JRDMcLAREN/proteus-V2.0/readme_pinout.md

# Proteus Pinout & Wiring

### [Please use the official rusEfi Proteus docs here.](https://github.com/rusefi/rusefi/wiki/Proteus-Manual)
