JRDMcLAREN/proteus-V2.0/proteus.csv

Id | Designator | Footprint | Quantity | Designation | Supplier and ref
1 | C1015,C1016,C1017,C1018,C1523,C1002,C1212 | C_0603_1608Metric | 7 | 1u
2 | R902,R903,R904,R901,R801,R704,R804,R803,R802,R703,R702,R701,R1903,R1904 | R_0603_1608Metric | 14 | 470k
3 | R1007,R1006,R1502,R1504,R1001,R1513,R5,R6,R7,R8,R13,R14,R15,R16,R21,R22,R23,R24,R29,R30,R32,R31,R905,R1105,R1107,R1109,R1111,R48 | R_0603_1608Metric | 28 | 10k
4 | U801,U901,U1101,U701,U5 | TSSOP-14_4.4x5mm_P0.65mm | 5 | MCP6004
5 | U1004,U1005 | Infineon_PG-DSO-8-43 | 2 | TLS115
6 | C701,C801,C901,C1503,C1505,C1501,C1101,C1516,C1508,C1509,C1510,C1511,C1513,C1504,C1604,C1607,C1701,C1704,C1801,C1804,C1211,C1409,C1517,C904,C1520,C20 | C_0603_1608Metric | 26 | 100n
7 | C1518,C1519 | C_0603_1608Metric | 2 | 2.2u
8 | C1521,C1522 | C_0603_1608Metric | 2 | 33p
9 | C1506,C1507,C1502,C1515,C1006,C1512,C903,C30 | C_0603_1608Metric | 8 | 4.7u
10 | FB1501 | L_0805_2012Metric | 1 | Ferrite_Bead
11 | R1101,R1102,R1103,R1104,R1203,R1204,R1401,R1402,R1407,R1408,R1201,R1202,R1403,R1404,R1405,R1406 | R_0603_1608Metric | 16 | 2.7k
12 | RN701,RN801,RN901,RN1101,RN1301 | R_Array_Convex_4x0603 | 5 | 10k
13 | C1201,C1004,C906,C18,C19,C27 | C_1206_3216Metric | 6 | 10u
14 | C1202,C1203,C1301,C1302,C1304,C1605,C1606,C1608,C1609,C1702,C1703,C1705,C1706,C1802,C1803,C1806,C1805,C902,C1303,C1903,C28,C29 | C_0603_1608Metric | 22 | 10n
15 | R1501,R44,R45,R1901,R1902 | R_0603_1608Metric | 5 | 100k
16 | U1501 | LQFP-144_20x20mm_P0.5mm | 1 | STM32F427ZGTx
17 | R1004,R1106,R1108,R1110,R1112,R33 | R_0603_1608Metric | 6 | 120
18 | U502,U501,U402,U401,U302,U301,U202,U201 | SOIC-8_3.9x4.9mm_P1.27mm | 8 | VNLD5160
19 | RN501,RN401,RN201,RN301,RN202,RN302,RN402,RN502,RN1601,RN1701,RN1801 | R_Array_Convex_4x0603 | 11 | 1k
20 | D903,D901,D101,D102,D103,D104 | D_SMA | 6 | D_Schottky
21 | R1601,R1602,R1603,R1604,R1701,R1702,R1703,R1704,R1801,R1802,R1803,R1804 | R_0805_2012Metric | 12 | 100
22 | U1602,U1603,U1701,U1702,U1801,U1802 | SOIC-8_3.9x4.9mm_P1.27mm | 6 | MIC4427
23 | D1502,D1506 | LED_0603_1608Metric_Castellated | 2 | GREEN
24 | R1508,R1509,R1510,R1511,R1512 | R_0603_1608Metric | 5 | 330
25 | R1215,R1216,R1205,R1206,R1208,R1209,R1211,R1213,R1214,R1210,R34,R35,R36,R37 | R_0805_2012Metric | 14 | 4.7k
26 | U1203,U1204 | MSOP-10_3x3mm_P0.5mm | 2 | MAX9924
27 | C1208,C1402,C1407,C1408,C1209,C1210,C1401,C1207,C1406,C1204,C1205,C1403,C1404,C1405 | C_0603_1608Metric | 14 | 1n
28 | R1212,R1207 | R_0805_2012Metric | 2 | DNP
29 | D1503,D3,D4 | D_SOD-123 | 3 | schottky
30 | F101,F102 | R_1206_3216Metric | 2 | Polyfuse
31 | D1504 | LED_0603_1608Metric_Castellated | 1 | RED
32 | D1505 | LED_0603_1608Metric_Castellated | 1 | BLUE
33 | D1507 | LED_0603_1608Metric_Castellated | 1 | ORANGE
34 | J105,J107,J108 | TestPoint_Pad_D3.0mm | 3 | Conn_01x01
35 | U1502 | SOT-23-6 | 1 | USBLC6-2SC6
36 | D1,D2 | SOT-323_SC-70 | 2 | PESD1CAN-UX
37 | J1504 | conn_5_2.5mm | 1 | USB_B
38 | D1001 | D_SMC | 1 | SM15T33CA
39 | R2,R3,R10,R11,R12,R17,R18,R19,R20,R25,R26,R27,R28,R4,R9,R1 | R_0603_1608Metric | 16 | 5.6k
40 | U1,U2,U3,U4,D1501,U1106,U1107 | SOT-23-6 | 7 | SRV05-4
41 | C23,C24,C905 | C_0603_1608Metric | 3 | 330p
42 | R46,R47,R38,R40 | R_0603_1608Metric | 4 | 33k
43 | ,,,,,,,,,,,,,,,,,,,,,,,,,,,,,,,,,,,,,,,,,,,,,,,,,,,,,,,,,,,,,,,,,,,,,,,,,,,,,,,,,,,,,,,,,,,,,,,,,,,,,,,,,,,,,,,,,,,,,,,,,,,,,,,,,,,,,,,,,,,,,,,,,,,,,,,,,,,,,,,,,,,,,,,,,,,,,,,,,,,,,,,,,,,,,,,,,,,,,,,,,,,,,,,,,,,,,,,,,,,,,,,,,,,,,,,,,,,,,,,,,,,,,,,,,,,,,,,,,,,,,,,,,,,,,,,,,,,,,,,,,,,,,,,,,,,,,,,,,,,,,,,,,,,,,,,,,,,,,,,,,,,,,,,,,,,,,,,,,,,,,,,,,, |  | 347
44 | R906 | R_0603_1608Metric | 1 | 1
45 | U902 | SOT-223-3_TabPin2 | 1 | AMS1117-3.3
46 | Y1501 | Crystal_SMD_5032-2Pin_5.0x3.2mm | 1 | 8MHz
47 | R908 | R_0603_1608Metric | 1 | 68k
48 | U903 | SOIC-8-1EP_3.9x4.9mm_P1.27mm_EP2.29x3mm | 1 | LMR14020
49 | U904,U6 | SOIC-8_3.9x4.9mm_P1.27mm | 2 | TJA1051T-3
50 | R907,R42,R43 | R_0603_1608Metric | 3 | 12k
51 | REF**,REF**,REF** | Fiducial_1.5mm_Mask3mm | 3 | Fiducial_1.5mm_Mask3mm
52 | R1217,R1218,R39,R41 | R_0603_1608Metric | 4 | 1k
53 | R1219,R1220 | R_0805_2012Metric_Pad1.15x1.40mm_HandSolder | 2 | DNP
54 | L1002 | L_1210_3225Metric | 1 | 2.2u
55 | U1103,U1104,U1105,U1102 | SOIC-8_3.9x4.9mm_P1.27mm | 4 | BTS4175SGA
56 | L1001 | MWSA0503 | 1 | 10u
57 | C1901,C1902 | C_0805_2012Metric | 2 | 3.3n
58 | C21,C22 | C_0603_1608Metric | 2 | 680p
59 | C25,C26 | C_0603_1608Metric | 2 | 47p
60 | U1207,U1202,U1208 | SOT-23-6 | 3 | SN74LVC2G17DB
61 | JP1,JP2 | SolderJumper-2_P1.3mm_Open_TrianglePad1.0x1.5mm | 2 | Jumper_NO_Small
62 | J1 | microSD_HC_Wuerth_693072010801 | 1 | Micro_SD_Card
63 | J3 | Jack_3.5mm_CUI_SJ1-3533NG_Horizontal | 1 | AudioJack3
64 | U7 | SOIC-8_3.9x4.9mm_P1.27mm | 1 | MCP6002-xSN
65 | U8 | SOT-23 | 1 | REF3333
66 | U9 | ST_HLGA-10_2.5x2.5mm_P0.6mm_LayoutBorder3x2y | 1 | LPS25HB
67 | SW1501,SW1502 | SW_SPST_EVQQ2 | 2 | SW_Push
68 | J4 | Tag-Connect_TC2030-IDC-NL_2x03_P1.27mm_Vertical | 1 | Conn_01x06
69 | U10,U11 | Infineon_PG-DSO-12-9 | 2 | TLE9201SG
70 | R1503 | R_0603_1608Metric | 1 | 82k
71 | J1505 | PinHeader_2x06_P2.54mm_Vertical | 1 | Conn_02x06_Top_Bottom
72 | C17x1,C1001x1 | CP_Elec_6.3x9.9 | 2 | 56u
73 | J5 | PinSocket_2x01_P2.54mm_Vertical | 1 | Conn_01x02
74 | CN1,CN3,CN2,CN4 | R_Array_Convex_4x0603 | 4 | 100n
75 | JP1201 | SolderJumper-3_P1.3mm_Bridged12_RoundedPad1.0x1.5mm | 1 | Jumper_3_Bridged12
76 | TP-OUT4 | TestPoint_Pad_D1.0mm | 1 | TestPoint-OUT4
77 | LOGO | mre_logo | 1 | LOGO
78 | TP-IN4 | TestPoint_Pad_D1.0mm | 1 | TestPoint-IN4
79 | C1001,C17 | CP_Radial_D8.0mm_P3.50mm | 2 | 56u
80 | J102 | ampseal-35 | 1 | Conn_01x35
81 | J103 | ampseal-35-2 | 1 | Conn_01x35
82 | J101 | ampseal-23 | 1 | Conn_01x23
83 | J1501 | USB_B_TE_5787834_Vertical | 1 | USB_B
84 | BT1 | BatteryHolder_Keystone_1060_1x2032 | 1 | Battery_Cell
85 | JP3,JP4 | SolderJumper-2_P1.3mm_Bridged_Pad1.0x1.5mm | 2 | SolderJumper_2_Bridged
86 | PB15 | TestPoint_Pad_D1.0mm | 1 | PB15
87 | J1506 | USB_Micro-B_Wuerth_614105150721_Vertical | 1 | USB_B_Micro
88 | PG15 | TestPoint_Pad_D1.0mm | 1 | PG15
89 | J1507 | PinSocket_2x05_P2.54mm_Vertical_SMD | 1 | Conn_02x05_Odd_Even
90 | PB14 | TestPoint_Pad_D1.0mm | 1 | PB14
