JRDMcLAREN/proteus-V2.0/export/proteus-case.step

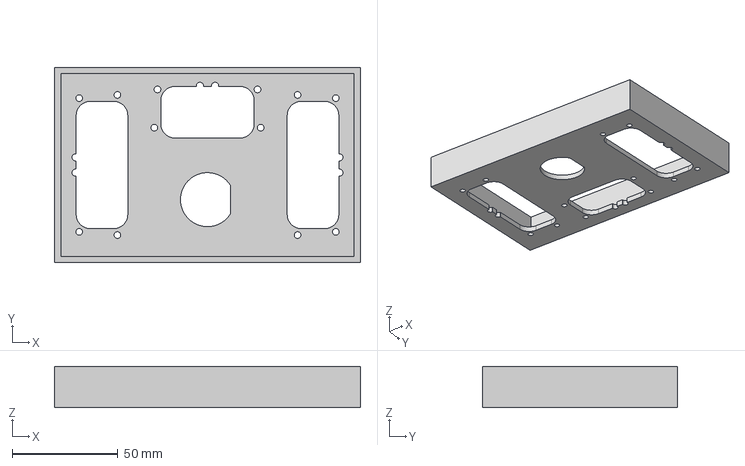
[picture p1: CAD file, 2026-11-01]
export/proteus-case.step
145.0 x 92.5 x 19.6 mm
