JRDMcLAREN/proteus-V2.0/changelog.md

# Changelog

## Proteus 2.0  - November 2026
 - 2-layer version
 - All passive components are size 0603 (uniform size)
 - MicroUSB socket added
 - Board completely redesigned; components, traces, etc.
 - 4x M3.5 mounting holes added
 - Alternative footprints added on the TOP side for electrolytic capacitors (C17, C1001)
 - AUX connectors for SPI and UART consolidated into a single 2x6-pin header (including power supply)
 - 2-pin connector added for an (external) RTC battery
 - Programming connector changed to a 2x5-pin header for the ST-Link programmer (matching the MRE)
 - Solder pads added for "RX/TX swapping" – for communication modules that require these signals to be swapped.
 
## Proteus 0.7
 - Reduce BOM lines somewhat, replacing similar components with identical components.
 - Add RTC/backup battery

## Proteus 0.6
 - Switch to TLE9202 ETB driver due to shortage of TLE9201
 - Switch to STM32F767ZG due to shortage of STM32F42x

## Proteus 0.4
 - knock sense with headset jack
 - SD card
 - USB removed from 23 pin connector

## Proteus 0.3
 - first large batch
 - incompatible pinout change mostly on the 23 pin plug

## Proteus 0.2
 - USB footprint fix

## Proteus 0.1
 - it's alive!!!
