JRDMcLAREN/proteus-V2.0/export/v2.0/proteus_schematic_v2.0.pdf

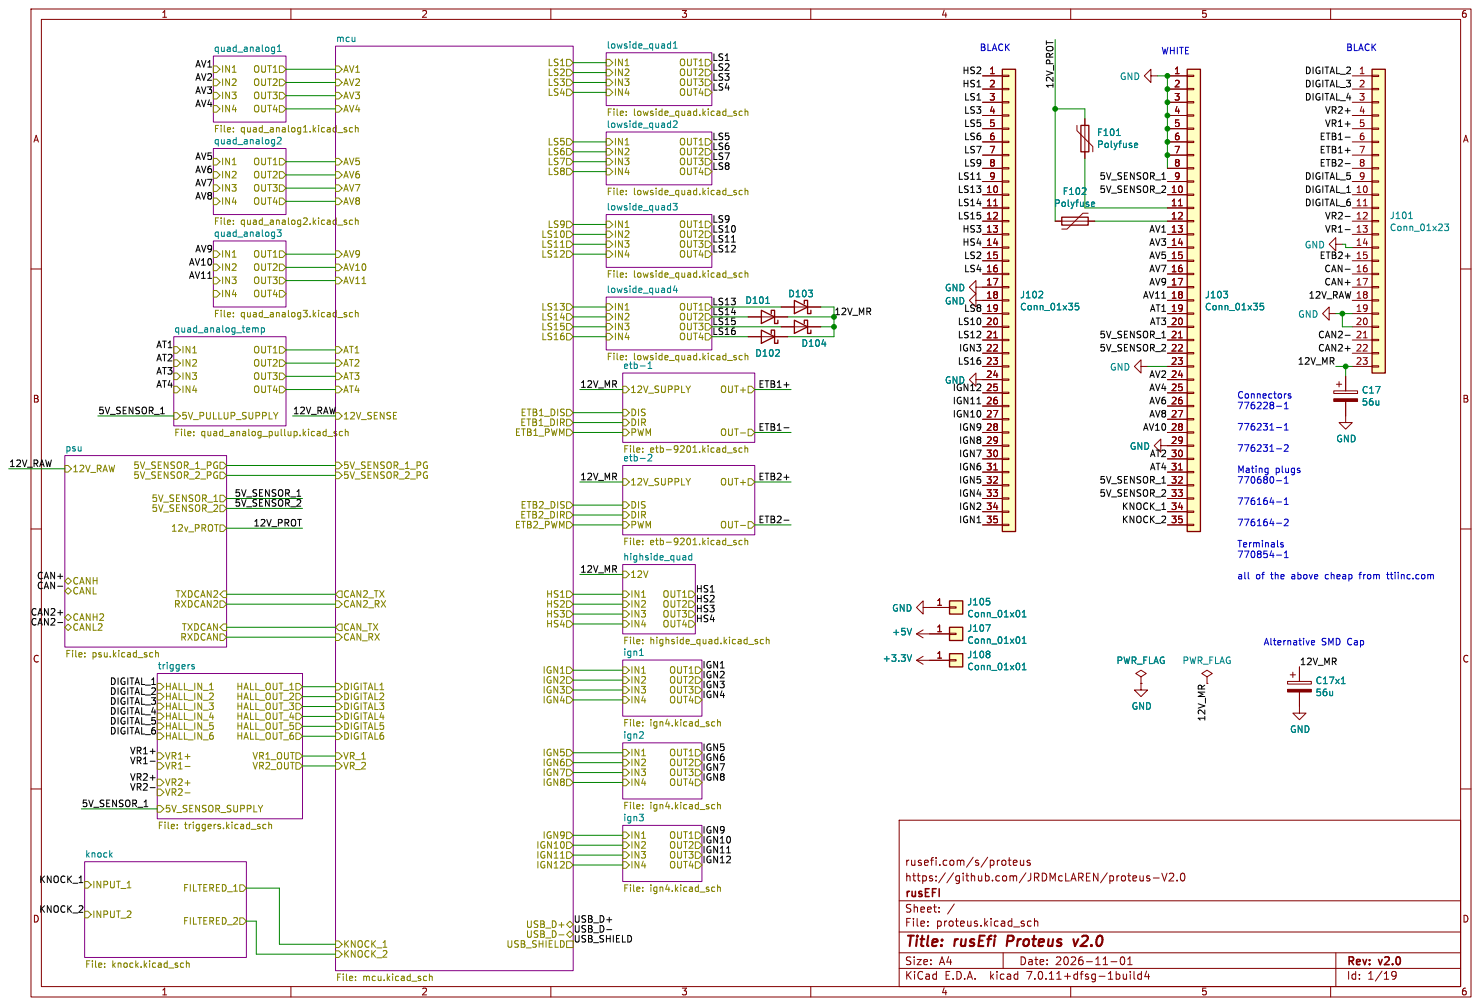
[picture p2: page 1]

all of the above cheap from ttiinc.com

rusefi.com/s/proteus
File: proteus.kicad_sch Sheet: / rusEFI https://github.com/JRDMcLAREN/proteus-V2.0

Id: 1/19 Title: rusEfi Proteus v2.0

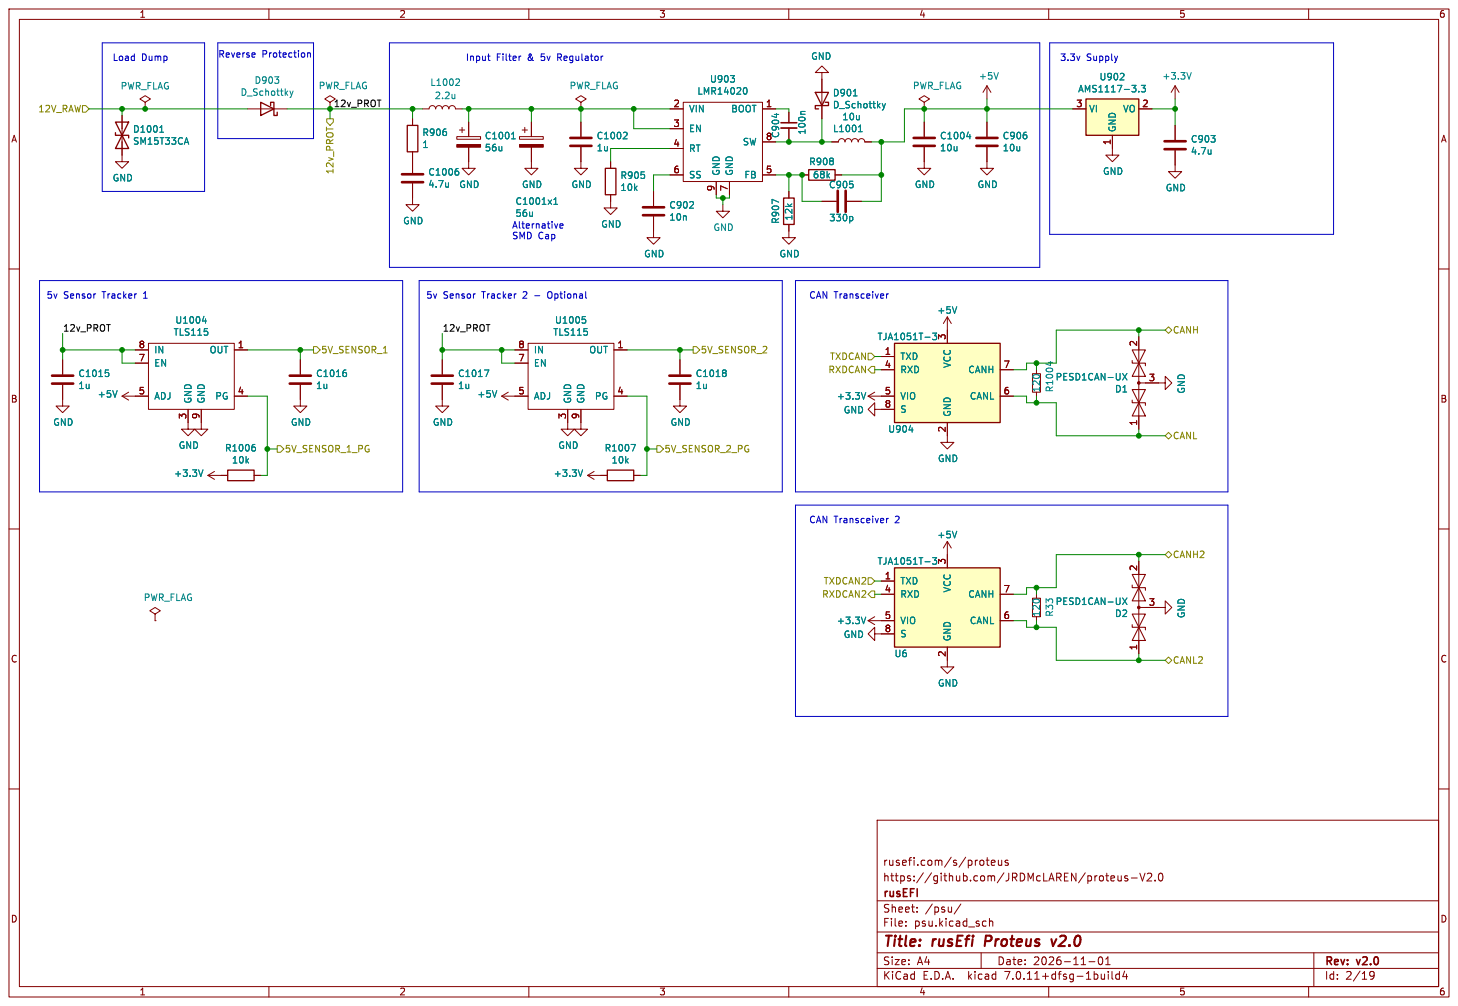
[picture p3: page 2]

3 RXD 4 VIO 5 CANL 6 CANH 7 S
8 U6 TJA1051T-3 GND

rusefi.com/s/proteus GND

File: psu.kicad_sch Sheet: /psu/ rusEFI https://github.com/JRDMcLAREN/proteus-V2.0

Id: 2/19 Title: rusEfi Proteus v2.0

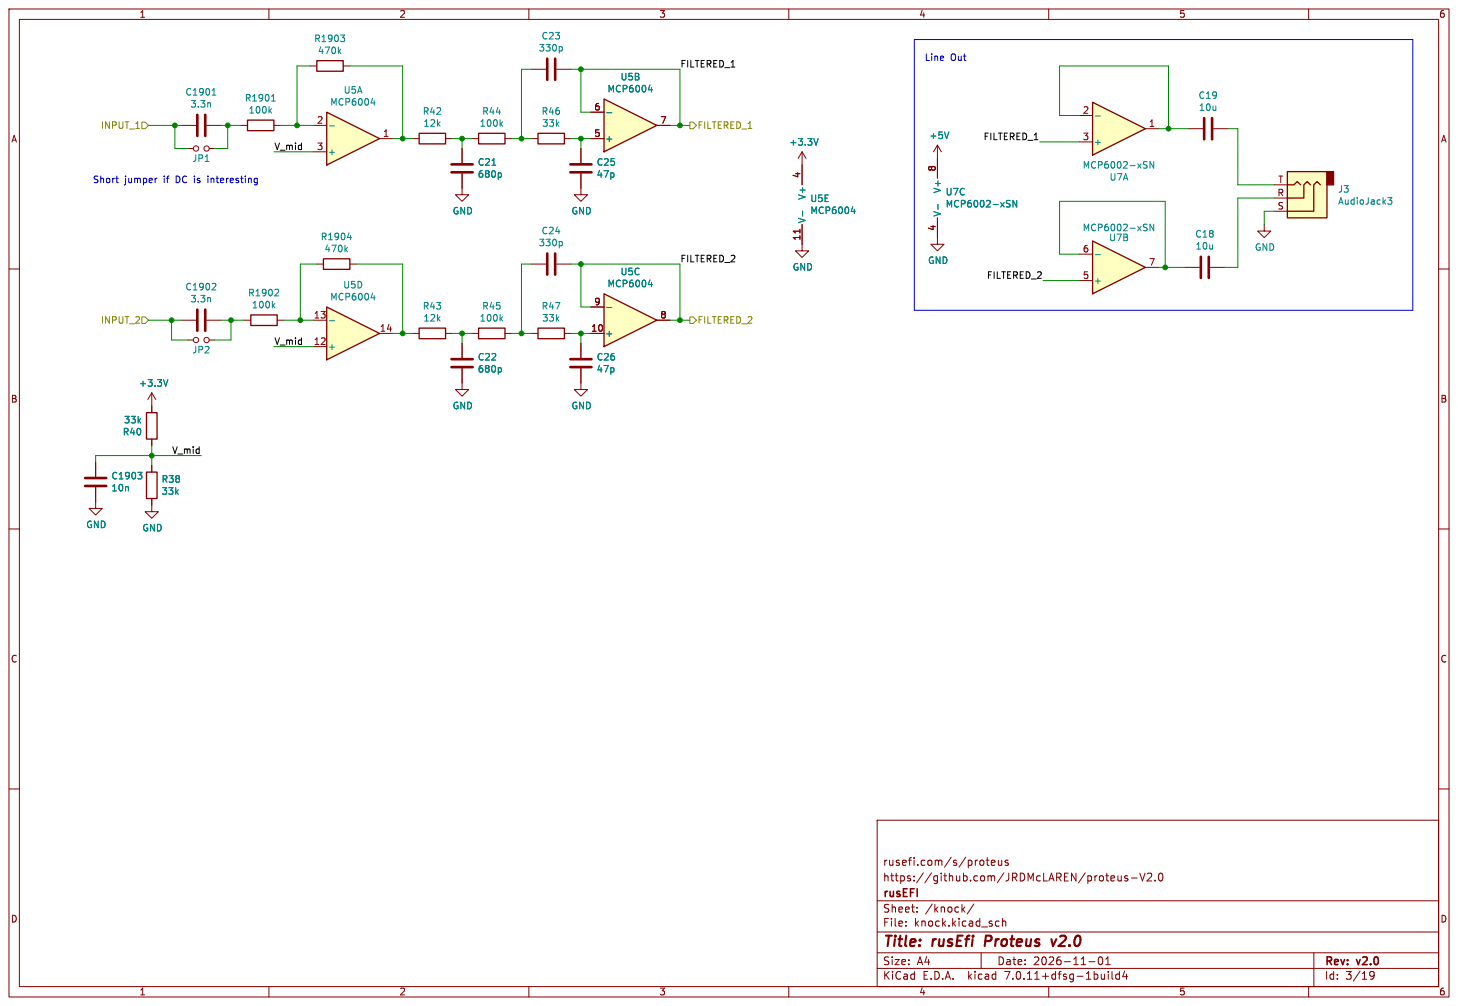
[picture p4: page 3]

rusefi.com/s/proteus
File: knock.kicad_sch Sheet: /knock/ rusEFI https://github.com/JRDMcLAREN/proteus-V2.0

Id: 3/19 Title: rusEfi Proteus v2.0

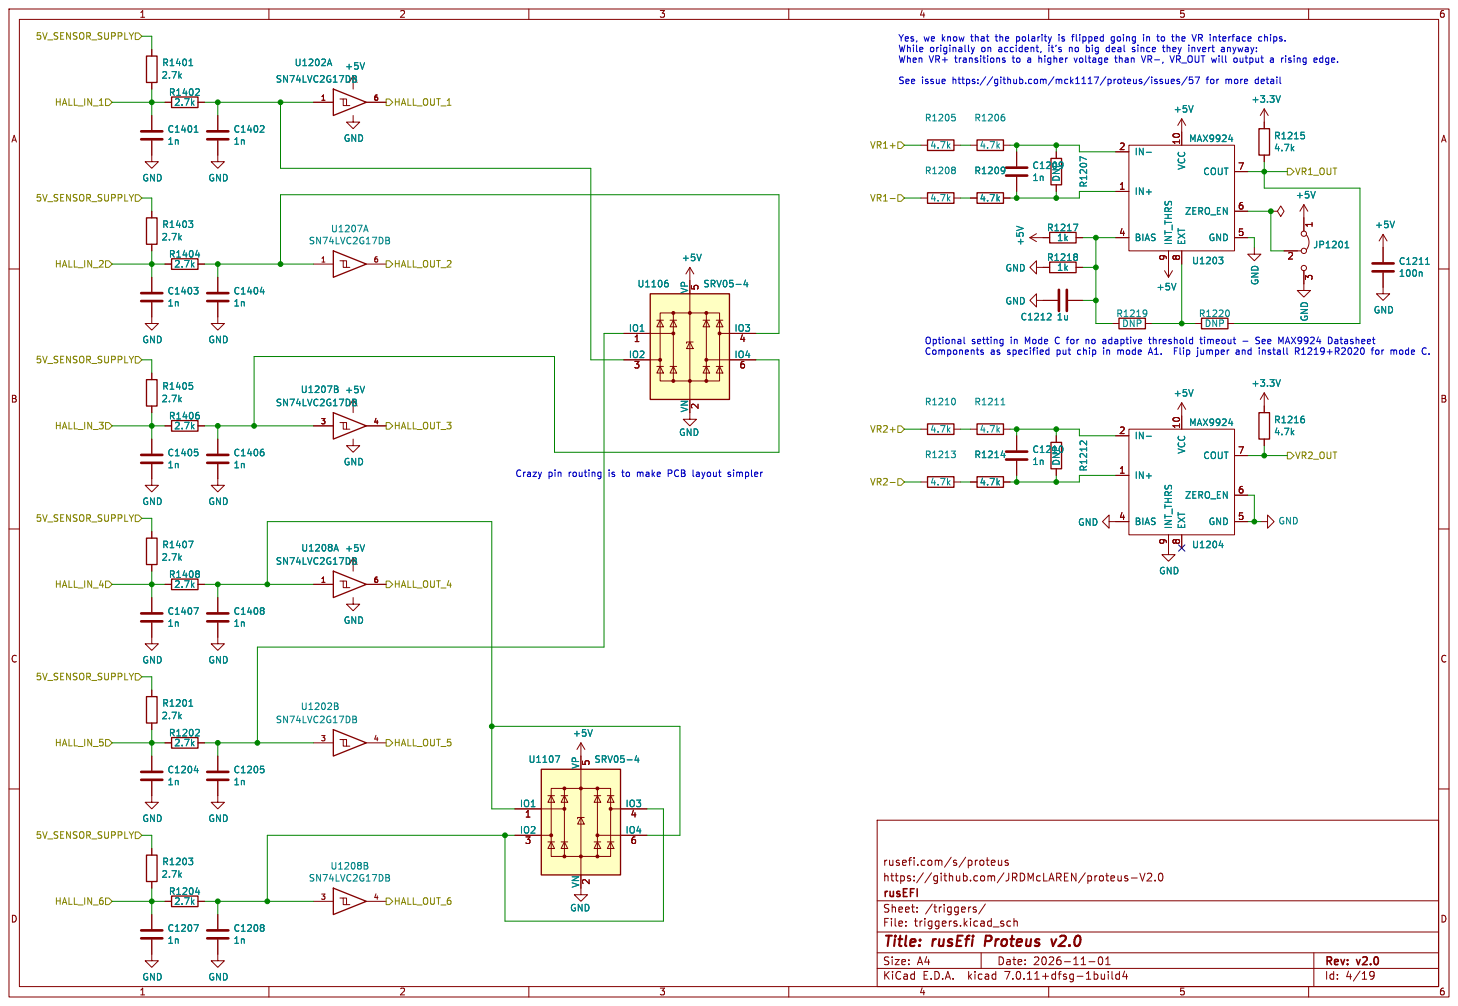
[picture p5: page 4]

9U1204 MAX9924 GND R1212 DNP GND GND

File: triggers.kicad_sch Sheet: /triggers/ rusEFI https://github.com/JRDMcLAREN/proteus-V2.0

Id: 4/19 Title: rusEfi Proteus v2.0

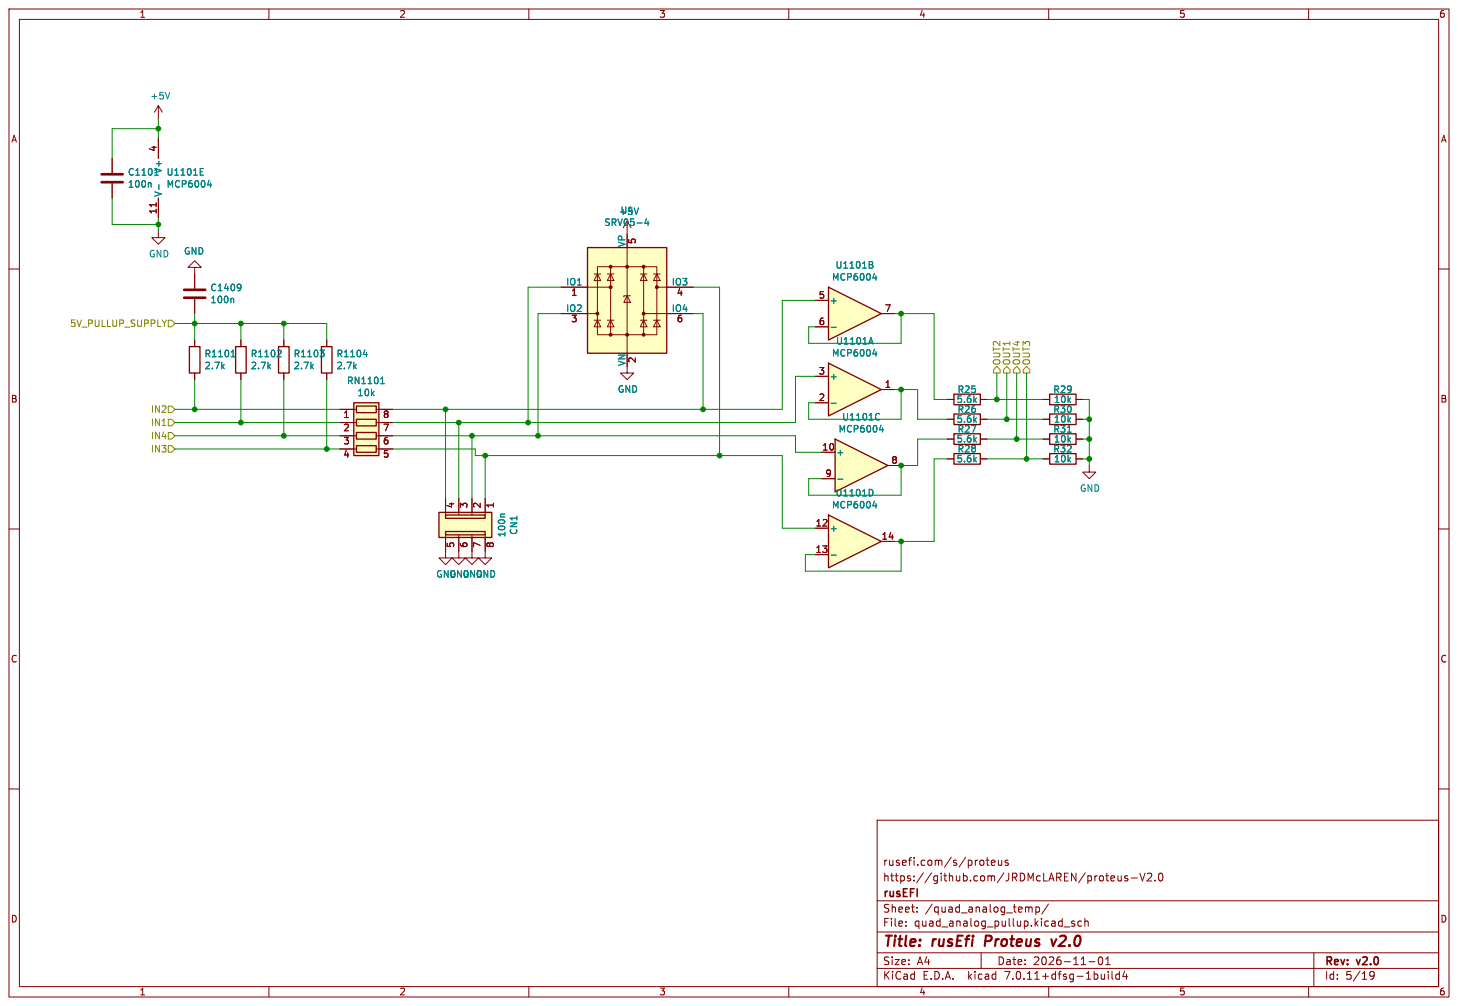
[picture p6: page 5]

7 7 | R27
6 6

rusefi.com/s/proteus GND

File: quad_analog_pullup.kicad_sch Sheet: /quad_analog_temp/ rusEFI https://github.com/JRDMcLAREN/proteus-V2.0

Id: 5/19 Title: rusEfi Proteus v2.0

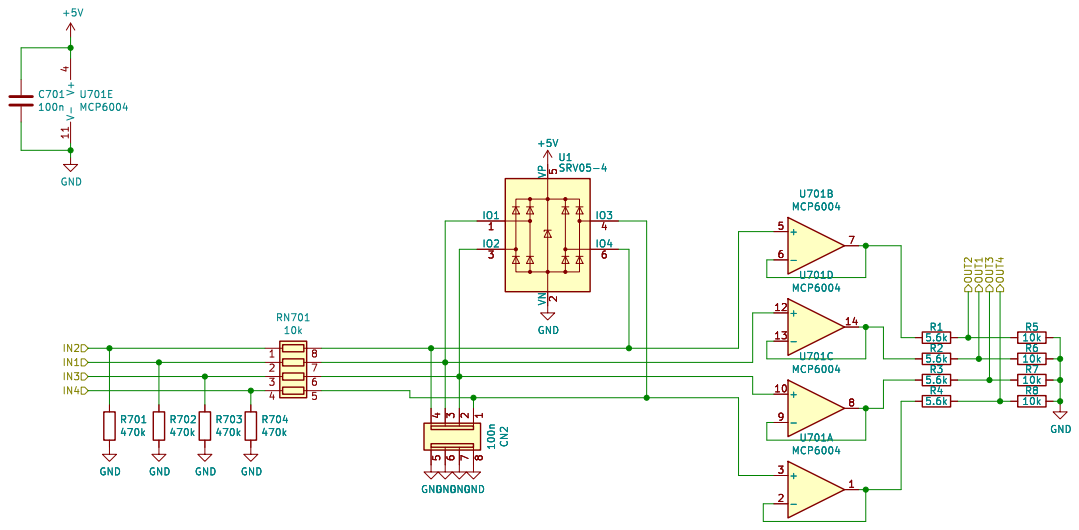
[picture p7: page 6]

File: quad_analog1.kicad_sch Sheet: /quad_analog1/ rusEFI https://github.com/JRDMcLAREN/proteus-V2.0

Id: 6/19 Title: rusEfi Proteus v2.0

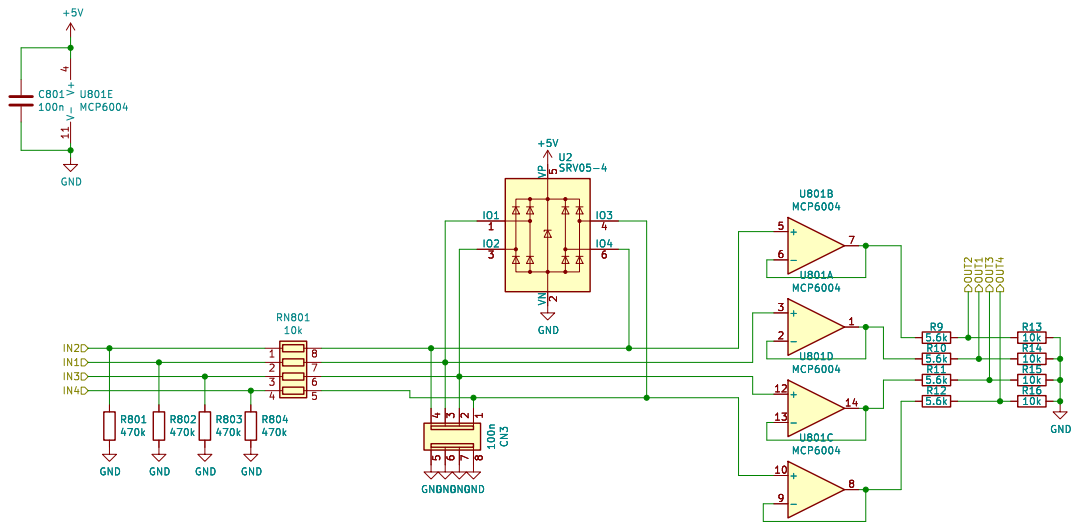
[picture p8: page 7]

rusefi.com/s/proteus GND

File: quad_analog2.kicad_sch Sheet: /quad_analog2/ rusEFI https://github.com/JRDMcLAREN/proteus-V2.0

Id: 7/19 Title: rusEfi Proteus v2.0

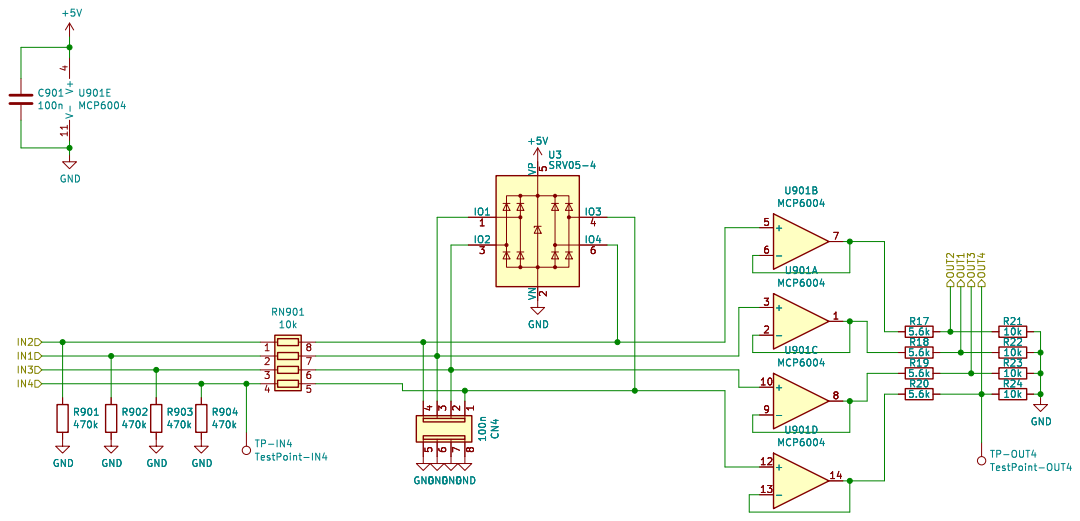
[picture p9: page 8]

rusefi.com/s/proteus
File: quad_analog3.kicad_sch Sheet: /quad_analog3/ rusEFI https://github.com/JRDMcLAREN/proteus-V2.0

Id: 8/19 Title: rusEfi Proteus v2.0

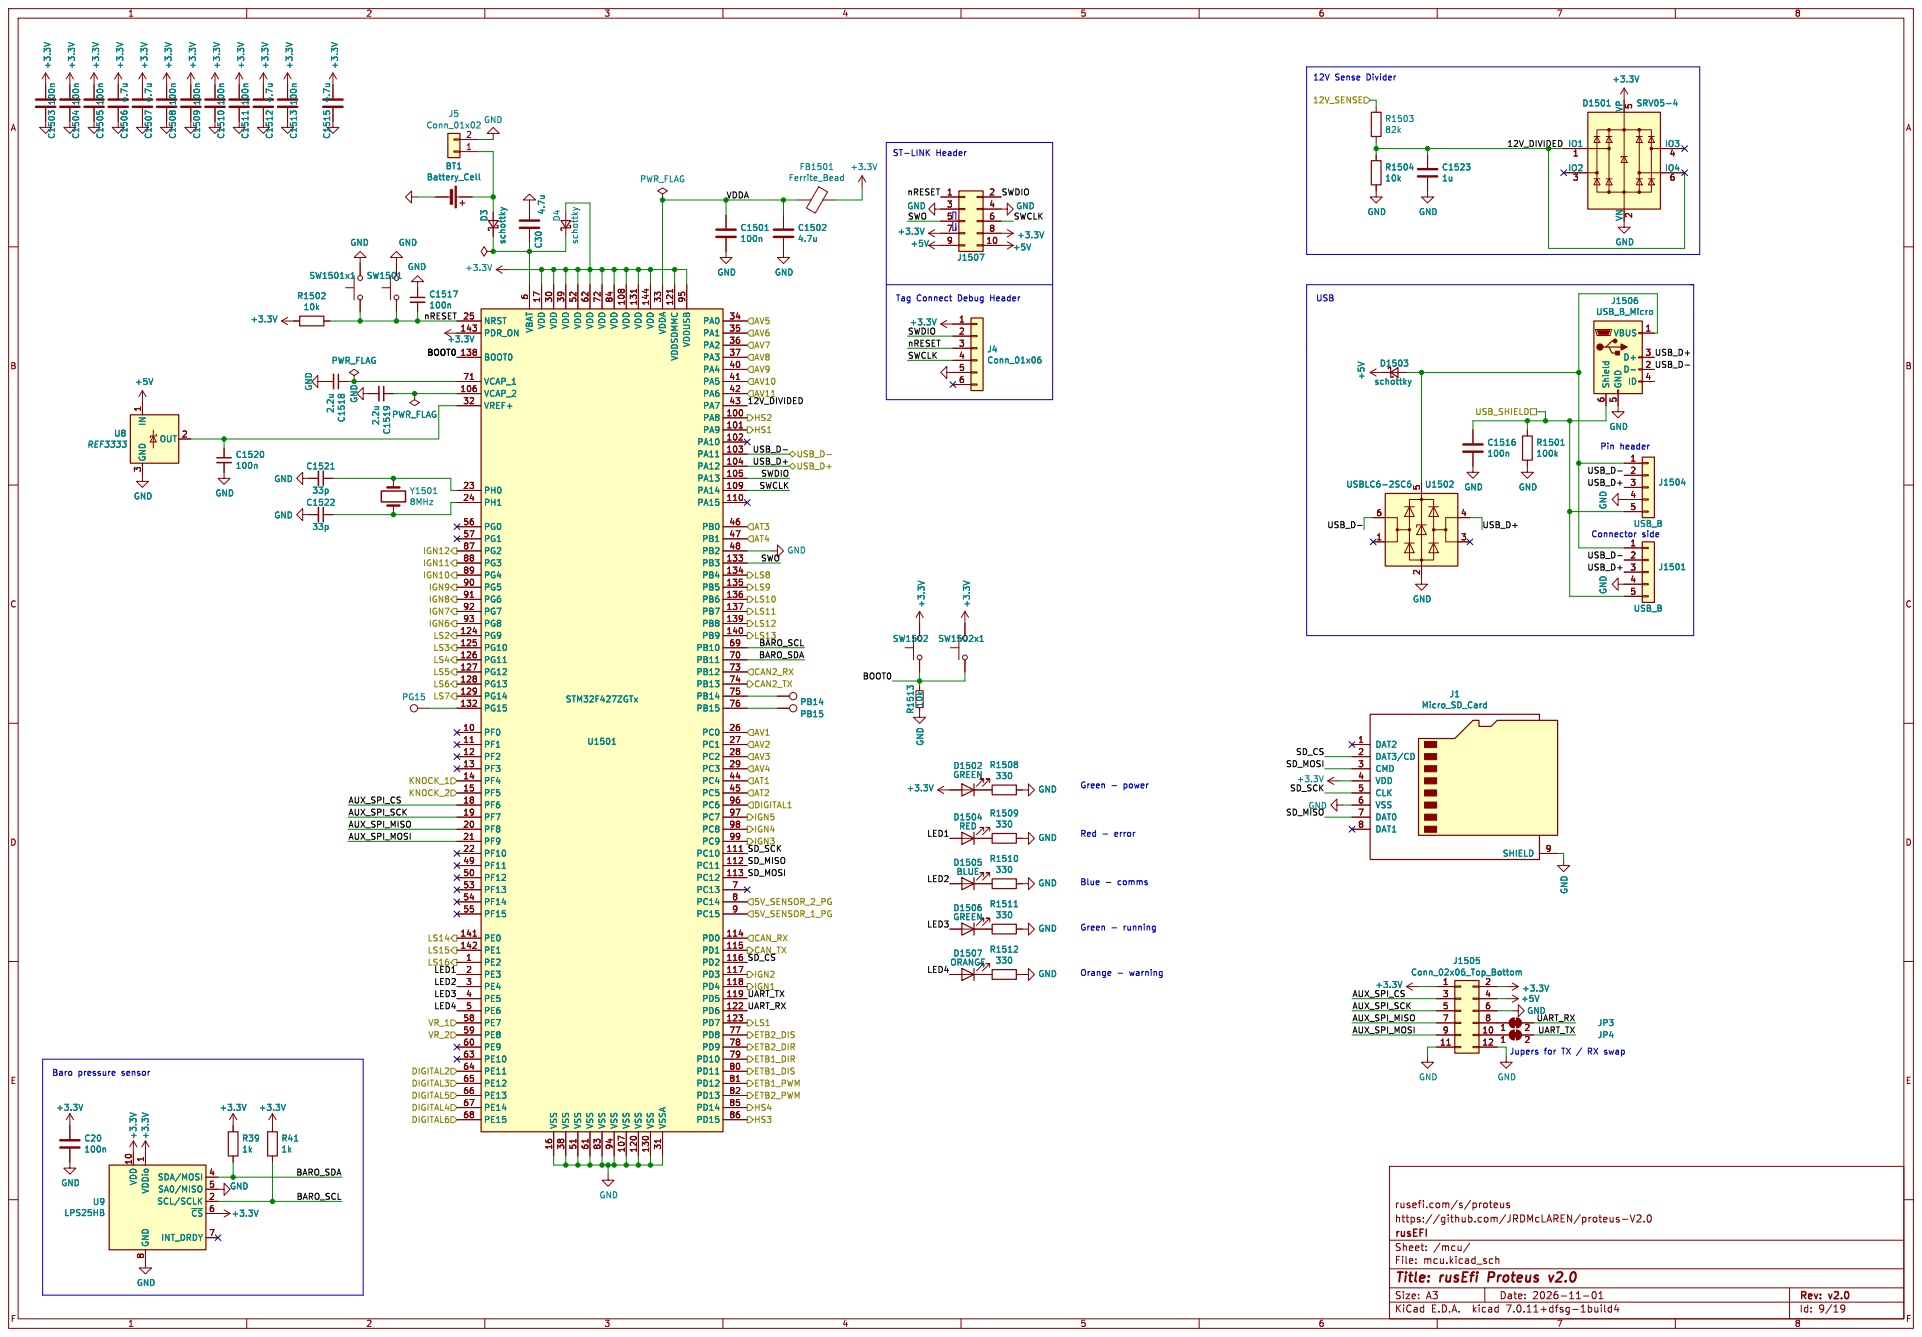
[picture p10: page 9]

Pin header Blue - comms

+3.3VGND R1513 10k
Green - power Orange - warning Green - running

1 VDD 10 SCL/SCLK 2 SDA/MOSI 4 SA0/MISO 5 ~{CS}6

rusefi.com/s/proteus
File: mcu.kicad_sch Sheet: /mcu/ rusEFI https://github.com/JRDMcLAREN/proteus-V2.0

Id: 9/19 Title: rusEfi Proteus v2.0

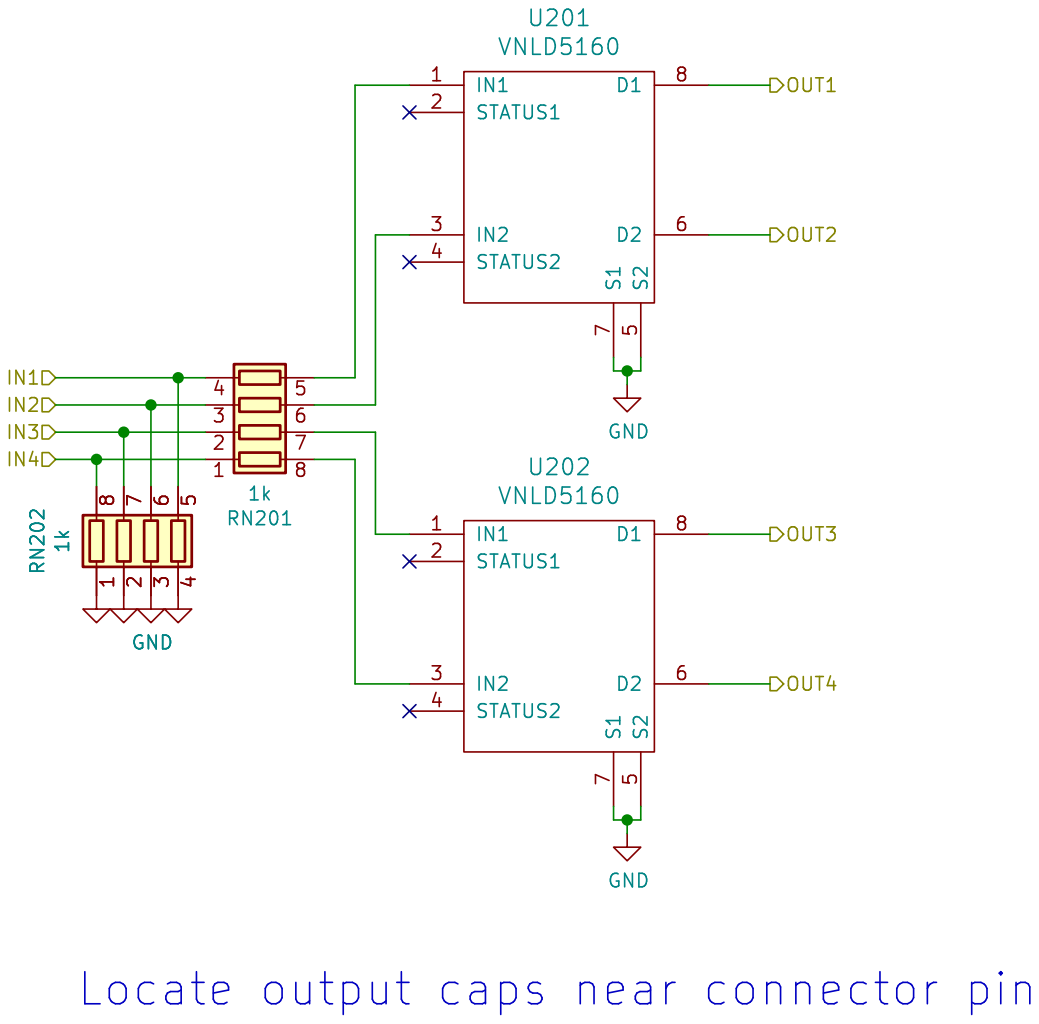
[picture p11: page 10]

rusefi.com/s/proteus
File: lowside_quad.kicad_sch Sheet: /lowside_quad1/ rusEFI https://github.com/JRDMcLAREN/proteus-V2.0

Id: 10/19 Title: rusEfi Proteus v2.0

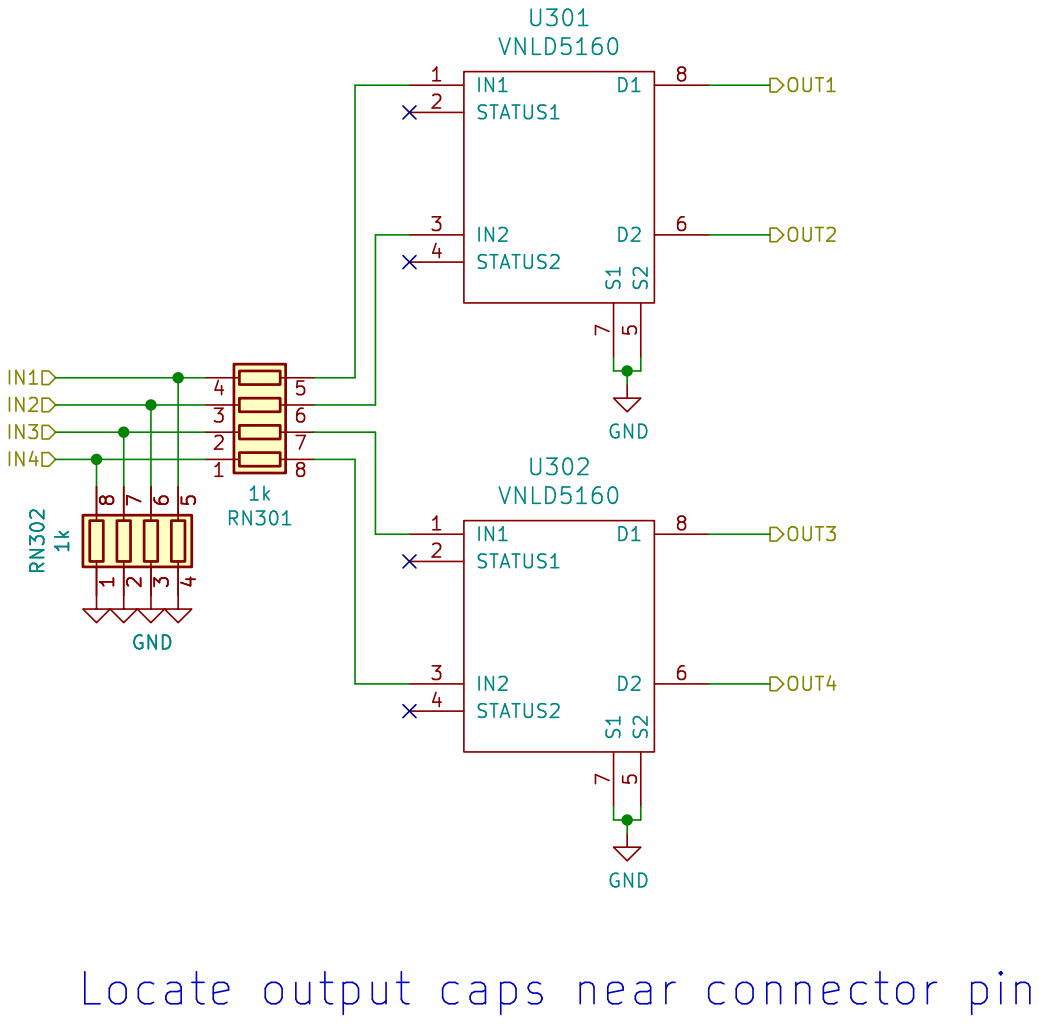
[picture p12: page 11]

rusefi.com/s/proteus
File: lowside_quad.kicad_sch Sheet: /lowside_quad2/ rusEFI https://github.com/JRDMcLAREN/proteus-V2.0

Id: 11/19 Title: rusEfi Proteus v2.0

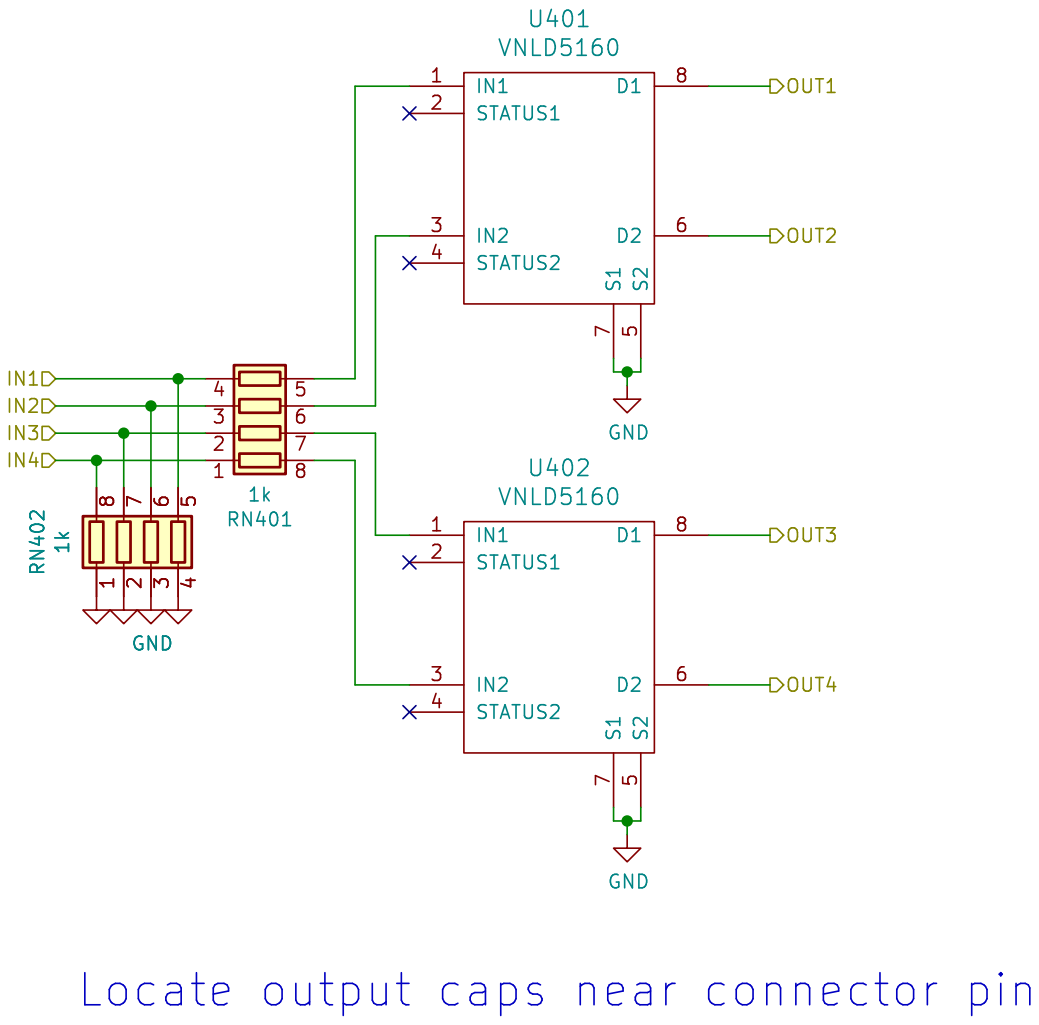
[picture p13: page 12]

rusefi.com/s/proteus
File: lowside_quad.kicad_sch Sheet: /lowside_quad3/ rusEFI https://github.com/JRDMcLAREN/proteus-V2.0

Id: 12/19 Title: rusEfi Proteus v2.0

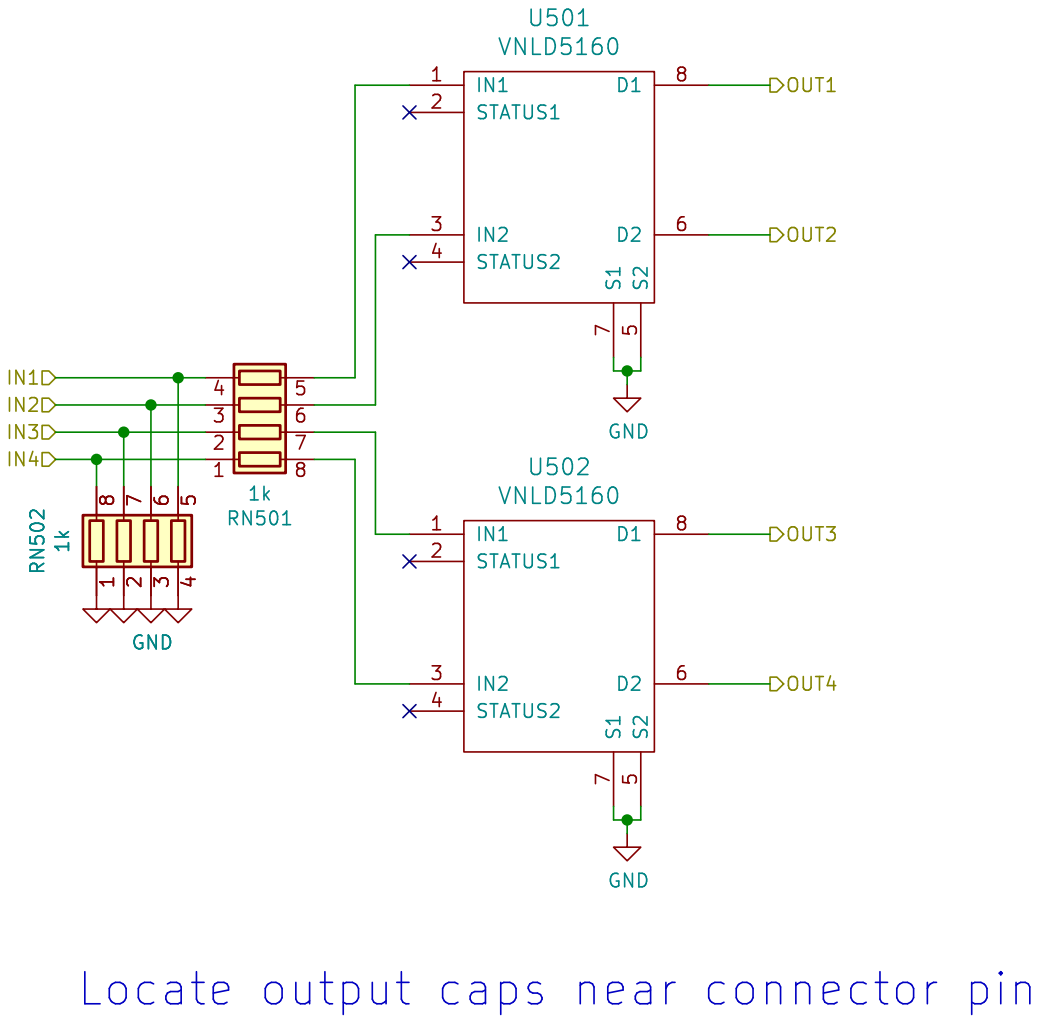
[picture p14: page 13]

rusefi.com/s/proteus
File: lowside_quad.kicad_sch Sheet: /lowside_quad4/ rusEFI https://github.com/JRDMcLAREN/proteus-V2.0

Id: 13/19 Title: rusEfi Proteus v2.0

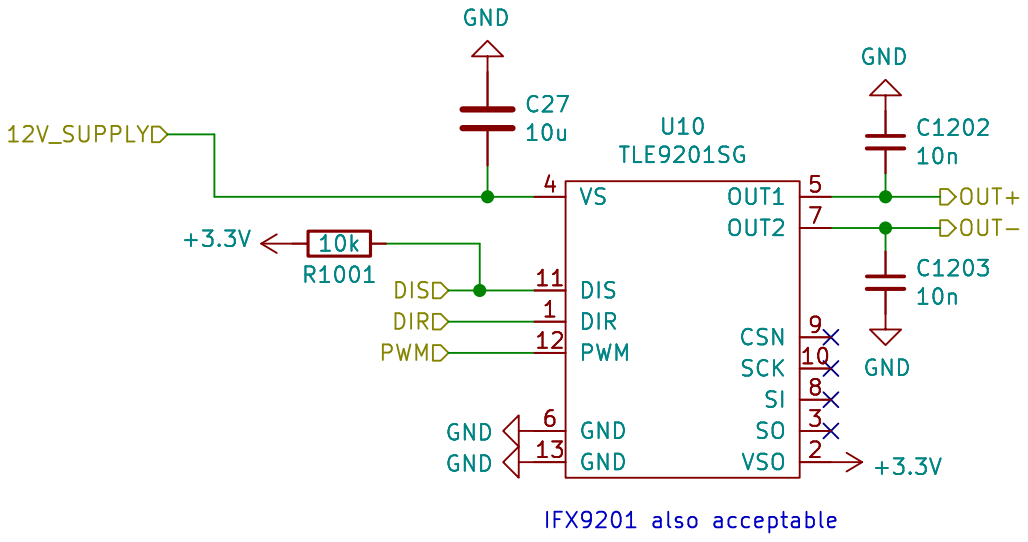
[picture p15: page 14]

rusefi.com/s/proteus
File: etb-9201.kicad_sch Sheet: /etb-1/ rusEFI https://github.com/JRDMcLAREN/proteus-V2.0

Id: 14/19 Title: rusEfi Proteus v2.0

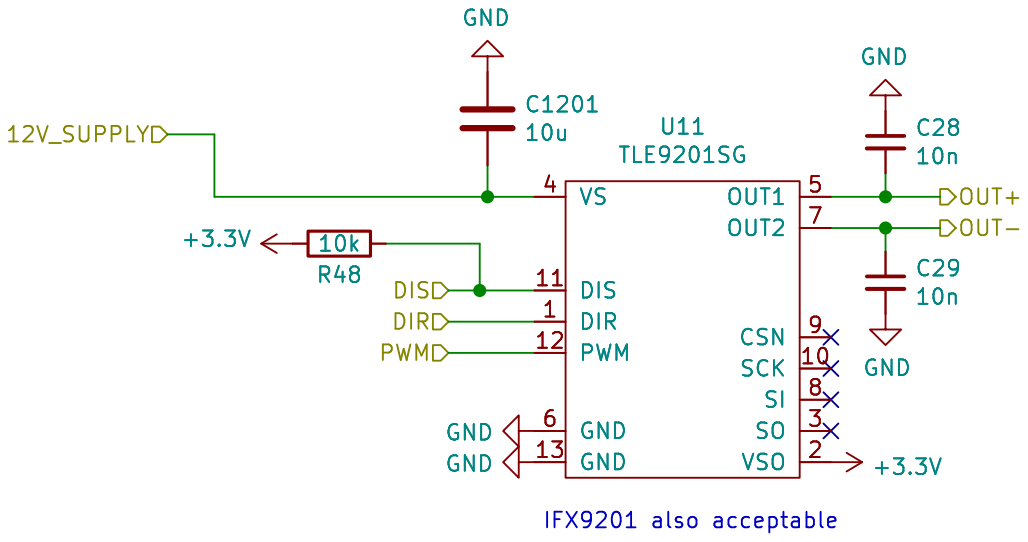
[picture p16: page 15]

rusefi.com/s/proteus
File: etb-9201.kicad_sch Sheet: /etb-2/ rusEFI https://github.com/JRDMcLAREN/proteus-V2.0

Id: 15/19 Title: rusEfi Proteus v2.0

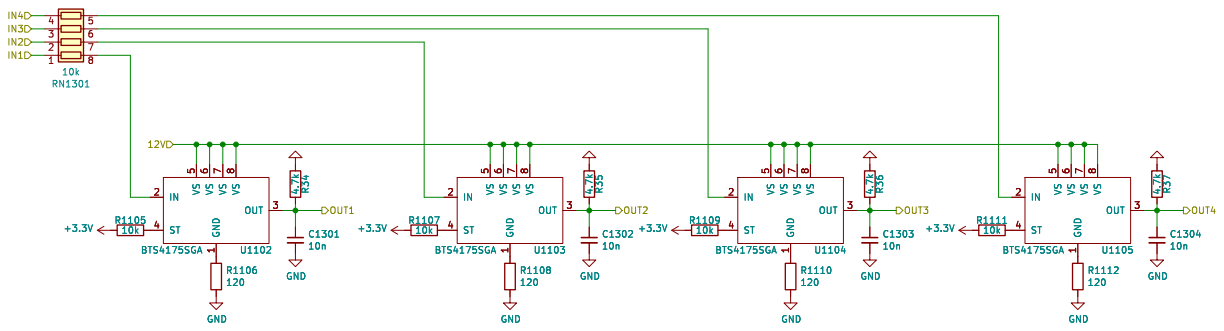
[picture p17: page 16]

File: highside_quad.kicad_sch Sheet: /highside_quad/ rusEFI https://github.com/JRDMcLAREN/proteus-V2.0

Id: 16/19 Title: rusEfi Proteus v2.0

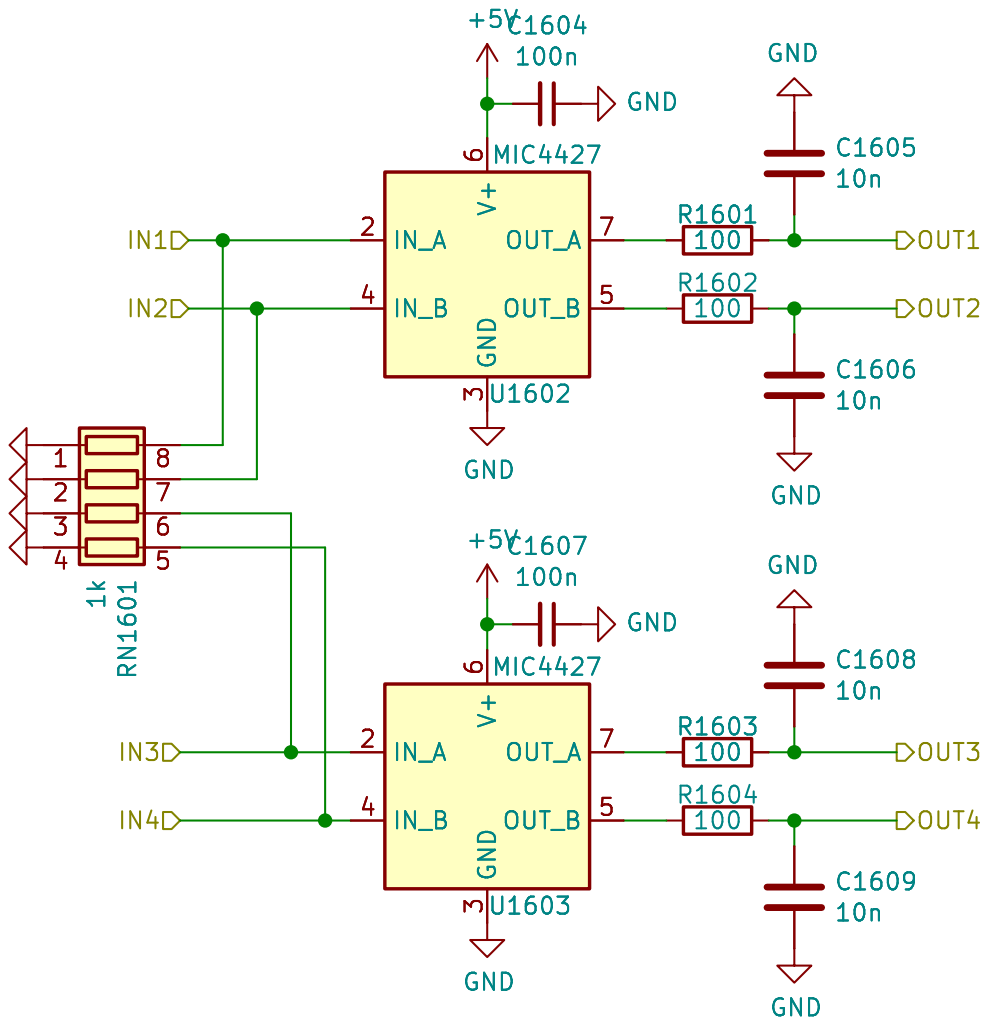
[picture p18: page 17]

rusefi.com/s/proteus
File: ign4.kicad_sch Sheet: /ign1/ rusEFI https://github.com/JRDMcLAREN/proteus-V2.0

Id: 17/19 Title: rusEfi Proteus v2.0

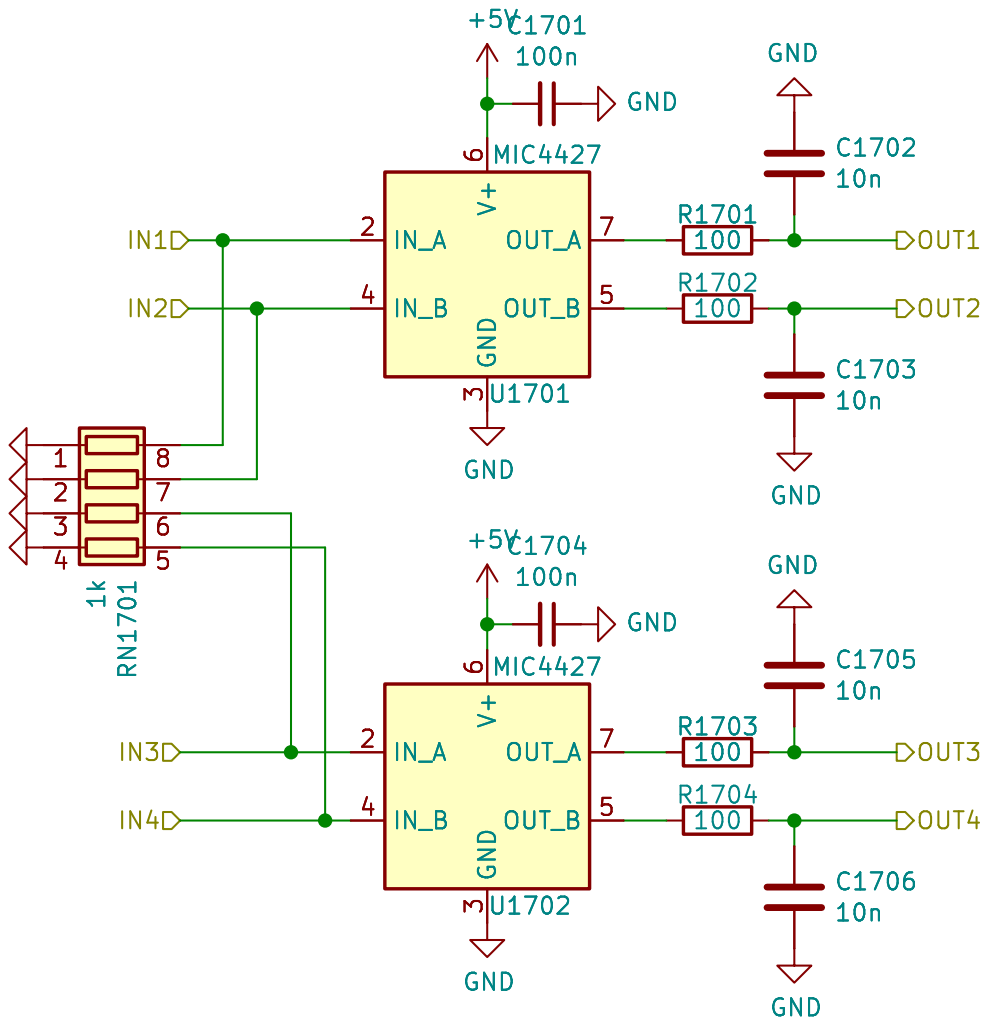
[picture p19: page 18]

rusefi.com/s/proteus
File: ign4.kicad_sch Sheet: /ign2/ rusEFI https://github.com/JRDMcLAREN/proteus-V2.0

Id: 18/19 Title: rusEfi Proteus v2.0

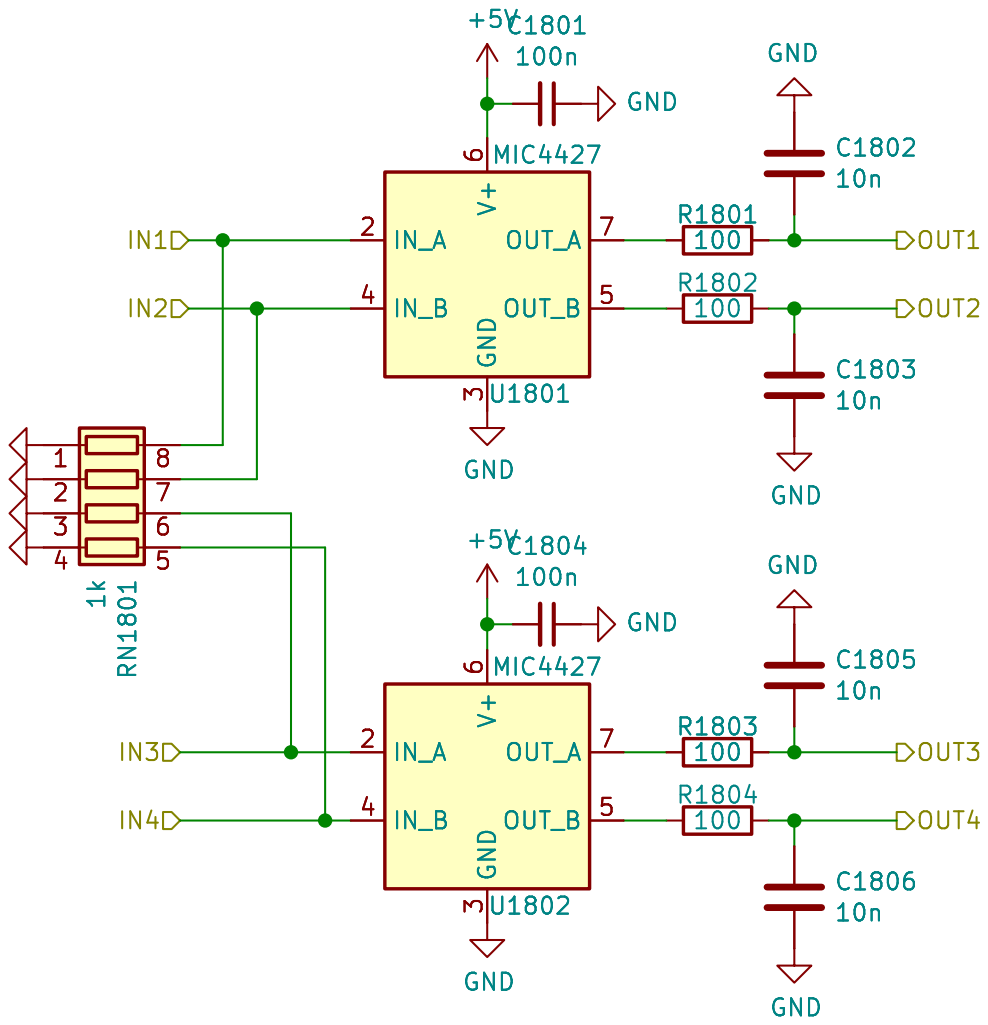
[picture p20: page 19]

rusefi.com/s/proteus
File: ign4.kicad_sch Sheet: /ign3/ rusEFI https://github.com/JRDMcLAREN/proteus-V2.0

Id: 19/19 Title: rusEfi Proteus v2.0
