JRDMcLAREN/proteus-V2.0/export/v0.7/proteus_0_7_schematic.pdf

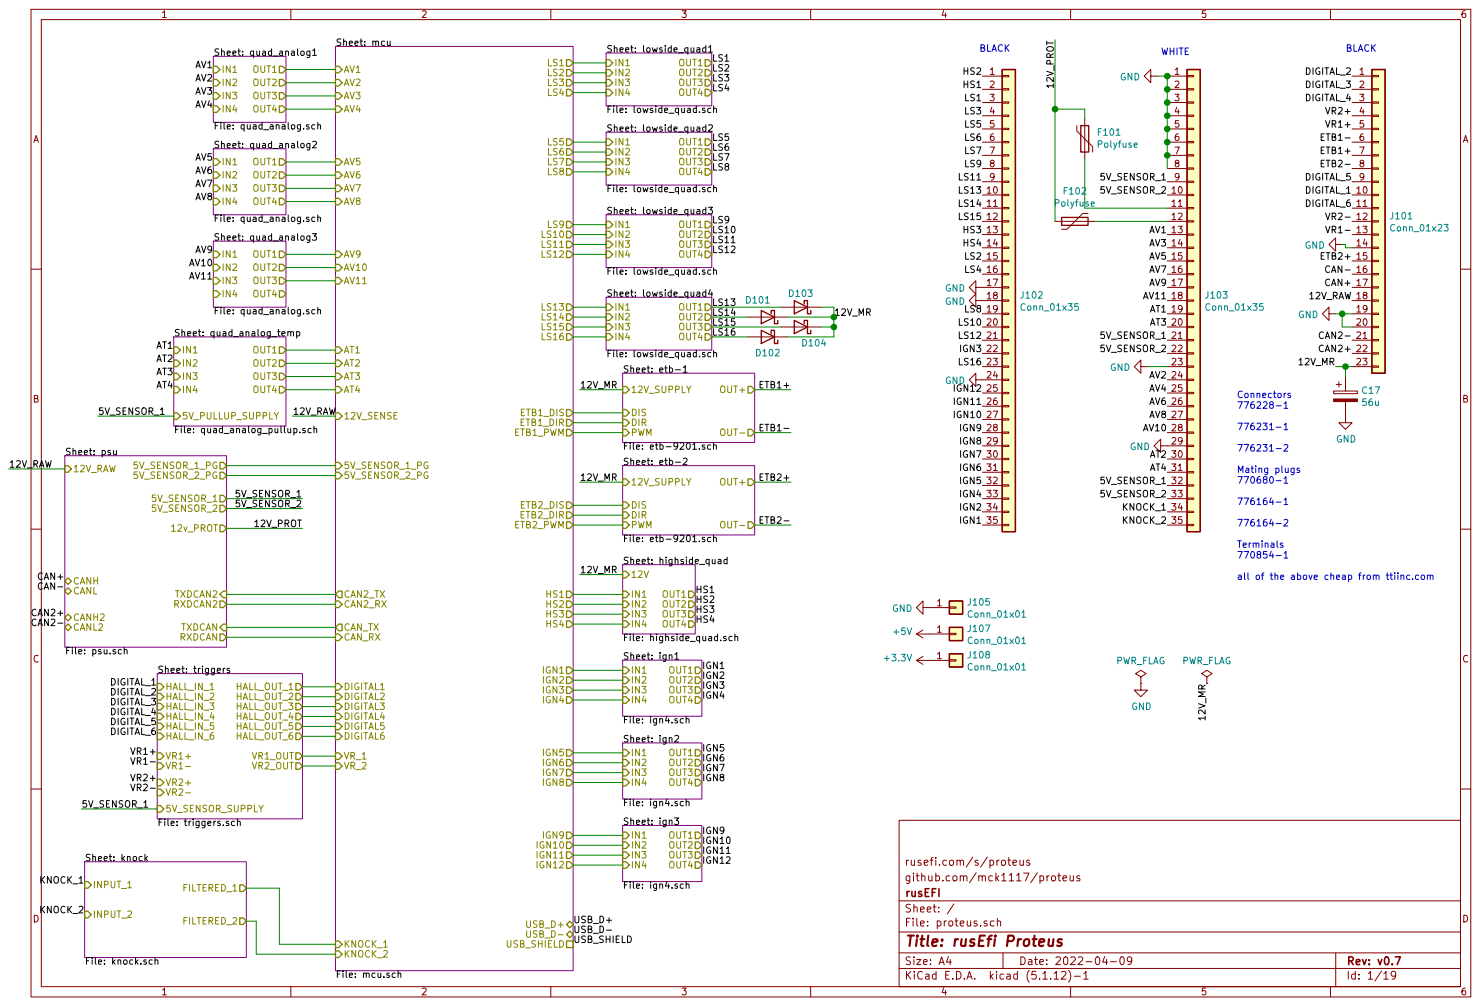
[picture p21: page 1]

all of the above cheap from ttiinc.com

rusefi.com/s/proteus
File: proteus.sch Sheet: / rusEFI github.com/mck1117/proteus

Id: 1/19 Title: rusEfi Proteus

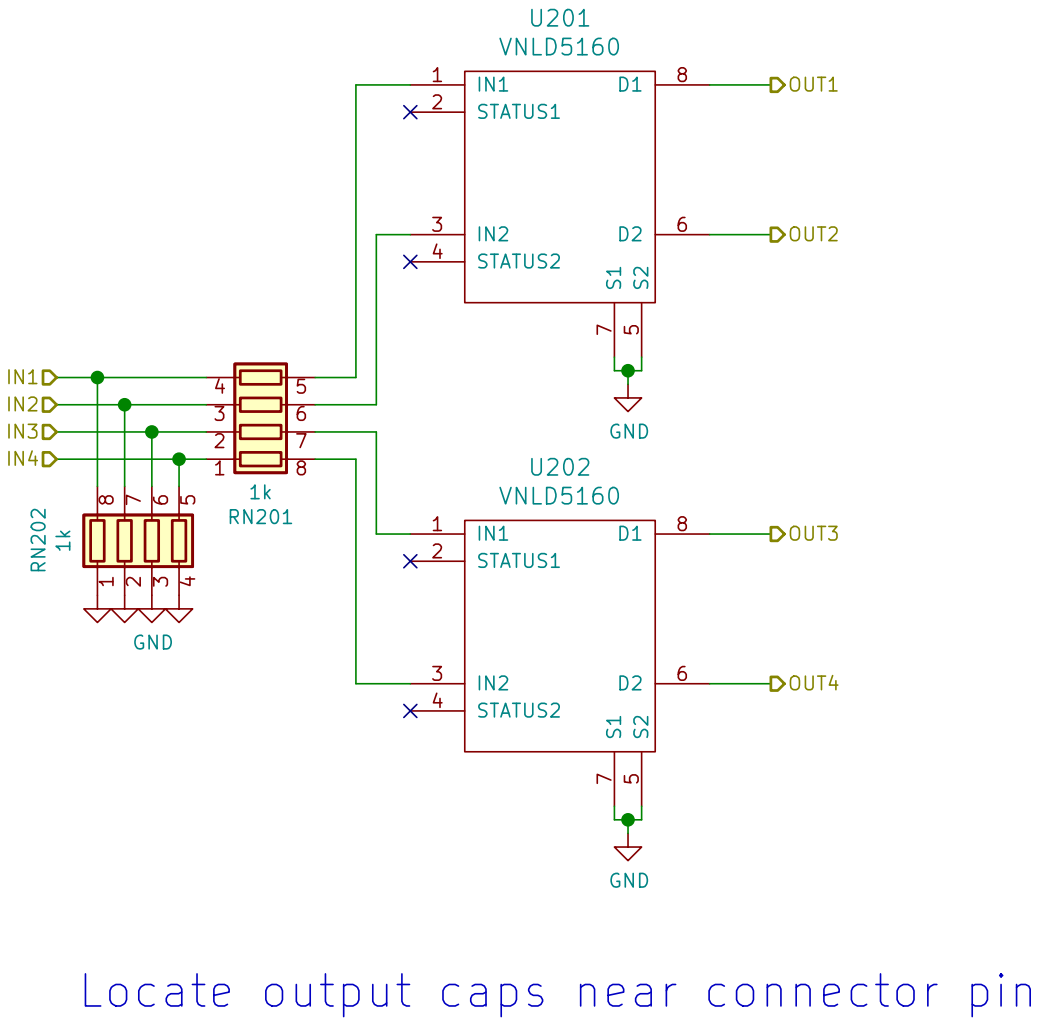
[picture p22: page 2]

rusefi.com/s/proteus
Sheet: /lowside_quad1/ rusEFI github.com/mck1117/proteus

File: lowside_quad.sch
Id: 2/19 Title: rusEfi Proteus

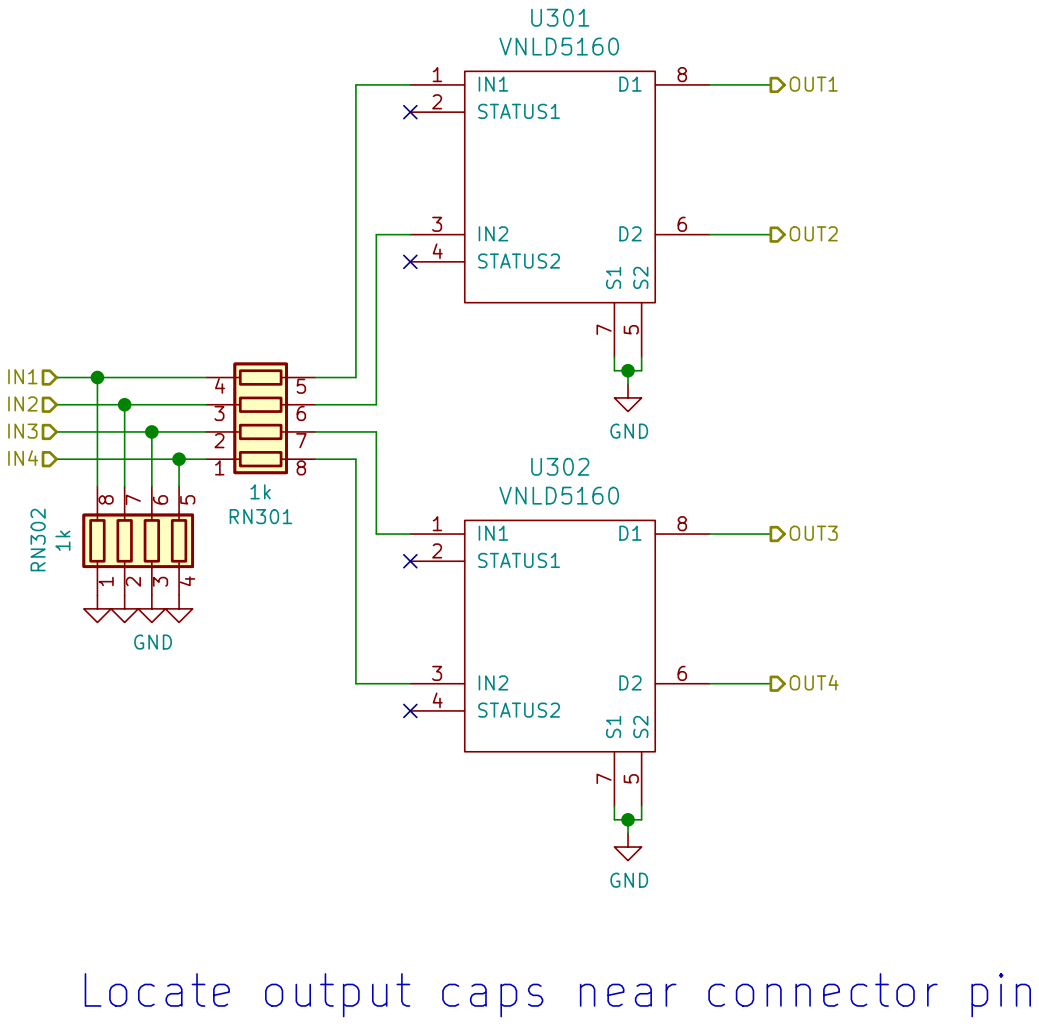
[picture p23: page 3]

rusefi.com/s/proteus
Sheet: /lowside_quad2/ rusEFI github.com/mck1117/proteus

File: lowside_quad.sch
Id: 3/19 Title: rusEfi Proteus

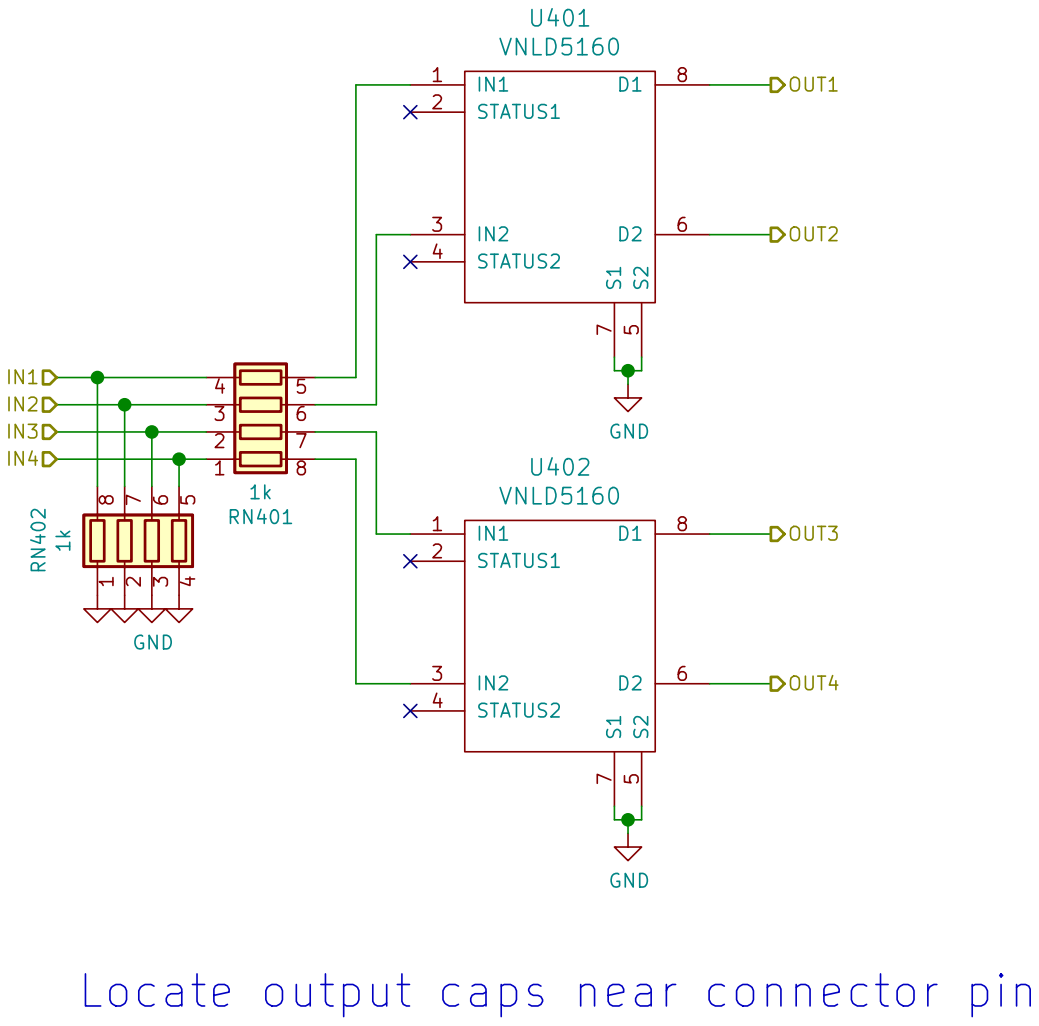
[picture p24: page 4]

rusefi.com/s/proteus
Sheet: /lowside_quad3/ rusEFI github.com/mck1117/proteus

File: lowside_quad.sch
Id: 4/19 Title: rusEfi Proteus

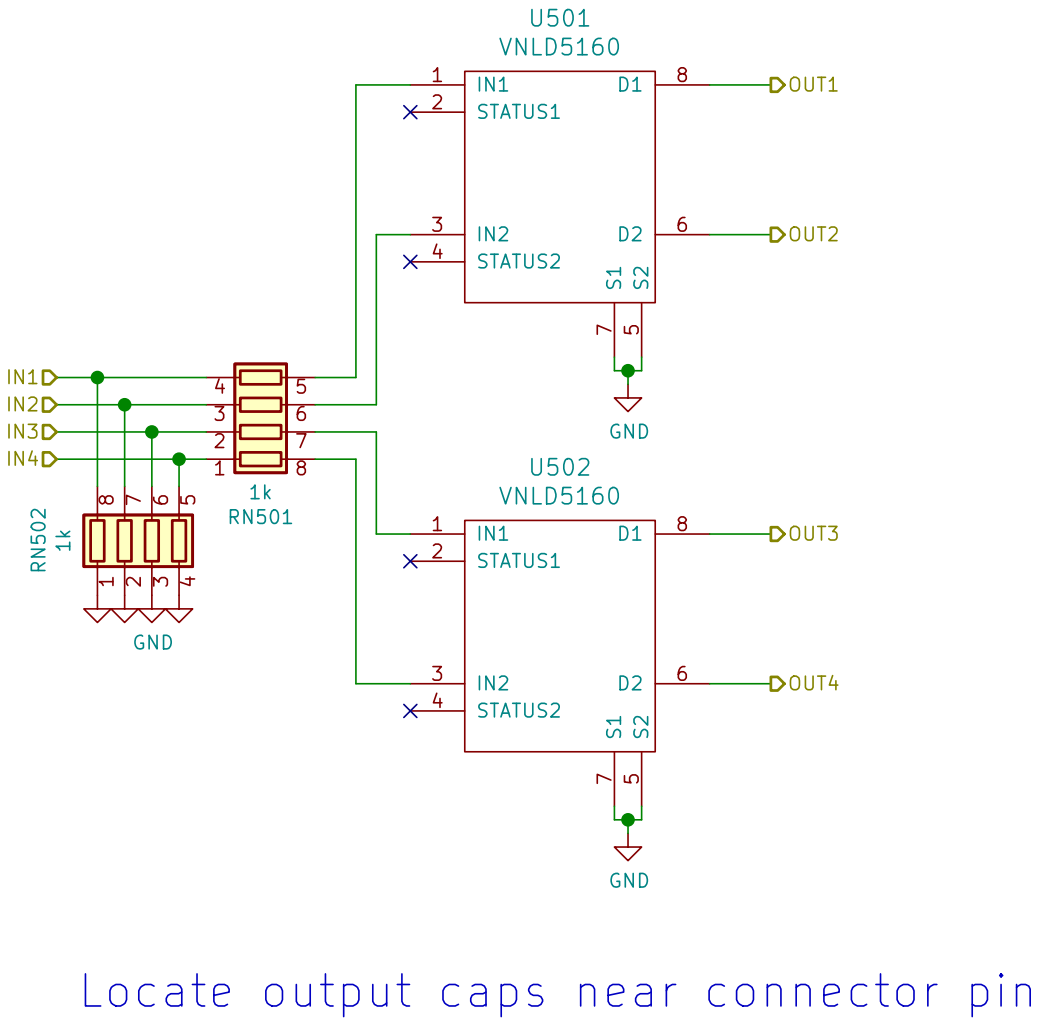
[picture p25: page 5]

rusefi.com/s/proteus
Sheet: /lowside_quad4/ rusEFI github.com/mck1117/proteus

File: lowside_quad.sch
Id: 5/19 Title: rusEfi Proteus

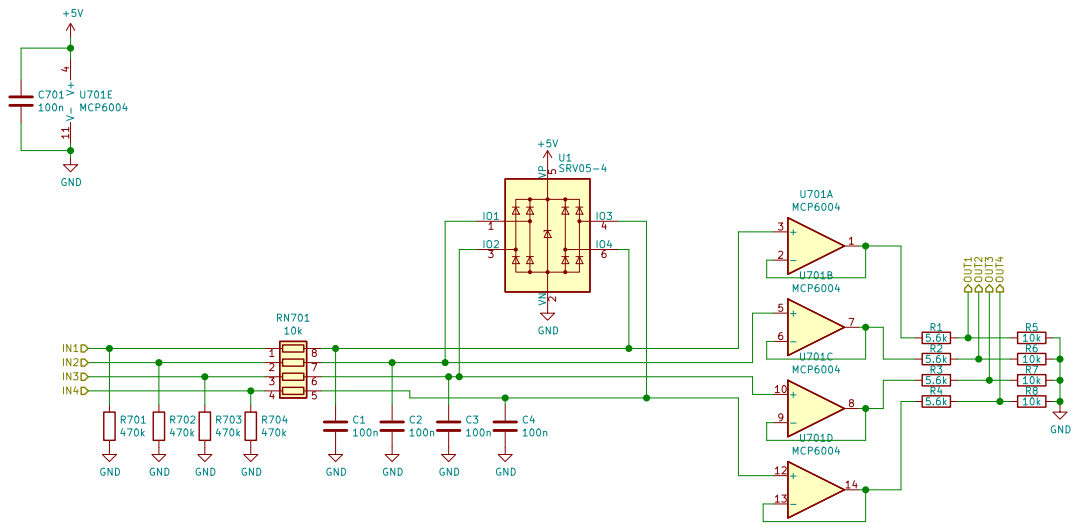
[picture p26: page 6]

rusefi.com/s/proteus
Sheet: /quad_analog1/ rusEFI github.com/mck1117/proteus

File: quad_analog.sch
Id: 6/19 Title: rusEfi Proteus

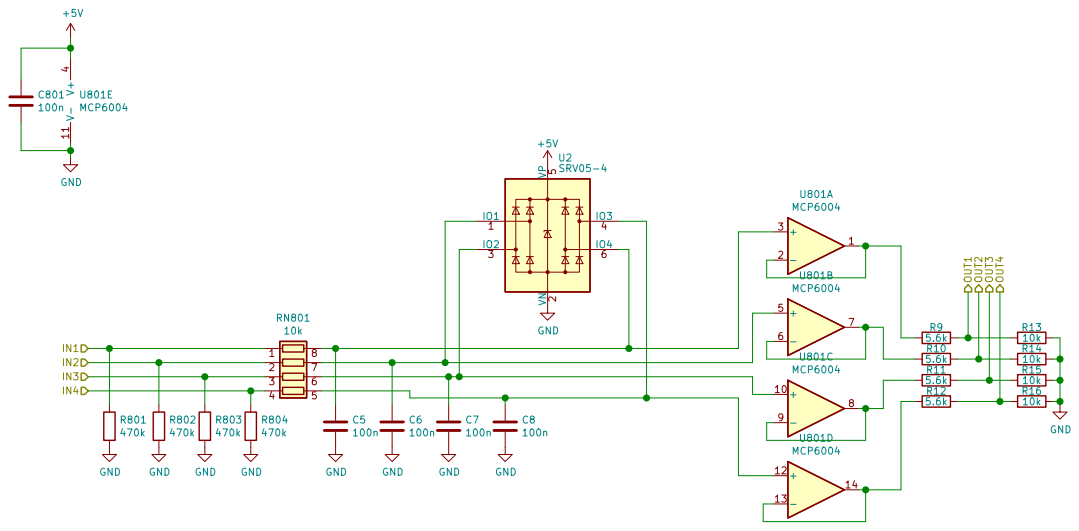
[picture p27: page 7]

rusefi.com/s/proteus
Sheet: /quad_analog2/ rusEFI github.com/mck1117/proteus

File: quad_analog.sch
Id: 7/19 Title: rusEfi Proteus

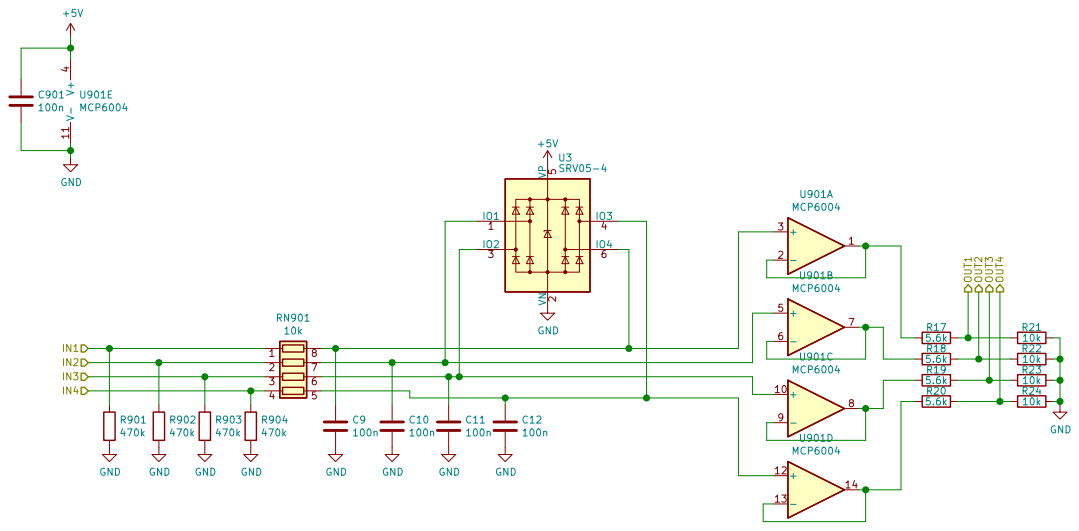
[picture p28: page 8]

rusefi.com/s/proteus
Sheet: /quad_analog3/ rusEFI github.com/mck1117/proteus

File: quad_analog.sch
Id: 8/19 Title: rusEfi Proteus

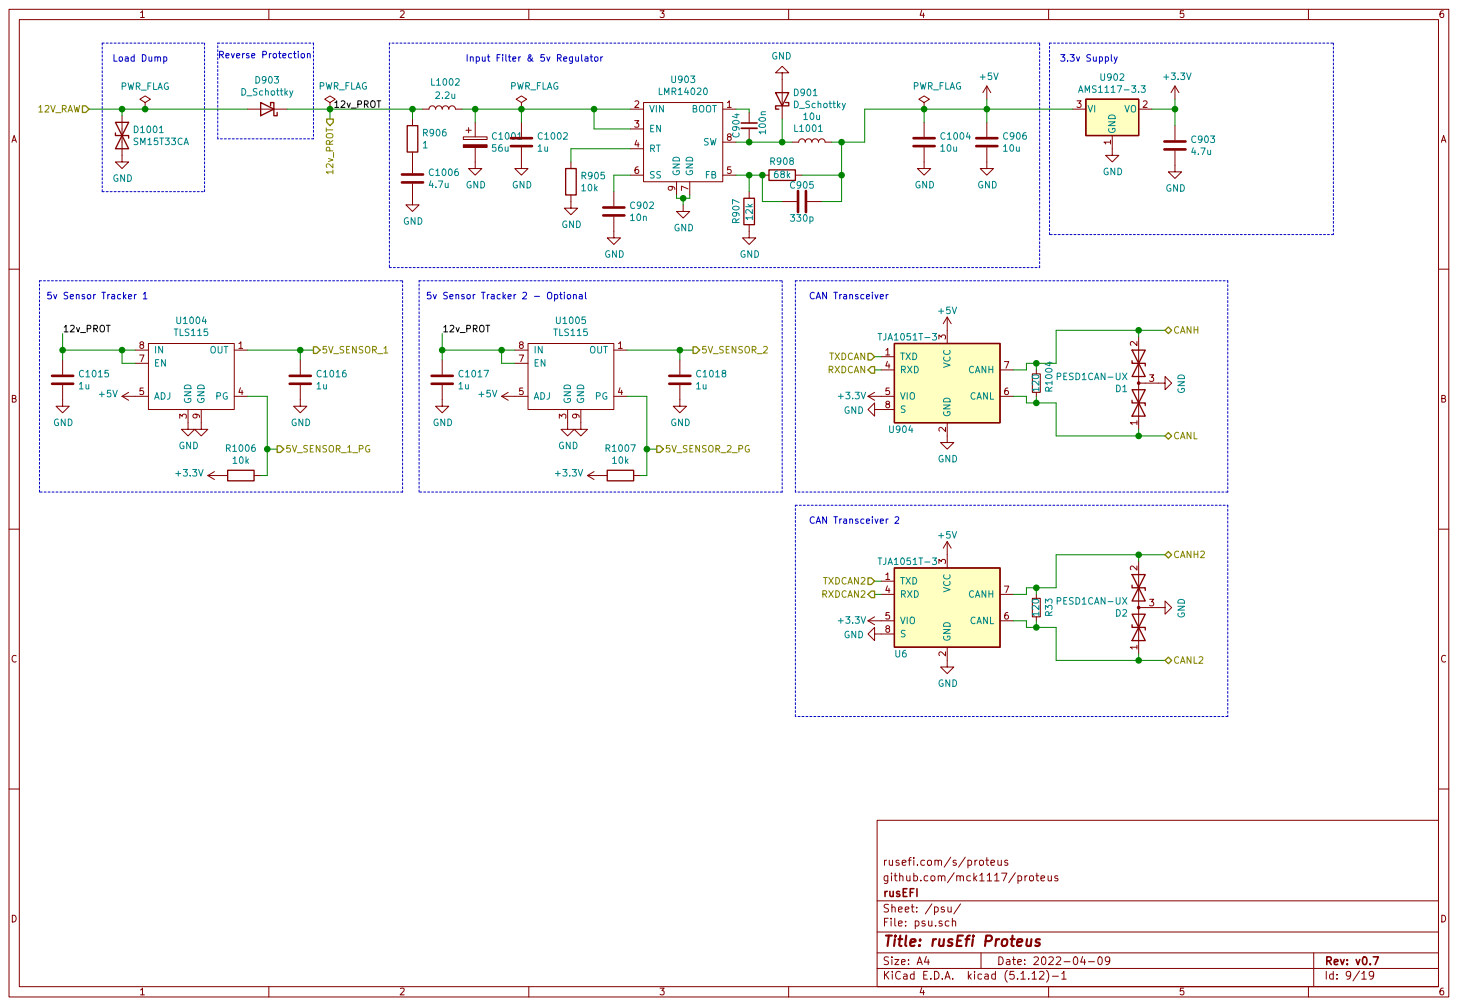
[picture p29: page 9]

3 RXD 4 VIO 5 CANL 6 CANH 7 S

rusefi.com/s/proteus
Sheet: /psu/ rusEFI github.com/mck1117/proteus

File: psu.sch
Id: 9/19 Title: rusEfi Proteus

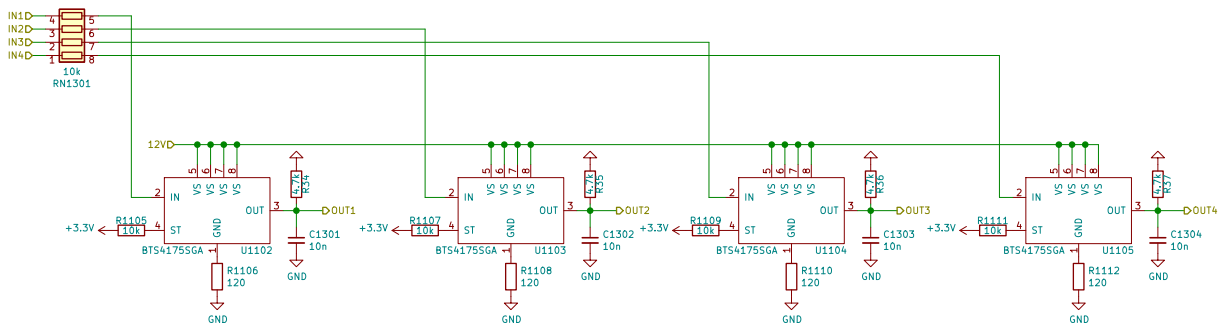
[picture p30: page 10]

Sheet: /highside_quad/ rusEFI github.com/mck1117/proteus

File: highside_quad.sch
Id: 10/19 Title: rusEfi Proteus

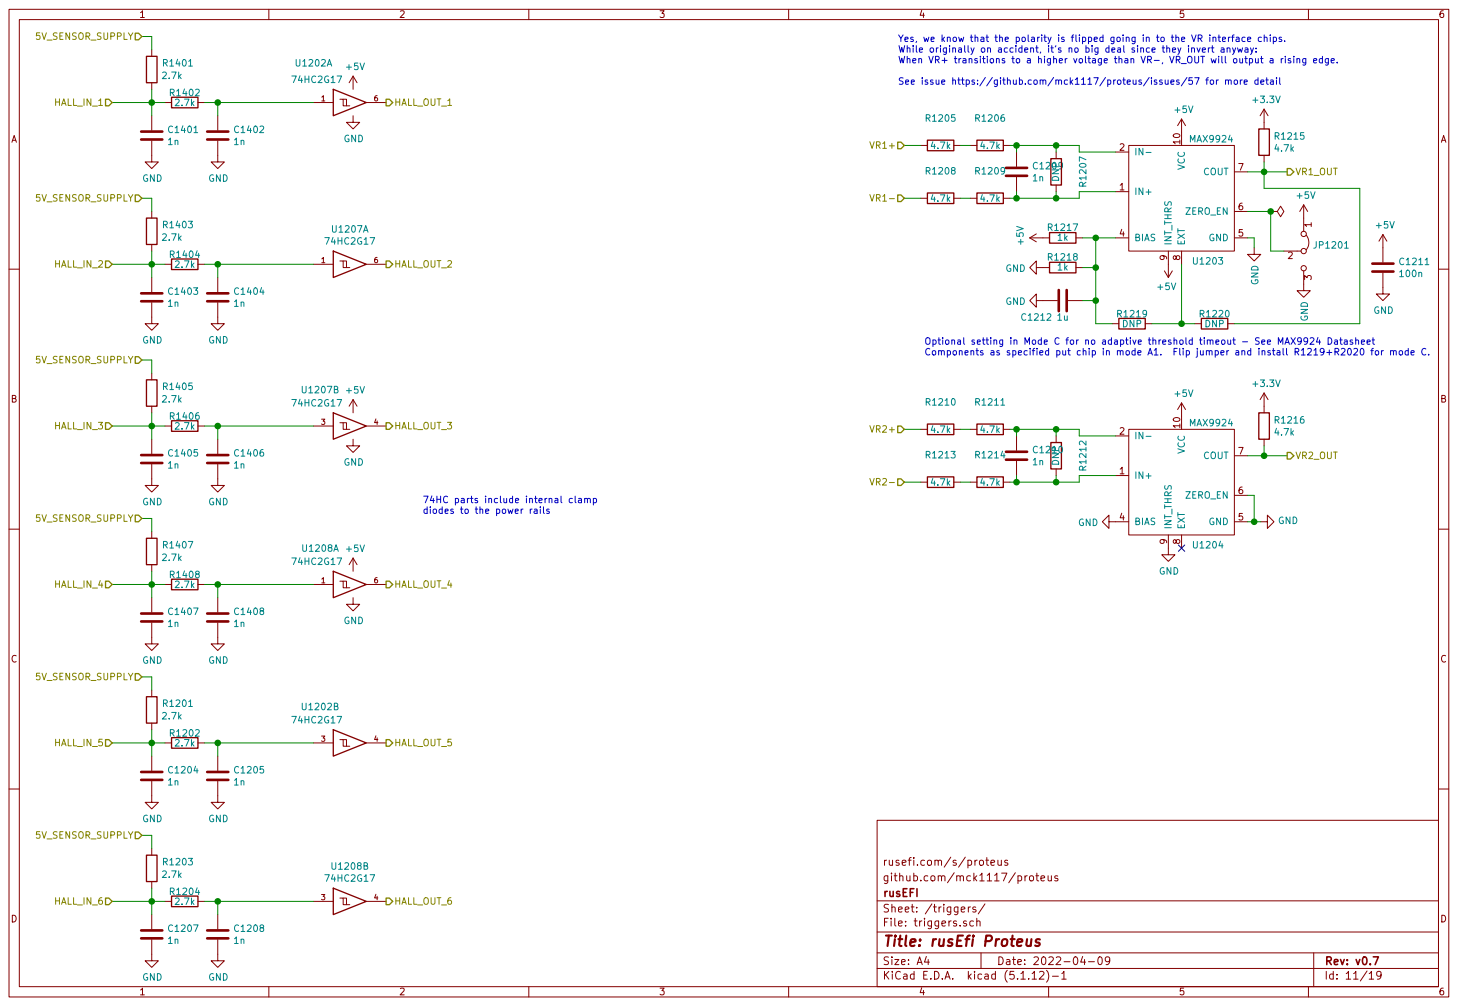
[picture p31: page 11]

Yes, we know that the polarity is flipped going in to the VR interface chips.
While originally on accident, its no big deal since they invert anyway:
When VR+ transitions to a higher voltage than VR-, VR_OUT will output a rising edge.

See issue https://github.com/mck1117/proteus/issues/57 for more detail

Optional setting in Mode C for no adaptive threshold timeout - See MAX9924 Datasheet
Components as specified put chip in mode A1. Flip jumper and install R1219+R2020 for mode C.

74HC parts include internal clamp
diodes to the power rails

Sheet: /triggers/ rusEFI github.com/mck1117/proteus

File: triggers.sch
Id: 11/19 Title: rusEfi Proteus

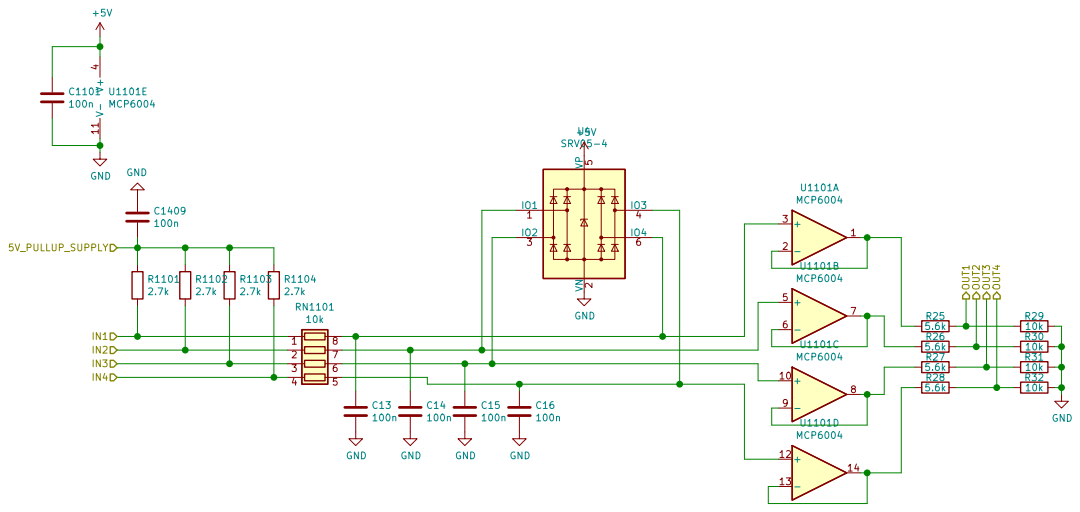
[picture p32: page 12]

Sheet: /quad_analog_temp/ rusEFI github.com/mck1117/proteus

File: quad_analog_pullup.sch
Id: 12/19 Title: rusEfi Proteus

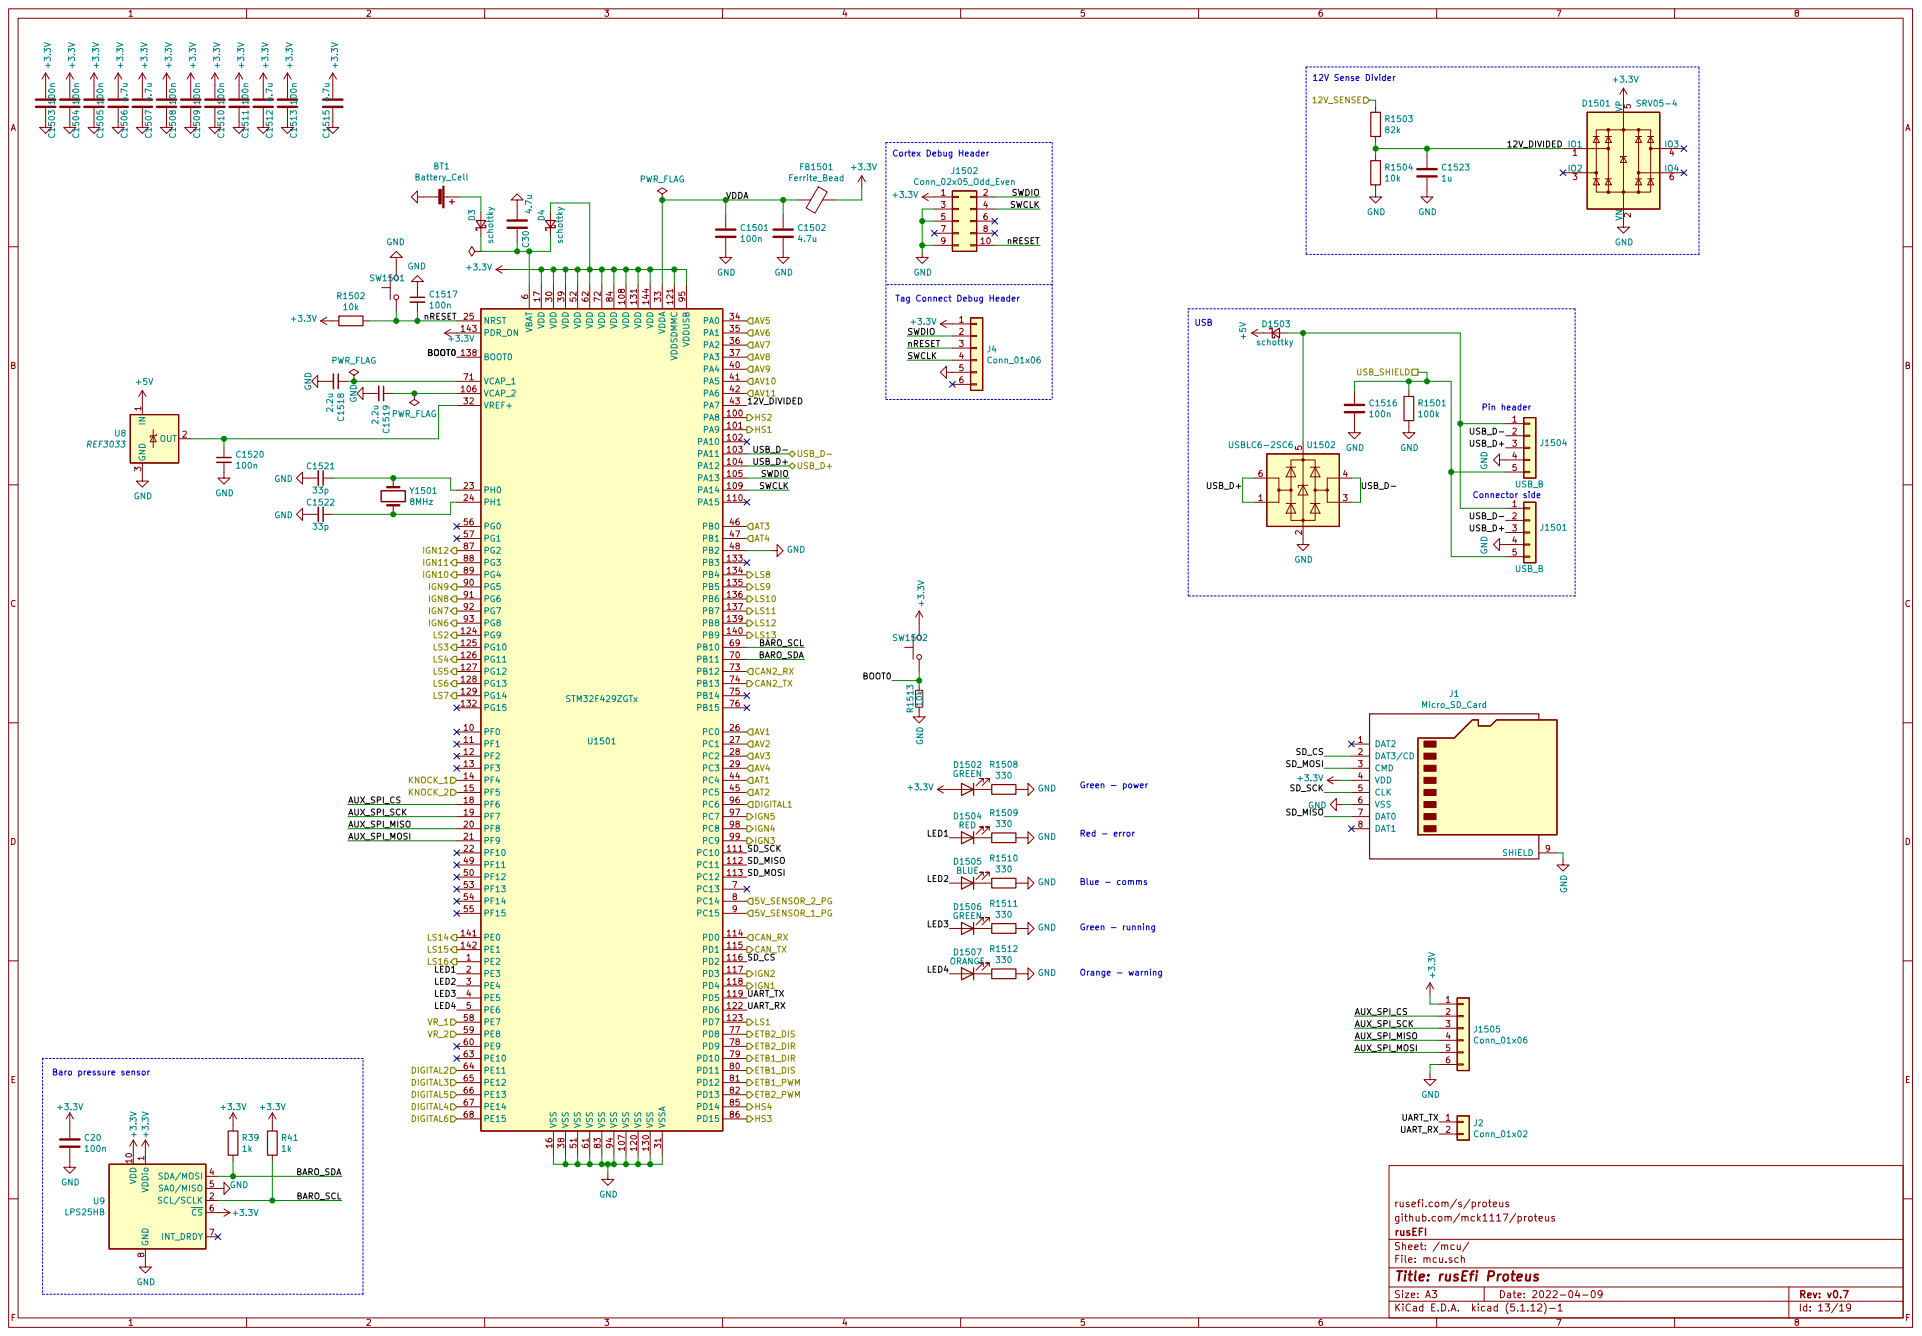
[picture p33: page 13]

6 VCAP_1 71 VCAP_2 106 VDD 108 VDD 131 VDD 144 VDD 17 VDD 30 VDD 39 VDD 52 VDD 62 VDD 72 VDD 84 VDDA 33 VDDSDMMC 121 VDDUSB 95 VREF+ 32 VSS 107 VSS 120 VSS 130 VSS 16 VSS 38 VSS 51 VSS 61 VSS 83 VSS 94 VSSA 31 U1501 STM32F429ZGTx +3.3V GND C1508 100n C1509 100n C1510 100n C1511 100n C1512 4.7u C1513 100n

USB Green - power Red - error Blue - comms

Tag Connect Debug Header

Pin header Connector side

1 VDD 10 SCL/SCLK 2 SDA/MOSI 4 SA0/MISO 5 CS 6

rusefi.com/s/proteus
File: mcu.sch Sheet: /mcu/ rusEFI github.com/mck1117/proteus

Id: 13/19 Title: rusEfi Proteus

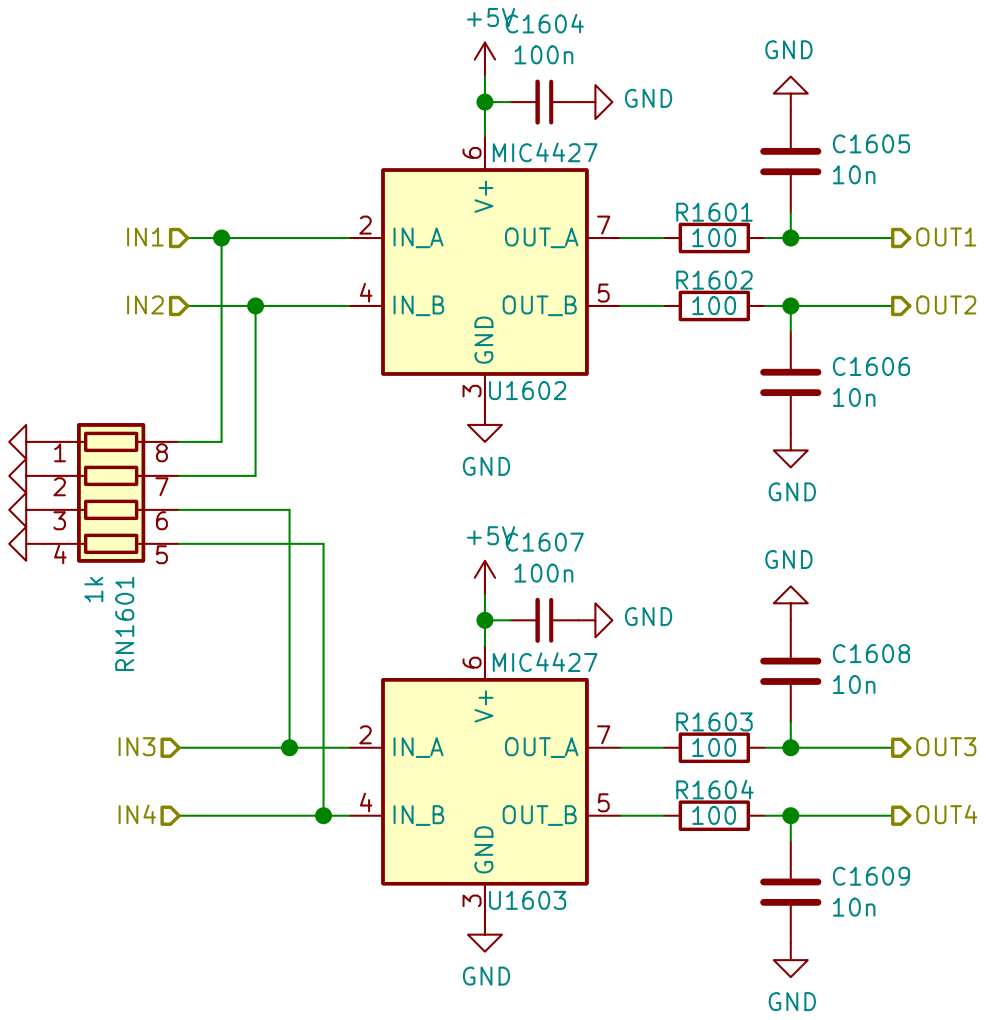
[picture p34: page 14]

rusefi.com/s/proteus
Sheet: /ign1/ rusEFI github.com/mck1117/proteus

File: ign4.sch
Id: 14/19 Title: rusEfi Proteus

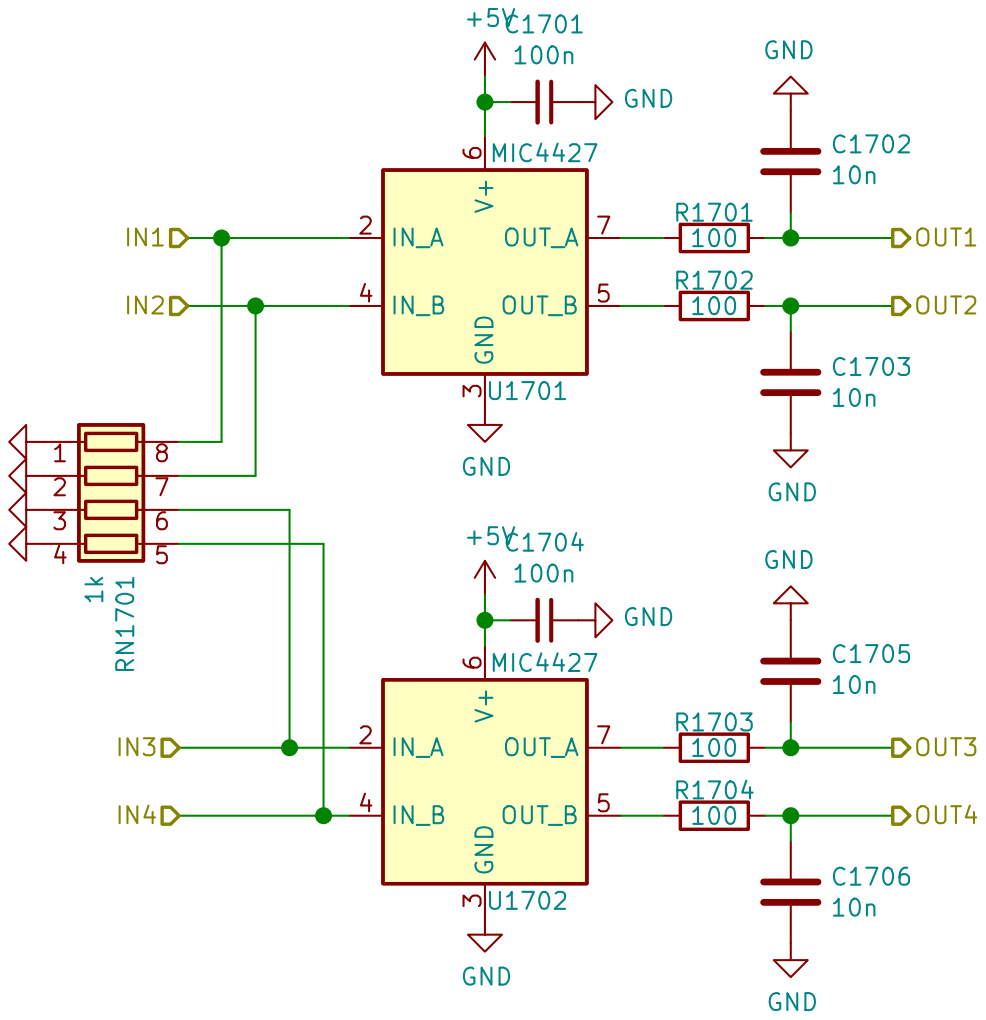
[picture p35: page 15]

rusefi.com/s/proteus
Sheet: /ign2/ rusEFI github.com/mck1117/proteus

File: ign4.sch
Id: 15/19 Title: rusEfi Proteus

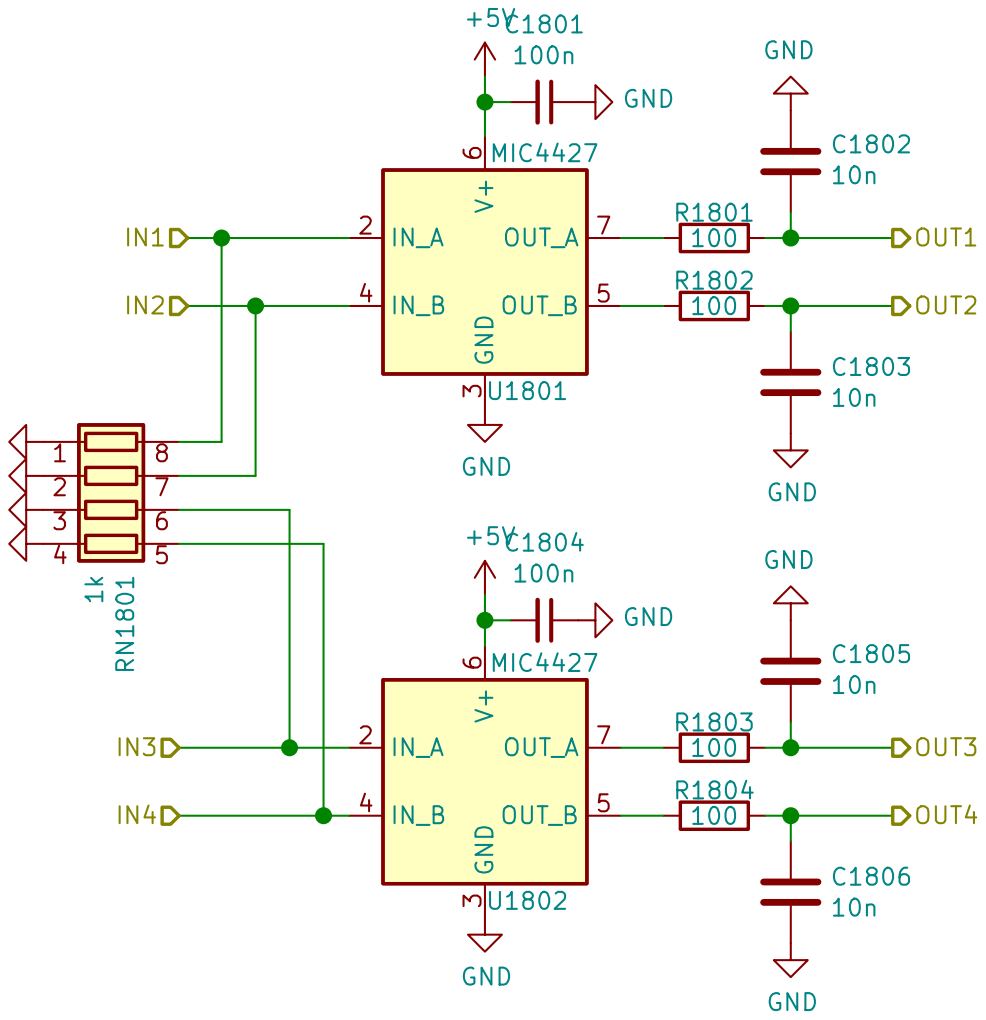
[picture p36: page 16]

rusefi.com/s/proteus
Sheet: /ign3/ rusEFI github.com/mck1117/proteus

File: ign4.sch
Id: 16/19 Title: rusEfi Proteus

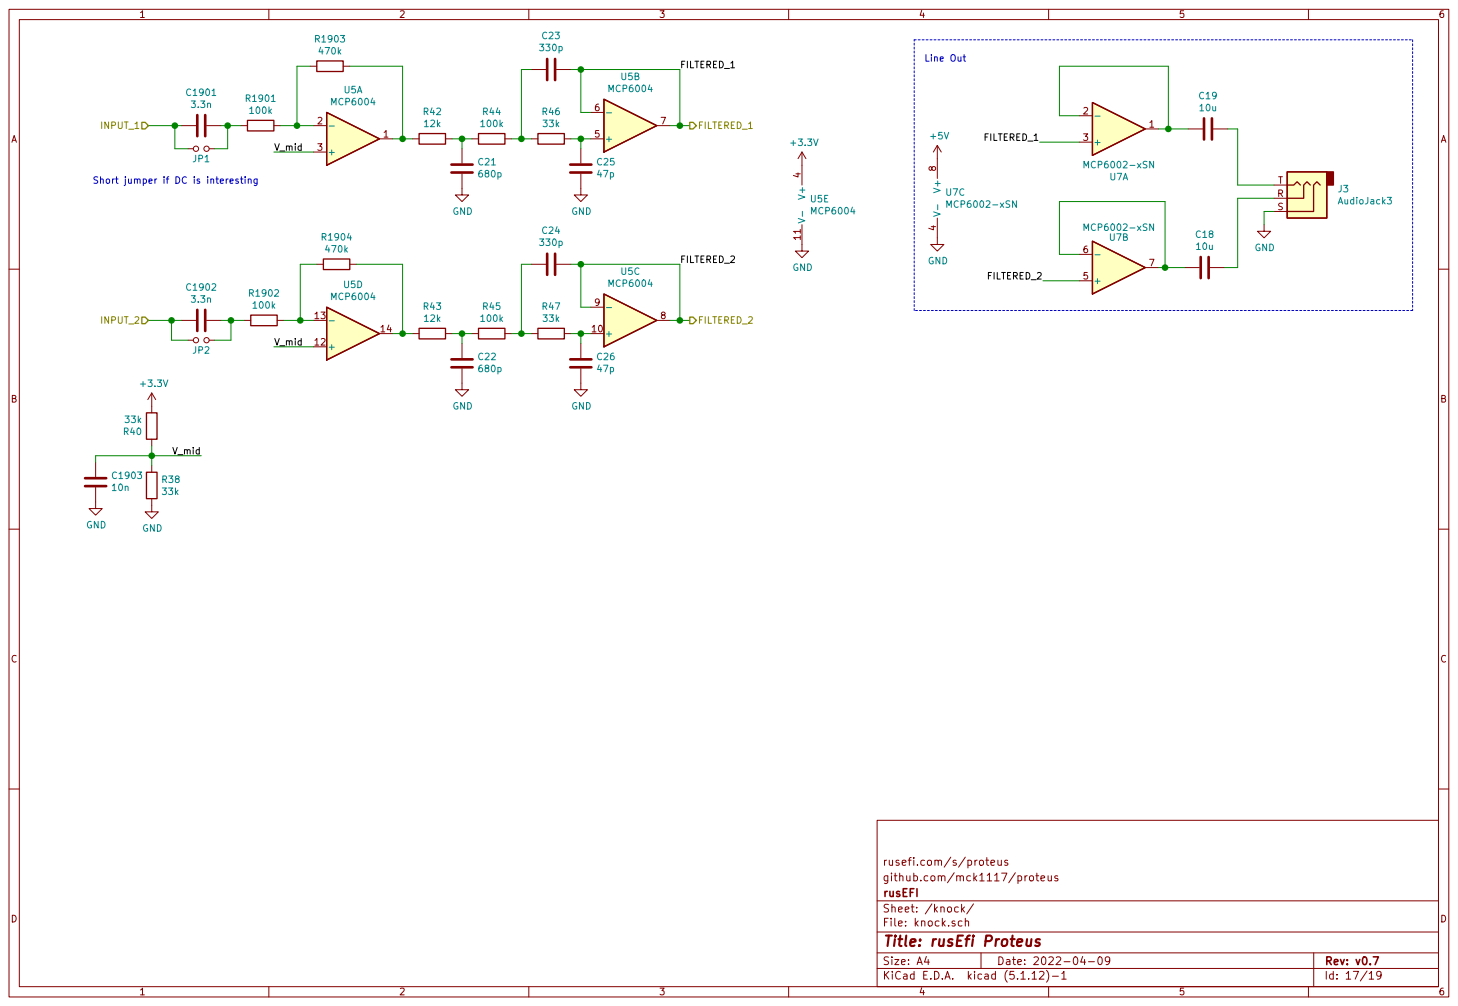
[picture p37: page 17]

rusefi.com/s/proteus
File: knock.sch Sheet: /knock/ rusEFI github.com/mck1117/proteus

Id: 17/19 Title: rusEfi Proteus

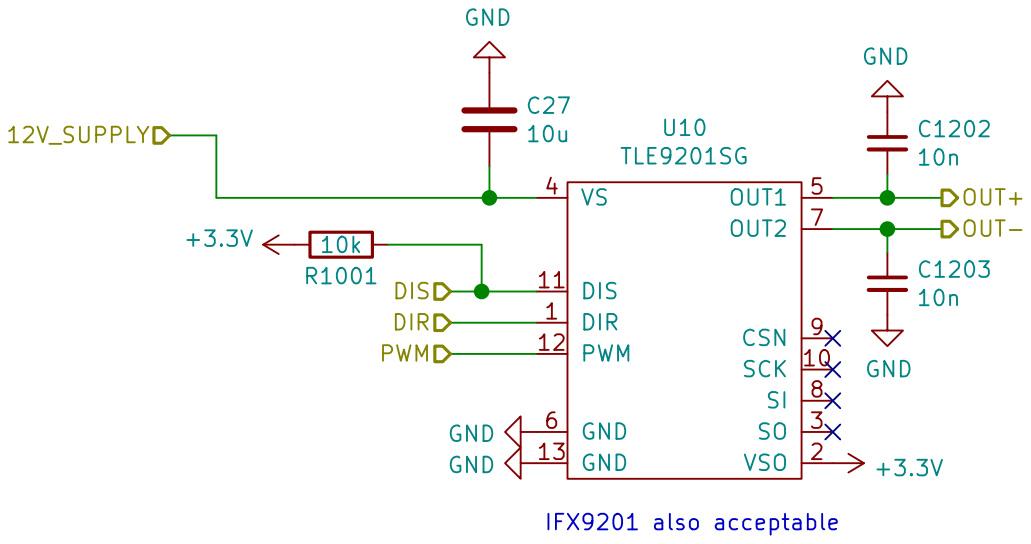
[picture p38: page 18]

rusefi.com/s/proteus
File: etb-9201.sch Sheet: /etb-1/ rusEFI github.com/mck1117/proteus

Id: 18/19 Title: rusEfi Proteus

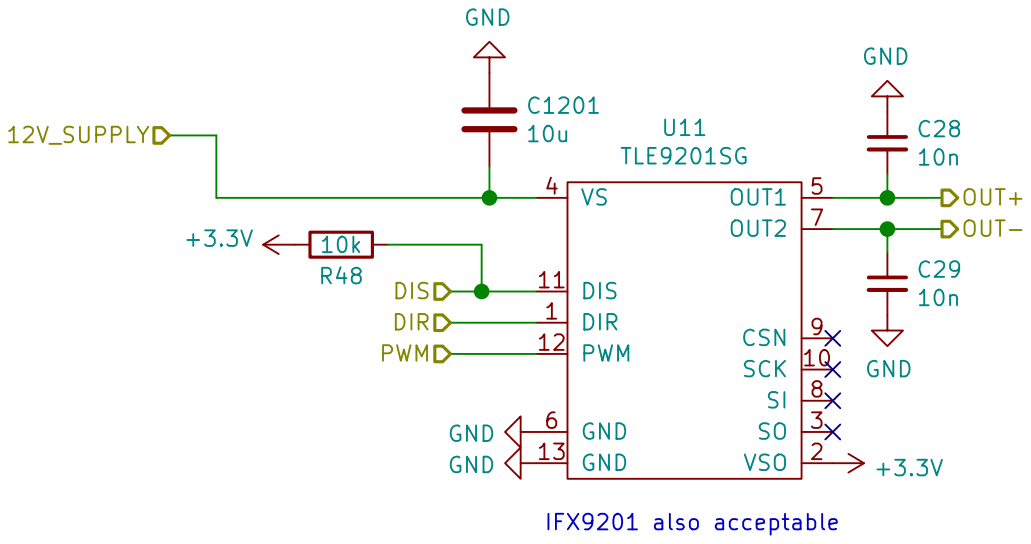
[picture p39: page 19]

rusefi.com/s/proteus
File: etb-9201.sch Sheet: /etb-2/ rusEFI github.com/mck1117/proteus

Id: 19/19 Title: rusEfi Proteus
