JRDMcLAREN/proteus-V2.0/proteus.kicad_pcb

## KiCad design proteus.kicad_pcb (2026-11-01)

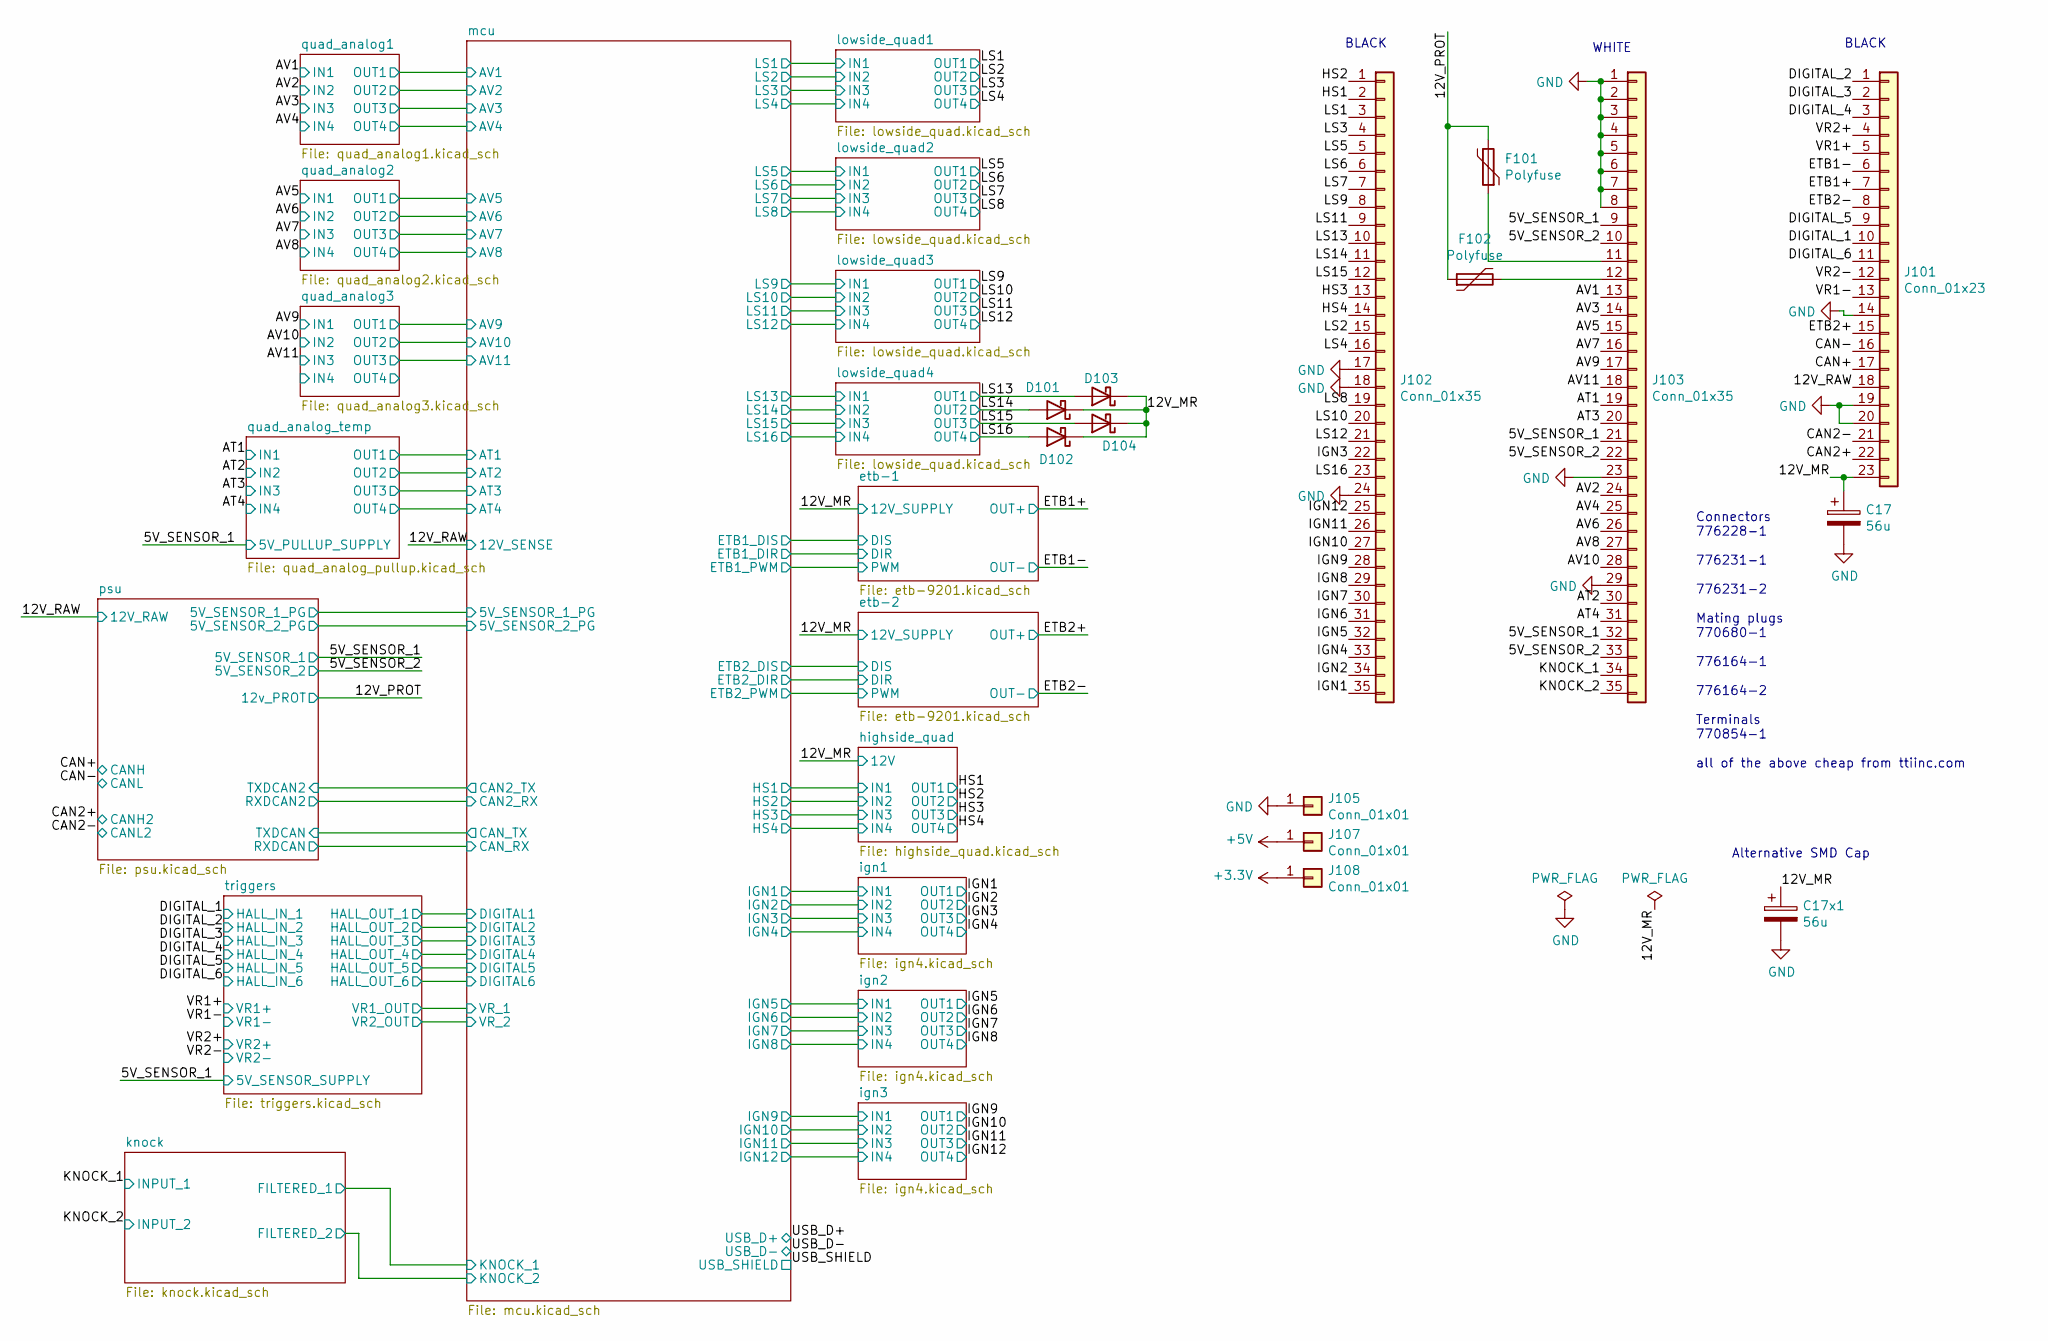
[picture p40: schematic proteus.kicad_sch, rusEfi Proteus v2.0]

Parts:
C17: 56u; CP_Radial_D8.0mm_P3.50mm; LCSC N/A
C17x1: 56u; CP_Elec_6.3x9.9; LCSC N/A
D101, D102, D103, D104: D_Schottky; D_SMA; LCSC C8678
F101, F102: Polyfuse; R_1206_3216Metric; LCSC C207035
J101: Conn_01x23; ampseal-23; LCSC N/A
J102: Conn_01x35; ampseal-35; LCSC N/A
J103: Conn_01x35; ampseal-35-2; LCSC N/A
J105, J107, J108: Conn_01x01; TestPoint_Pad_D3.0mm; LCSC N/A

Connections:
+3V3: J108.1; also elsewhere on the board
+5V: J107.1; also elsewhere on the board
/5V_SENSOR_1: J103.9, J103.21, J103.32; also elsewhere on the board
/5V_SENSOR_2: J103.10, J103.22, J103.33; also elsewhere on the board
/12V_MR: C17.1, C17x1.1, D101.1 (K), D102.1 (K), D103.1 (K), D104.1 (K), J101.23; also elsewhere on the board
/12V_PROT: F101.2, F102.1; also elsewhere on the board
/12V_RAW: J101.18; also elsewhere on the board
/AT1: J103.19; also elsewhere on the board
/AT2: J103.30; also elsewhere on the board
/AT3: J103.20; also elsewhere on the board
/AT4: J103.31; also elsewhere on the board
/AV1: J103.13; also elsewhere on the board
/AV2: J103.24; also elsewhere on the board
/AV3: J103.14; also elsewhere on the board
/AV4: J103.25; also elsewhere on the board
/AV5: J103.15; also elsewhere on the board
/AV6: J103.26; also elsewhere on the board
/AV7: J103.16; also elsewhere on the board
/AV8: J103.27; also elsewhere on the board
/AV9: J103.17; also elsewhere on the board
/AV10: J103.28; also elsewhere on the board
/AV11: J103.18; also elsewhere on the board
/CAN2+: J101.22; also elsewhere on the board
/CAN2-: J101.21; also elsewhere on the board
/CAN+: J101.17; also elsewhere on the board
/CAN-: J101.16; also elsewhere on the board
/DIGITAL_1: J101.10; also elsewhere on the board
/DIGITAL_2: J101.1; also elsewhere on the board
/DIGITAL_3: J101.2; also elsewhere on the board
/DIGITAL_4: J101.3; also elsewhere on the board
/DIGITAL_5: J101.9; also elsewhere on the board
/DIGITAL_6: J101.11; also elsewhere on the board
/ETB1+: J101.7; also elsewhere on the board
/ETB1-: J101.6; also elsewhere on the board
/ETB2+: J101.15; also elsewhere on the board
/ETB2-: J101.8; also elsewhere on the board
/HS1: J102.2; also elsewhere on the board
/HS2: J102.1; also elsewhere on the board
/HS3: J102.13; also elsewhere on the board
/HS4: J102.14; also elsewhere on the board
/IGN1: J102.35; also elsewhere on the board
/IGN2: J102.34; also elsewhere on the board
/IGN3: J102.22; also elsewhere on the board
/IGN4: J102.33; also elsewhere on the board
/IGN5: J102.32; also elsewhere on the board
/IGN6: J102.31; also elsewhere on the board
/IGN7: J102.30; also elsewhere on the board
/IGN8: J102.29; also elsewhere on the board
/IGN9: J102.28; also elsewhere on the board
/IGN10: J102.27; also elsewhere on the board
/IGN11: J102.26; also elsewhere on the board
/IGN12: J102.25; also elsewhere on the board
/KNOCK_1: J103.34; also elsewhere on the board
/KNOCK_2: J103.35; also elsewhere on the board
/LS1: J102.3; also elsewhere on the board
/LS2: J102.15; also elsewhere on the board
/LS3: J102.4; also elsewhere on the board
/LS4: J102.16; also elsewhere on the board
/LS5: J102.5; also elsewhere on the board
/LS6: J102.6; also elsewhere on the board
/LS7: J102.7; also elsewhere on the board
/LS8: J102.19; also elsewhere on the board
/LS9: J102.8; also elsewhere on the board
/LS10: J102.20; also elsewhere on the board
/LS11: J102.9; also elsewhere on the board
/LS12: J102.21; also elsewhere on the board
/LS13: D103.2 (A), J102.10; also elsewhere on the board
/LS14: D101.2 (A), J102.11; also elsewhere on the board
/LS15: D104.2 (A), J102.12; also elsewhere on the board
/LS16: D102.2 (A), J102.23; also elsewhere on the board
/VR1+: J101.5; also elsewhere on the board
/VR1-: J101.13; also elsewhere on the board
/VR2+: J101.4; also elsewhere on the board
/VR2-: J101.12; also elsewhere on the board
GND: C17.2, C17x1.2, J101.14, J101.19, J101.20, J102.17, J102.18, J102.24, J103.1, J103.2, J103.3, J103.4, J103.5, J103.6, J103.7, J103.8, J103.23, J103.29, J105.1; also elsewhere on the board
unnamed: F101.1, J103.11
unnamed: F102.2, J103.12

Notes on the sheet:
WHITE
BLACK
Connectors 776228-1 776231-1 776231-2 Mating plugs 770680-1 776164-1 776164-2 Terminals 770854-1 all of the above cheap from ttiinc.com
Alternative SMD Cap

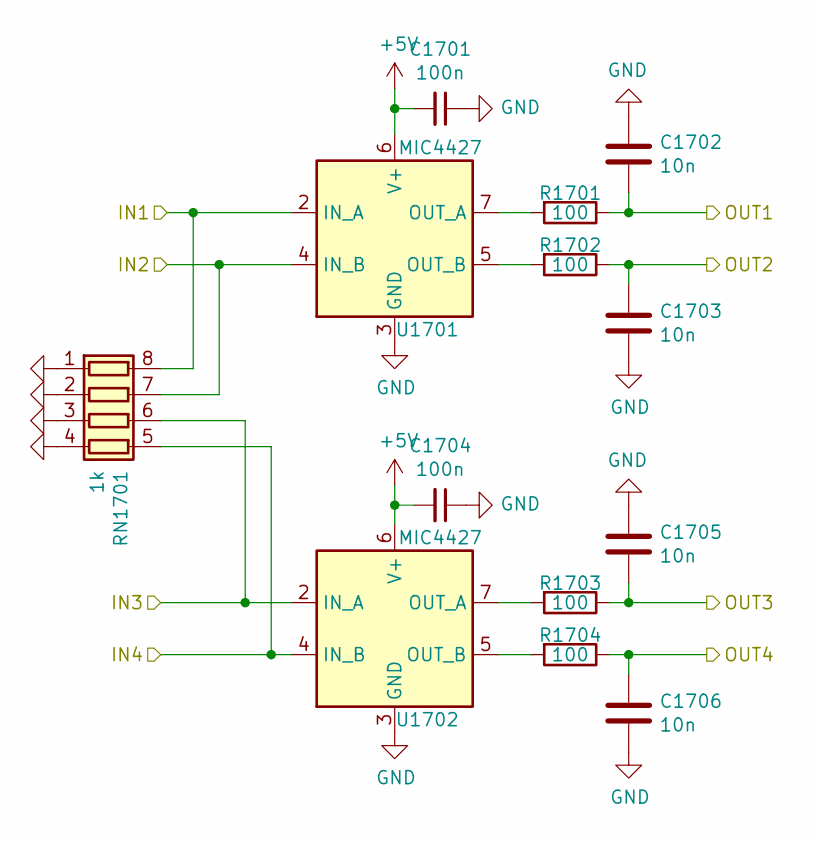
[picture p41: schematic ign4.kicad_sch, rusEfi Proteus v2.0]

Parts:
C1701, C1704: 100n; C_0603_1608Metric; LCSC C14663
C1702, C1703, C1705, C1706: 10n; C_0603_1608Metric; LCSC C57112
R1701, R1702, R1703, R1704: 100; R_0805_2012Metric; LCSC C17408
RN1701: 1k; R_Array_Convex_4x0603; LCSC C20197
U1701, U1702: MIC4427; SOIC-8_3.9x4.9mm_P1.27mm; LCSC C20551

Connections:
+5V: C1701.2, C1704.2, U1701.6 (V+), U1702.6 (V+); also elsewhere on the board
/IGN5: C1702.1, R1701.1; also elsewhere on the board
/IGN6: C1703.1, R1702.1; also elsewhere on the board
/IGN7: C1705.1, R1703.1; also elsewhere on the board
/IGN8: C1706.1, R1704.1; also elsewhere on the board
/ign2/IN1: RN1701.8 (R1.2), U1701.2 (IN_A); also elsewhere on the board
/ign2/IN2: RN1701.7 (R2.2), U1701.4 (IN_B); also elsewhere on the board
/ign2/IN3: RN1701.6 (R3.2), U1702.2 (IN_A); also elsewhere on the board
/ign2/IN4: RN1701.5 (R4.2), U1702.4 (IN_B); also elsewhere on the board
GND: C1701.1, C1702.2, C1703.2, C1704.1, C1705.2, C1706.2, RN1701.1 (R1.1), RN1701.2 (R2.1), RN1701.3 (R3.1), RN1701.4 (R4.1), U1701.3 (GND), U1702.3 (GND); also elsewhere on the board
unnamed: R1701.2, U1701.7 (OUT_A)
unnamed: R1702.2, U1701.5 (OUT_B)
unnamed: R1703.2, U1702.7 (OUT_A)
unnamed: R1704.2, U1702.5 (OUT_B)

Parts of its further copies:
C1604, C1607, C1801, C1804: 100n; C_0603_1608Metric; LCSC C14663
C1605, C1606, C1608, C1609, C1802, C1803, C1805, C1806: 10n; C_0603_1608Metric; LCSC C57112
R1601, R1602, R1603, R1604, R1801, R1802, R1803, R1804: 100; R_0805_2012Metric; LCSC C17408
RN1601, RN1801: 1k; R_Array_Convex_4x0603; LCSC C20197
U1602, U1603, U1801, U1802: MIC4427; SOIC-8_3.9x4.9mm_P1.27mm; LCSC C20551

Connections of its further copies:
+5V: C1604.2, C1607.2, C1801.2, C1804.2, U1602.6 (V+), U1603.6 (V+), U1801.6 (V+), U1802.6 (V+); also elsewhere on the board
/IGN1: C1605.1, R1601.1; also elsewhere on the board
/IGN2: C1606.1, R1602.1; also elsewhere on the board
/IGN3: C1608.1, R1603.1; also elsewhere on the board
/IGN4: C1609.1, R1604.1; also elsewhere on the board
/IGN9: C1802.1, R1801.1; also elsewhere on the board
/IGN10: C1803.1, R1802.1; also elsewhere on the board
/IGN11: C1805.1, R1803.1; also elsewhere on the board
/IGN12: C1806.1, R1804.1; also elsewhere on the board
/ign1/IN1: RN1601.8 (R1.2), U1602.2 (IN_A); also elsewhere on the board
/ign1/IN2: RN1601.7 (R2.2), U1602.4 (IN_B); also elsewhere on the board
/ign1/IN3: RN1601.6 (R3.2), U1603.2 (IN_A); also elsewhere on the board
/ign1/IN4: RN1601.5 (R4.2), U1603.4 (IN_B); also elsewhere on the board
/ign3/IN1: RN1801.8 (R1.2), U1801.2 (IN_A); also elsewhere on the board
/ign3/IN2: RN1801.7 (R2.2), U1801.4 (IN_B); also elsewhere on the board
/ign3/IN3: RN1801.6 (R3.2), U1802.2 (IN_A); also elsewhere on the board
/ign3/IN4: RN1801.5 (R4.2), U1802.4 (IN_B); also elsewhere on the board
GND: C1604.1, C1605.2, C1606.2, C1607.1, C1608.2, C1609.2, C1801.1, C1802.2, C1803.2, C1804.1, C1805.2, C1806.2, RN1601.1 (R1.1), RN1601.2 (R2.1), RN1601.3 (R3.1), RN1601.4 (R4.1), RN1801.1 (R1.1), RN1801.2 (R2.1), RN1801.3 (R3.1), RN1801.4 (R4.1), U1602.3 (GND), U1603.3 (GND), U1801.3 (GND), U1802.3 (GND); also elsewhere on the board
unnamed: R1601.2, U1602.7 (OUT_A)
unnamed: R1602.2, U1602.5 (OUT_B)
unnamed: R1603.2, U1603.7 (OUT_A)
unnamed: R1604.2, U1603.5 (OUT_B)
unnamed: R1801.2, U1801.7 (OUT_A)
unnamed: R1802.2, U1801.5 (OUT_B)
unnamed: R1803.2, U1802.7 (OUT_A)
unnamed: R1804.2, U1802.5 (OUT_B)

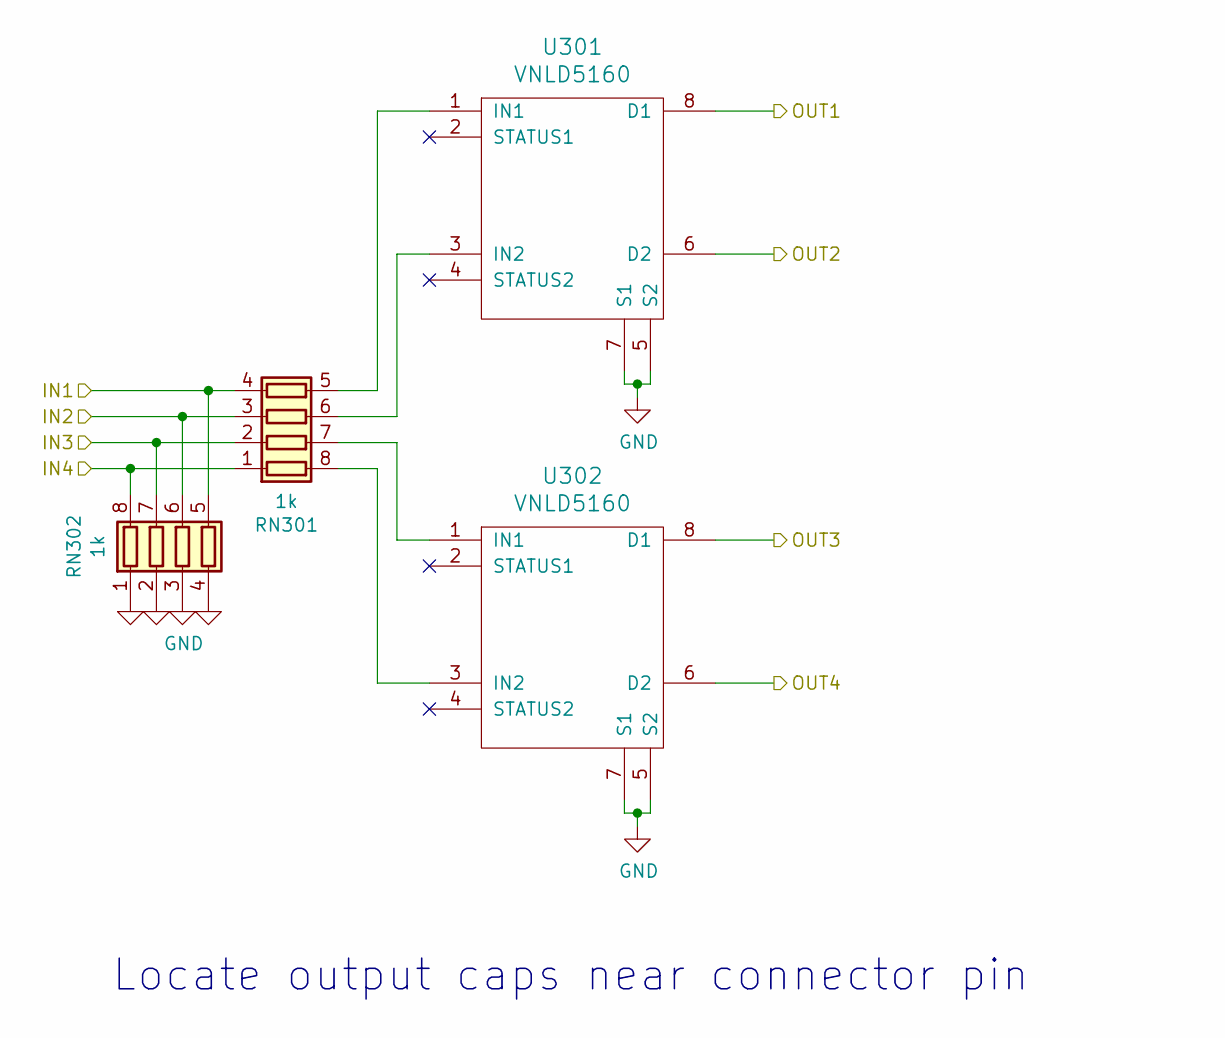
[picture p42: schematic lowside_quad.kicad_sch, rusEfi Proteus v2.0]

Parts:
RN301, RN302: 1k; R_Array_Convex_4x0603; LCSC C20197
U301, U302: VNLD5160; SOIC-8_3.9x4.9mm_P1.27mm; LCSC N/A

Connections:
/LS5: U301.8 (D1); also elsewhere on the board
/LS6: U301.6 (D2); also elsewhere on the board
/LS7: U302.8 (D1); also elsewhere on the board
/LS8: U302.6 (D2); also elsewhere on the board
/lowside_quad2/IN1: RN301.4 (R4.1), RN302.5 (R4.2); also elsewhere on the board
/lowside_quad2/IN2: RN301.3 (R3.1), RN302.6 (R3.2); also elsewhere on the board
/lowside_quad2/IN3: RN301.2 (R2.1), RN302.7 (R2.2); also elsewhere on the board
/lowside_quad2/IN4: RN301.1 (R1.1), RN302.8 (R1.2); also elsewhere on the board
GND: RN302.1 (R1.1), RN302.2 (R2.1), RN302.3 (R3.1), RN302.4 (R4.1), U301.5 (S2), U301.7 (S1), U302.5 (S2), U302.7 (S1); also elsewhere on the board
unnamed: RN301.8 (R1.2), U302.3 (IN2)
unnamed: RN301.7 (R2.2), U302.1 (IN1)
unnamed: RN301.6 (R3.2), U301.3 (IN2)
unnamed: RN301.5 (R4.2), U301.1 (IN1)

Parts of its further copies:
RN201, RN202, RN401, RN402, RN501, RN502: 1k; R_Array_Convex_4x0603; LCSC C20197
U201, U202, U401, U402, U501, U502: VNLD5160; SOIC-8_3.9x4.9mm_P1.27mm; LCSC N/A

Connections of its further copies:
/LS1: U201.8 (D1); also elsewhere on the board
/LS2: U201.6 (D2); also elsewhere on the board
/LS3: U202.8 (D1); also elsewhere on the board
/LS4: U202.6 (D2); also elsewhere on the board
/LS9: U401.8 (D1); also elsewhere on the board
/LS10: U401.6 (D2); also elsewhere on the board
/LS11: U402.8 (D1); also elsewhere on the board
/LS12: U402.6 (D2); also elsewhere on the board
/LS13: U501.8 (D1); also elsewhere on the board
/LS14: U501.6 (D2); also elsewhere on the board
/LS15: U502.8 (D1); also elsewhere on the board
/LS16: U502.6 (D2); also elsewhere on the board
/lowside_quad1/IN1: RN201.4 (R4.1), RN202.5 (R4.2); also elsewhere on the board
/lowside_quad1/IN2: RN201.3 (R3.1), RN202.6 (R3.2); also elsewhere on the board
/lowside_quad1/IN3: RN201.2 (R2.1), RN202.7 (R2.2); also elsewhere on the board
/lowside_quad1/IN4: RN201.1 (R1.1), RN202.8 (R1.2); also elsewhere on the board
/lowside_quad3/IN1: RN401.4 (R4.1), RN402.5 (R4.2); also elsewhere on the board
/lowside_quad3/IN2: RN401.3 (R3.1), RN402.6 (R3.2); also elsewhere on the board
/lowside_quad3/IN3: RN401.2 (R2.1), RN402.7 (R2.2); also elsewhere on the board
/lowside_quad3/IN4: RN401.1 (R1.1), RN402.8 (R1.2); also elsewhere on the board
/lowside_quad4/IN1: RN501.4 (R4.1), RN502.5 (R4.2); also elsewhere on the board
/lowside_quad4/IN2: RN501.3 (R3.1), RN502.6 (R3.2); also elsewhere on the board
/lowside_quad4/IN3: RN501.2 (R2.1), RN502.7 (R2.2); also elsewhere on the board
/lowside_quad4/IN4: RN501.1 (R1.1), RN502.8 (R1.2); also elsewhere on the board
GND: RN202.1 (R1.1), RN202.2 (R2.1), RN202.3 (R3.1), RN202.4 (R4.1), RN402.1 (R1.1), RN402.2 (R2.1), RN402.3 (R3.1), RN402.4 (R4.1), RN502.1 (R1.1), RN502.2 (R2.1), RN502.3 (R3.1), RN502.4 (R4.1), U201.5 (S2), U201.7 (S1), U202.5 (S2), U202.7 (S1), U401.5 (S2), U401.7 (S1), U402.5 (S2), U402.7 (S1), U501.5 (S2), U501.7 (S1), U502.5 (S2), U502.7 (S1); also elsewhere on the board
unnamed: RN201.8 (R1.2), U202.3 (IN2)
unnamed: RN201.7 (R2.2), U202.1 (IN1)
unnamed: RN201.6 (R3.2), U201.3 (IN2)
unnamed: RN201.5 (R4.2), U201.1 (IN1)
unnamed: RN401.8 (R1.2), U402.3 (IN2)
unnamed: RN401.7 (R2.2), U402.1 (IN1)
unnamed: RN401.6 (R3.2), U401.3 (IN2)
unnamed: RN401.5 (R4.2), U401.1 (IN1)
unnamed: RN501.8 (R1.2), U502.3 (IN2)
unnamed: RN501.7 (R2.2), U502.1 (IN1)
unnamed: RN501.6 (R3.2), U501.3 (IN2)
unnamed: RN501.5 (R4.2), U501.1 (IN1)

Notes on the sheet:
Locate output caps near connector pin

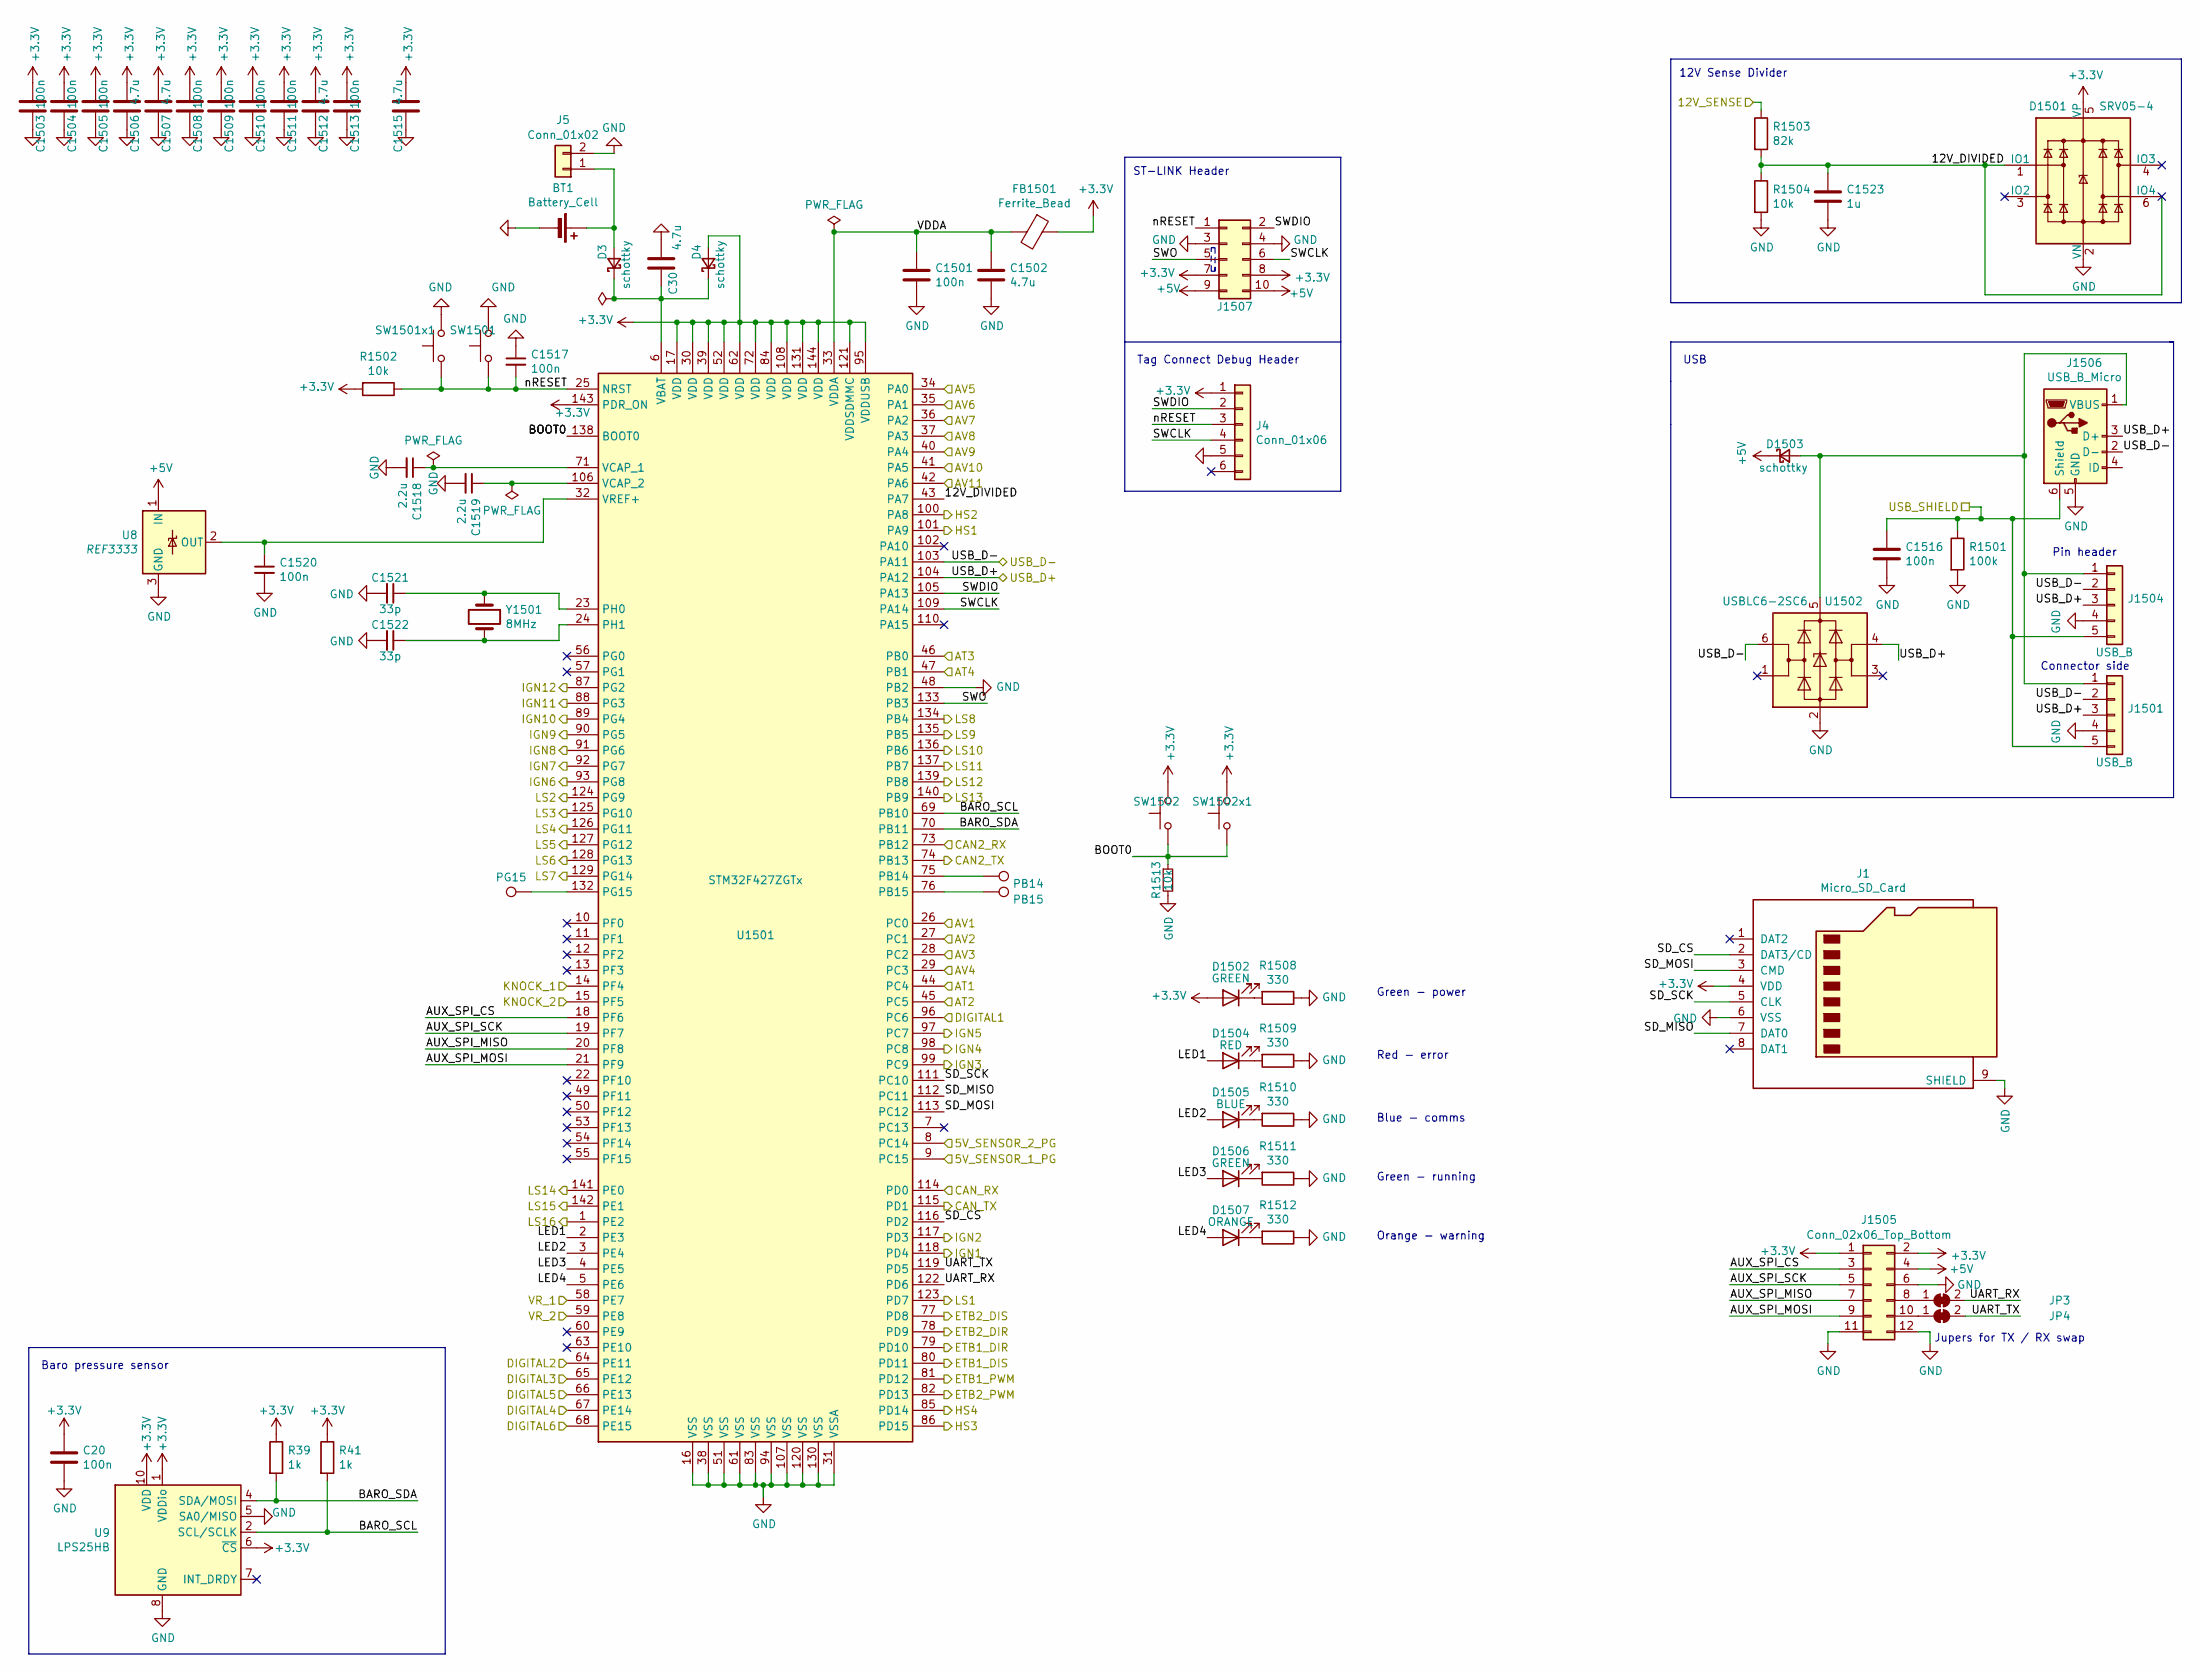
[picture p43: schematic mcu.kicad_sch, rusEfi Proteus v2.0]

Parts:
BT1: Battery_Cell; BatteryHolder_Keystone_1060_1x2032
C20, C1501, C1503, C1504, C1505, C1508, C1509, C1510, C1511, C1513, C1516, C1517, C1520: 100n; C_0603_1608Metric; LCSC C14663
C30, C1502, C1506, C1507, C1512, C1515: 4.7u; C_0603_1608Metric; LCSC C19666
C1518, C1519: 2.2u; C_0603_1608Metric; LCSC C23630
C1521, C1522: 33p; C_0603_1608Metric; LCSC C1562
C1523: 1u; C_0603_1608Metric; LCSC C15849
D3, D4, D1503: schottky; D_SOD-123; LCSC C8598
D1501: SRV05-4; SOT-23-6; LCSC C85364
D1502, D1506: GREEN; LED_0603_1608Metric_Castellated; LCSC C72043
D1504: RED; LED_0603_1608Metric_Castellated; LCSC C2286
D1505: BLUE; LED_0603_1608Metric_Castellated; LCSC C72041
D1507: ORANGE; LED_0603_1608Metric_Castellated; LCSC C72038
FB1501: Ferrite_Bead; L_0805_2012Metric; LCSC C1015
J1: Micro_SD_Card; microSD_HC_Wuerth_693072010801; LCSC C164170
J4: Conn_01x06; Tag-Connect_TC2030-IDC-NL_2x03_P1.27mm_Vertical
J5: Conn_01x02; PinSocket_2x01_P2.54mm_Vertical
J1501: USB_B; USB_B_TE_5787834_Vertical; LCSC N/A
J1504: USB_B; conn_5_2.5mm; LCSC N/A
J1505: Conn_02x06_Top_Bottom; PinHeader_2x06_P2.54mm_Vertical
J1506: USB_B_Micro; USB_Micro-B_Wuerth_614105150721_Vertical; Part # 614105150721
J1507: Conn_02x05_Odd_Even; PinSocket_2x05_P2.54mm_Vertical_SMD; Part # 95278-801B10LF
JP3, JP4: SolderJumper_2_Bridged; SolderJumper-2_P1.3mm_Bridged_Pad1.0x1.5mm
PB14: PB14; TestPoint_Pad_D1.0mm
PB15: PB15; TestPoint_Pad_D1.0mm
PG15: PG15; TestPoint_Pad_D1.0mm
R39, R41: 1k; R_0603_1608Metric; LCSC C11702
R1501: 100k; R_0603_1608Metric; LCSC C25741
R1502, R1504, R1513: 10k; R_0603_1608Metric; LCSC C25744
R1503: 82k; R_0603_1608Metric; LCSC C23254
R1508, R1509, R1510, R1511, R1512: 330; R_0603_1608Metric; LCSC C25104
SW1501, SW1502: SW_Push; SW_SPST_EVQQ2; LCSC C318887
SW1501x1, SW1502x1: SW_Push; SW_SPST_CK_RS282G05A3; LCSC C318887
U8: REF3333; SOT-23; LCSC C130016
U9: LPS25HB; ST_HLGA-10_2.5x2.5mm_P0.6mm_LayoutBorder3x2y; LCSC C94049
U1501: STM32F427ZGTx; LQFP-144_20x20mm_P0.5mm; LCSC C117816
U1502: USBLC6-2SC6; SOT-23-6; LCSC C7519
Y1501: 8MHz; Crystal_SMD_5032-2Pin_5.0x3.2mm; LCSC C115962

Connections:
+3V3: C20.1, C1503.2, C1504.2, C1505.2, C1506.2, C1507.2, C1508.2, C1509.2, C1510.2, C1511.2, C1512.2, C1513.2, C1515.2, D4.2 (A), D1501.5 (VP), D1502.2 (A), FB1501.1, J1.4 (VDD), J4.1, J1505.1, J1505.2, J1507.7, J1507.8, R39.1, R41.1, R1502.2, SW1502.2, SW1502x1.2, U9.1 (VDDio), U9.6 (~CS), U9.10 (VDD), U1501.17 (VDD), U1501.30 (VDD), U1501.39 (VDD), U1501.52 (VDD), U1501.62 (VDD), U1501.72 (VDD), U1501.84 (VDD), U1501.95 (VDDUSB), U1501.108 (VDD), U1501.121 (VDDSDMMC), U1501.131 (VDD), U1501.143 (PDR_ON), U1501.144 (VDD); also elsewhere on the board
+5V: D1503.1 (K), J1505.4, J1507.9, J1507.10, U8.1 (IN); also elsewhere on the board
/12V_RAW: R1503.1; also elsewhere on the board
/USB_D+: J1501.3, J1504.3, J1506.3 (D+), U1501.104 (PA12), U1502.4 (I/O2)
/USB_D-: J1501.2, J1504.2, J1506.2 (D-), U1501.103 (PA11), U1502.6 (I/O1)
/USB_SHIELD: C1516.1, J1501.5, J1504.5, J1506.6 (Shield), R1501.1
/etb-1/DIR: U1501.79 (PD10); also elsewhere on the board
/etb-1/DIS: U1501.80 (PD11); also elsewhere on the board
/etb-1/PWM: U1501.81 (PD12); also elsewhere on the board
/etb-2/DIR: U1501.78 (PD9); also elsewhere on the board
/etb-2/DIS: U1501.77 (PD8); also elsewhere on the board
/etb-2/PWM: U1501.82 (PD13); also elsewhere on the board
/highside_quad/IN1: U1501.101 (PA9); also elsewhere on the board
/highside_quad/IN2: U1501.100 (PA8); also elsewhere on the board
/highside_quad/IN3: U1501.86 (PD15); also elsewhere on the board
/highside_quad/IN4: U1501.85 (PD14); also elsewhere on the board
/ign1/IN1: U1501.118 (PD4); also elsewhere on the board
/ign1/IN2: U1501.117 (PD3); also elsewhere on the board
/ign1/IN3: U1501.99 (PC9); also elsewhere on the board
/ign1/IN4: U1501.98 (PC8); also elsewhere on the board
/ign2/IN1: U1501.97 (PC7); also elsewhere on the board
/ign2/IN2: U1501.93 (PG8); also elsewhere on the board
/ign2/IN3: U1501.92 (PG7); also elsewhere on the board
/ign2/IN4: U1501.91 (PG6); also elsewhere on the board
/ign3/IN1: U1501.90 (PG5); also elsewhere on the board
/ign3/IN2: U1501.89 (PG4); also elsewhere on the board
/ign3/IN3: U1501.88 (PG3); also elsewhere on the board
/ign3/IN4: U1501.87 (PG2); also elsewhere on the board
/knock/FILTERED_1: U1501.14 (PF4); also elsewhere on the board
/knock/FILTERED_2: U1501.15 (PF5); also elsewhere on the board
/lowside_quad1/IN1: U1501.123 (PD7); also elsewhere on the board
/lowside_quad1/IN2: U1501.124 (PG9); also elsewhere on the board
/lowside_quad1/IN3: U1501.125 (PG10); also elsewhere on the board
/lowside_quad1/IN4: U1501.126 (PG11); also elsewhere on the board
/lowside_quad2/IN1: U1501.127 (PG12); also elsewhere on the board
/lowside_quad2/IN2: U1501.128 (PG13); also elsewhere on the board
/lowside_quad2/IN3: U1501.129 (PG14); also elsewhere on the board
/lowside_quad2/IN4: U1501.134 (PB4); also elsewhere on the board
/lowside_quad3/IN1: U1501.135 (PB5); also elsewhere on the board
/lowside_quad3/IN2: U1501.136 (PB6); also elsewhere on the board
/lowside_quad3/IN3: U1501.137 (PB7); also elsewhere on the board
/lowside_quad3/IN4: U1501.139 (PB8); also elsewhere on the board
/lowside_quad4/IN1: U1501.140 (PB9); also elsewhere on the board
/lowside_quad4/IN2: U1501.141 (PE0); also elsewhere on the board
/lowside_quad4/IN3: U1501.142 (PE1); also elsewhere on the board
/lowside_quad4/IN4: U1501.1 (PE2); also elsewhere on the board
/mcu/5V_SENSOR_1_PG: U1501.9 (PC15); also elsewhere on the board
/mcu/5V_SENSOR_2_PG: U1501.8 (PC14); also elsewhere on the board
/mcu/12V_DIVIDED: C1523.1, D1501.1 (IO1), D1501.6 (IO4), R1503.2, R1504.1, U1501.43 (PA7)
/mcu/AT1: U1501.44 (PC4); also elsewhere on the board
/mcu/AT2: U1501.45 (PC5); also elsewhere on the board
/mcu/AT3: U1501.46 (PB0); also elsewhere on the board
/mcu/AT4: U1501.47 (PB1); also elsewhere on the board
/mcu/AUX_SPI_CS: J1505.3, U1501.18 (PF6)
/mcu/AUX_SPI_MISO: J1505.7, U1501.20 (PF8)
/mcu/AUX_SPI_MOSI: J1505.9, U1501.21 (PF9)
/mcu/AUX_SPI_SCK: J1505.5, U1501.19 (PF7)
/mcu/AV1: U1501.26 (PC0); also elsewhere on the board
/mcu/AV2: U1501.27 (PC1); also elsewhere on the board
/mcu/AV3: U1501.28 (PC2); also elsewhere on the board
/mcu/AV4: U1501.29 (PC3); also elsewhere on the board
/mcu/AV5: U1501.34 (PA0); also elsewhere on the board
/mcu/AV6: U1501.35 (PA1); also elsewhere on the board
/mcu/AV7: U1501.36 (PA2); also elsewhere on the board
/mcu/AV8: U1501.37 (PA3); also elsewhere on the board
/mcu/AV9: U1501.40 (PA4); also elsewhere on the board
/mcu/AV10: U1501.41 (PA5); also elsewhere on the board
/mcu/AV11: U1501.42 (PA6); also elsewhere on the board
/mcu/BARO_SCL: R41.2, U9.2 (SCL/SCLK), U1501.69 (PB10)
/mcu/BARO_SDA: R39.2, U9.4 (SDA/MOSI), U1501.70 (PB11)
/mcu/BOOT0: R1513.1, SW1502.1, SW1502x1.1, U1501.138 (BOOT0)
/mcu/CAN2_RX: U1501.73 (PB12); also elsewhere on the board
/mcu/CAN2_TX: U1501.74 (PB13); also elsewhere on the board
/mcu/CAN_RX: U1501.114 (PD0); also elsewhere on the board
/mcu/CAN_TX: U1501.115 (PD1); also elsewhere on the board
/mcu/DIGITAL1: U1501.96 (PC6); also elsewhere on the board
/mcu/DIGITAL2: U1501.64 (PE11); also elsewhere on the board
/mcu/DIGITAL3: U1501.65 (PE12); also elsewhere on the board
/mcu/DIGITAL4: U1501.67 (PE14); also elsewhere on the board
/mcu/DIGITAL5: U1501.66 (PE13); also elsewhere on the board
/mcu/DIGITAL6: U1501.68 (PE15); also elsewhere on the board
/mcu/LED1: D1504.2 (A), U1501.2 (PE3)
/mcu/LED2: D1505.2 (A), U1501.3 (PE4)
/mcu/LED3: D1506.2 (A), U1501.4 (PE5)
/mcu/LED4: D1507.2 (A), U1501.5 (PE6)
/mcu/SD_CS: J1.2 (DAT3/CD), U1501.116 (PD2)
/mcu/SD_MISO: J1.7 (DAT0), U1501.112 (PC11)
/mcu/SD_MOSI: J1.3 (CMD), U1501.113 (PC12)
/mcu/SD_SCK: J1.5 (CLK), U1501.111 (PC10)
/mcu/SWCLK: J4.4, J1507.6, U1501.109 (PA14)
/mcu/SWDIO: J4.2, J1507.2, U1501.105 (PA13)
/mcu/SWO: J1507.5, U1501.133 (PB3)
/mcu/UART_RX: JP3.2 (B), U1501.122 (PD6)
/mcu/UART_TX: JP4.2 (B), U1501.119 (PD5)
/mcu/VDDA: C1501.1, C1502.1, FB1501.2, U1501.33 (VDDA)
/mcu/VR_1: U1501.58 (PE7); also elsewhere on the board
/mcu/VR_2: U1501.59 (PE8); also elsewhere on the board
/mcu/nRESET: C1517.2, J4.3, J1507.1, R1502.1, SW1501.1, SW1501x1.1, U1501.25 (NRST)
GND: BT1.2 (-), C20.2, C30.2, C1501.2, C1502.2, C1503.1, C1504.1, C1505.1, C1506.1, C1507.1, C1508.1, C1509.1, C1510.1, C1511.1, C1512.1, C1513.1, C1515.1, C1516.2, C1517.1, C1518.2, C1519.2, C1520.2, C1521.2, C1522.2, C1523.2, D1501.2 (VN), J1.6 (VSS), J1.9 (SHIELD), J4.5, J5.2, J1501.4, J1504.4, J1505.6, J1505.11, J1505.12, J1506.5 (GND), J1507.3, J1507.4, R1501.2, R1504.2, R1508.1, R1509.1, R1510.1, R1511.1, R1512.1, R1513.2, SW1501.2, SW1501x1.2, U8.3 (GND), U9.3 (GND), U9.5 (SA0/MISO), U9.8 (GND), U9.9 (GND), U1501.16 (VSS), U1501.31 (VSSA), U1501.38 (VSS), U1501.48 (PB2), U1501.51 (VSS), U1501.61 (VSS), U1501.83 (VSS), U1501.94 (VSS), U1501.107 (VSS), U1501.120 (VSS), U1501.130 (VSS), U1502.2 (GND); also elsewhere on the board
unnamed: BT1.1 (+), D3.2 (A), J5.1
unnamed: C30.1, D3.1 (K), D4.1 (K), U1501.6 (VBAT)
unnamed: D1502.1 (K), R1508.2
unnamed: D1503.2 (A), J1501.1, J1504.1, J1506.1 (VBUS), U1502.5 (VBUS)
unnamed: D1504.1 (K), R1509.2
unnamed: D1505.1 (K), R1510.2
unnamed: D1506.1 (K), R1511.2
unnamed: D1507.1 (K), R1512.2
unnamed: J1505.8, JP3.1 (A)
unnamed: J1505.10, JP4.1 (A)
unnamed: PB14.1, U1501.75 (PB14)
unnamed: PB15.1, U1501.76 (PB15)
unnamed: PG15.1, U1501.132 (PG15)
unnamed: C1521.1, U1501.23 (PH0), Y1501.1
unnamed: C1522.1, U1501.24 (PH1), Y1501.2
unnamed: C1518.1, U1501.71 (VCAP_1)
unnamed: C1519.1, U1501.106 (VCAP_2)
unnamed: C1520.1, U8.2 (OUT), U1501.32 (VREF+)

Notes on the sheet:
12V Sense Divider
Red - error
USB
Pin header
Baro pressure sensor
Green - power
Blue - comms
ST-LINK Header
Orange - warning
Jupers for TX / RX swap
Green - running
Tag Connect Debug Header
Connector side
