JRDMcLAREN/proteus-V2.0/proteus.kicad_pcb

## KiCad design proteus.kicad_pcb (continued)

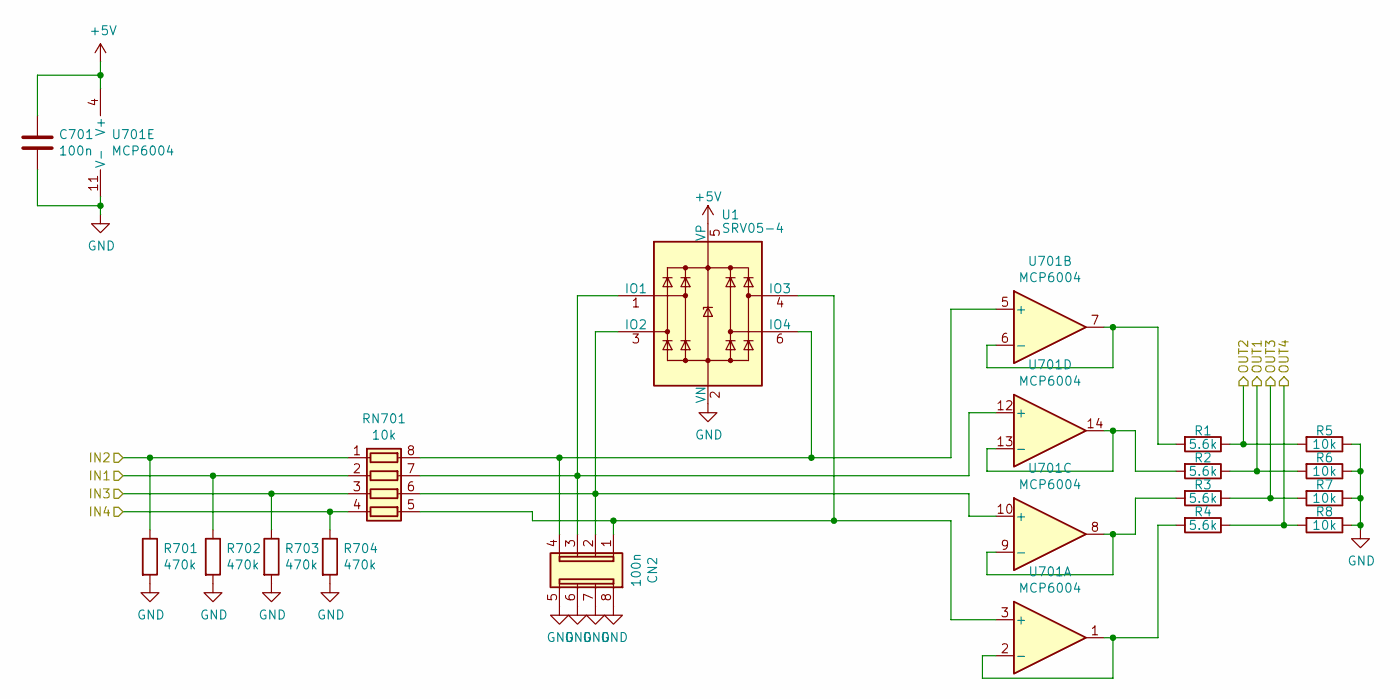
[picture p44: schematic quad_analog1.kicad_sch, rusEfi Proteus v2.0]

Parts:
C701: 100n; C_0603_1608Metric; LCSC C14663
CN2: 100n; R_Array_Convex_4x0603; LCSC C29718
R1, R2, R3, R4: 5.6k; R_0603_1608Metric; LCSC C25908
R5, R6, R7, R8: 10k; R_0603_1608Metric; LCSC C25744
R701, R702, R703, R704: 470k; R_0603_1608Metric; LCSC C25790
RN701: 10k; R_Array_Convex_4x0603; LCSC C29718
U1: SRV05-4; SOT-23-6; LCSC C85364
U701: MCP6004; TSSOP-14_4.4x5mm_P0.65mm; LCSC C50282

Connections:
+5V: C701.1, U1.5 (VP), U701.4 (V+); also elsewhere on the board
/AV1: R702.1, RN701.2 (R2.1); also elsewhere on the board
/AV2: R701.1, RN701.1 (R1.1); also elsewhere on the board
/AV3: R703.1, RN701.3 (R3.1); also elsewhere on the board
/AV4: R704.1, RN701.4 (R4.1); also elsewhere on the board
/mcu/AV1: R2.1, R6.2; also elsewhere on the board
/mcu/AV2: R1.1, R5.2; also elsewhere on the board
/mcu/AV3: R3.1, R7.2; also elsewhere on the board
/mcu/AV4: R4.1, R8.2; also elsewhere on the board
GND: C701.2, CN2.5 (R4.2), CN2.6 (R3.2), CN2.7 (R2.2), CN2.8 (R1.2), R5.1, R6.1, R7.1, R8.1, R701.2, R702.2, R703.2, R704.2, U1.2 (VN), U701.11 (V-); also elsewhere on the board
unnamed: CN2.1 (R1.1), RN701.5 (R4.2), U1.4 (IO3), U701.3 (+)
unnamed: CN2.2 (R2.1), RN701.6 (R3.2), U1.3 (IO2), U701.10 (+)
unnamed: CN2.3 (R3.1), RN701.7 (R2.2), U1.1 (IO1), U701.12 (+)
unnamed: CN2.4 (R4.1), RN701.8 (R1.2), U1.6 (IO4), U701.5 (+)
unnamed: R4.2, U701.1, U701.2 (-)
unnamed: R1.2, U701.6 (-), U701.7
unnamed: R3.2, U701.8, U701.9 (-)
unnamed: R2.2, U701.13 (-), U701.14

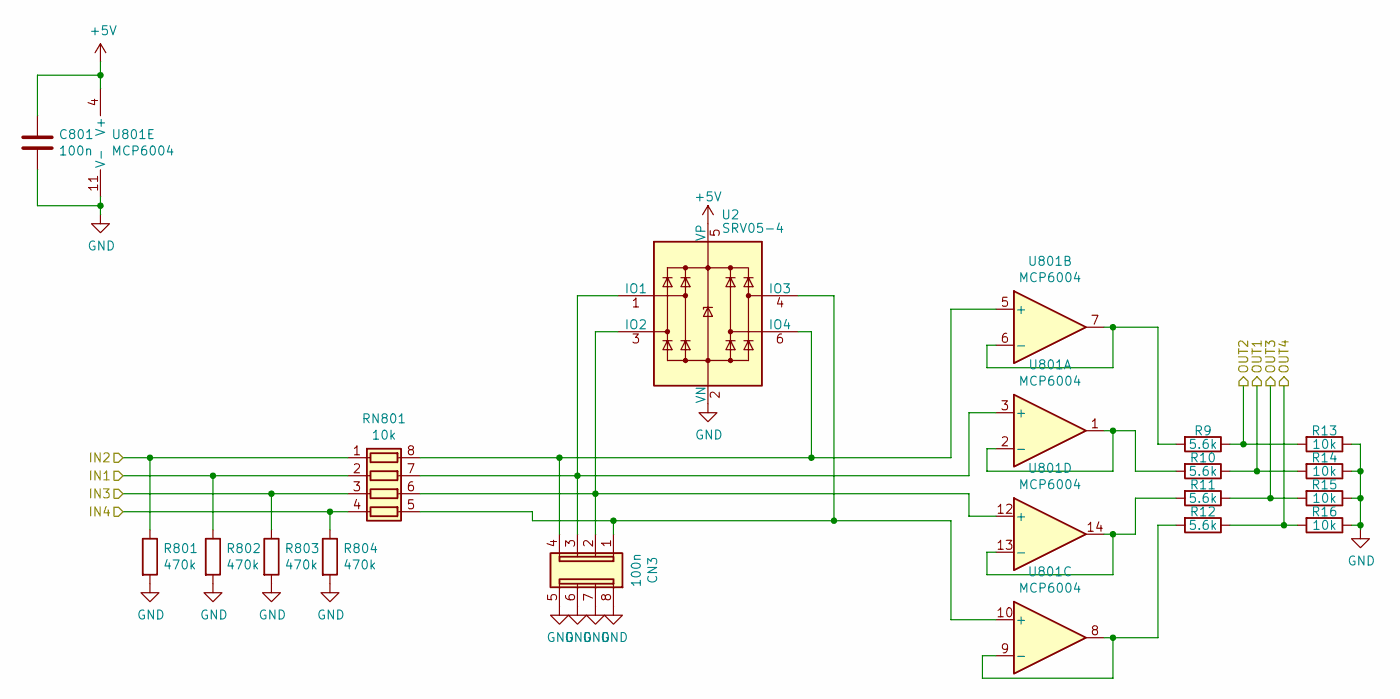
[picture p45: schematic quad_analog2.kicad_sch, rusEfi Proteus v2.0]

Parts:
C801: 100n; C_0603_1608Metric; LCSC C14663
CN3: 100n; R_Array_Convex_4x0603; LCSC C29718
R9, R10, R11, R12: 5.6k; R_0603_1608Metric; LCSC C25908
R13, R14, R15, R16: 10k; R_0603_1608Metric; LCSC C25744
R801, R802, R803, R804: 470k; R_0603_1608Metric; LCSC C25790
RN801: 10k; R_Array_Convex_4x0603; LCSC C29718
U2: SRV05-4; SOT-23-6; LCSC C85364
U801: MCP6004; TSSOP-14_4.4x5mm_P0.65mm; LCSC C50282

Connections:
+5V: C801.1, U2.5 (VP), U801.4 (V+); also elsewhere on the board
/AV5: R802.1, RN801.2 (R2.1); also elsewhere on the board
/AV6: R801.1, RN801.1 (R1.1); also elsewhere on the board
/AV7: R803.1, RN801.3 (R3.1); also elsewhere on the board
/AV8: R804.1, RN801.4 (R4.1); also elsewhere on the board
/mcu/AV5: R10.1, R14.2; also elsewhere on the board
/mcu/AV6: R9.1, R13.2; also elsewhere on the board
/mcu/AV7: R11.1, R15.2; also elsewhere on the board
/mcu/AV8: R12.1, R16.2; also elsewhere on the board
GND: C801.2, CN3.5 (R4.2), CN3.6 (R3.2), CN3.7 (R2.2), CN3.8 (R1.2), R13.1, R14.1, R15.1, R16.1, R801.2, R802.2, R803.2, R804.2, U2.2 (VN), U801.11 (V-); also elsewhere on the board
unnamed: CN3.1 (R1.1), RN801.5 (R4.2), U2.4 (IO3), U801.10 (+)
unnamed: CN3.2 (R2.1), RN801.6 (R3.2), U2.3 (IO2), U801.12 (+)
unnamed: CN3.3 (R3.1), RN801.7 (R2.2), U2.1 (IO1), U801.3 (+)
unnamed: CN3.4 (R4.1), RN801.8 (R1.2), U2.6 (IO4), U801.5 (+)
unnamed: R10.2, U801.1, U801.2 (-)
unnamed: R9.2, U801.6 (-), U801.7
unnamed: R12.2, U801.8, U801.9 (-)
unnamed: R11.2, U801.13 (-), U801.14

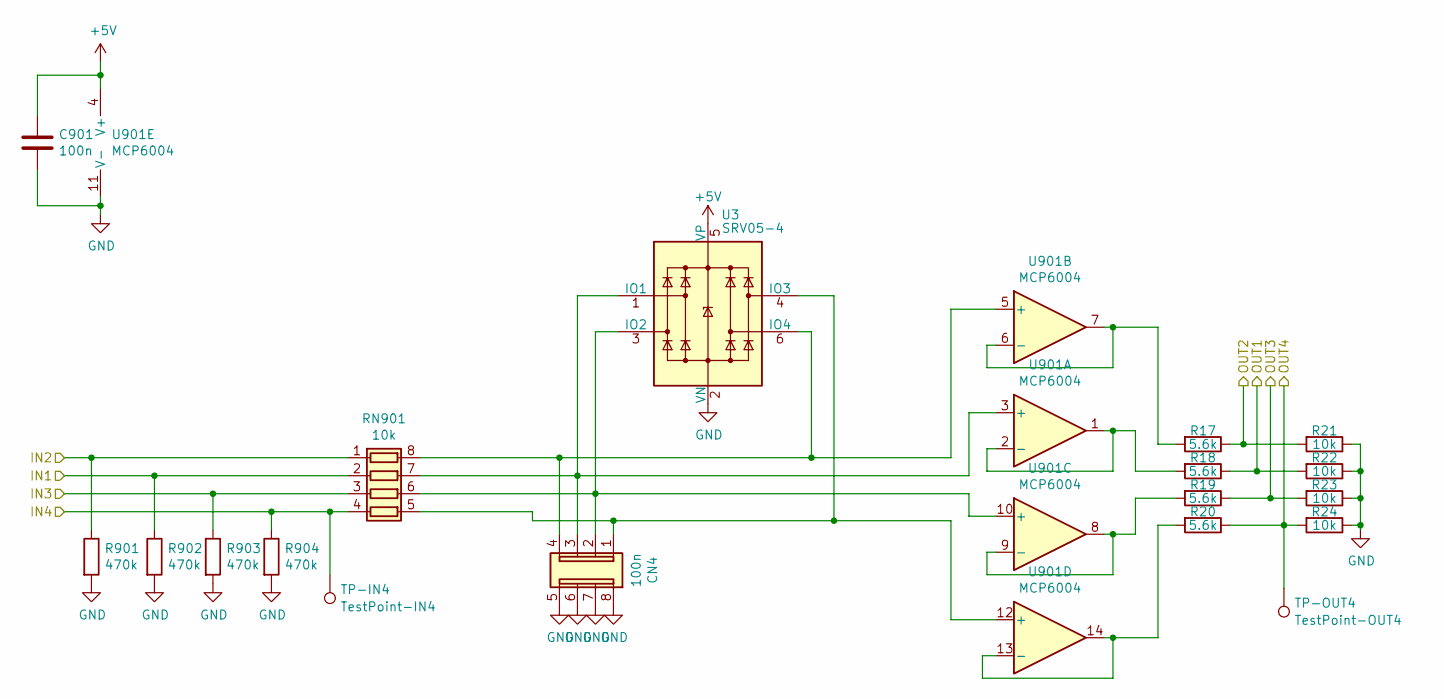
[picture p46: schematic quad_analog3.kicad_sch, rusEfi Proteus v2.0]

Parts:
C901: 100n; C_0603_1608Metric; LCSC C14663
CN4: 100n; R_Array_Convex_4x0603; LCSC C29718
R17, R18, R19, R20: 5.6k; R_0603_1608Metric; LCSC C25908
R21, R22, R23, R24: 10k; R_0603_1608Metric; LCSC C25744
R901, R902, R903, R904: 470k; R_0603_1608Metric; LCSC C25790
RN901: 10k; R_Array_Convex_4x0603; LCSC C29718
TP-IN4: TestPoint-IN4; TestPoint_Pad_D1.0mm
TP-OUT4: TestPoint-OUT4; TestPoint_Pad_D1.0mm
U3: SRV05-4; SOT-23-6; LCSC C85364
U901: MCP6004; TSSOP-14_4.4x5mm_P0.65mm; LCSC C50282

Connections:
+5V: C901.1, U3.5 (VP), U901.4 (V+); also elsewhere on the board
/AV9: R902.1, RN901.2 (R2.1); also elsewhere on the board
/AV10: R901.1, RN901.1 (R1.1); also elsewhere on the board
/AV11: R903.1, RN901.3 (R3.1); also elsewhere on the board
/mcu/AV9: R18.1, R22.2; also elsewhere on the board
/mcu/AV10: R17.1, R21.2; also elsewhere on the board
/mcu/AV11: R19.1, R23.2; also elsewhere on the board
/quad_analog3/IN4: R904.1, RN901.4 (R4.1), TP-IN4.1
/quad_analog3/OUT4: R20.1, R24.2, TP-OUT4.1
GND: C901.2, CN4.5 (R4.2), CN4.6 (R3.2), CN4.7 (R2.2), CN4.8 (R1.2), R21.1, R22.1, R23.1, R24.1, R901.2, R902.2, R903.2, R904.2, U3.2 (VN), U901.11 (V-); also elsewhere on the board
unnamed: CN4.1 (R1.1), RN901.5 (R4.2), U3.4 (IO3), U901.12 (+)
unnamed: CN4.2 (R2.1), RN901.6 (R3.2), U3.3 (IO2), U901.10 (+)
unnamed: CN4.3 (R3.1), RN901.7 (R2.2), U3.1 (IO1), U901.3 (+)
unnamed: CN4.4 (R4.1), RN901.8 (R1.2), U3.6 (IO4), U901.5 (+)
unnamed: R18.2, U901.1, U901.2 (-)
unnamed: R17.2, U901.6 (-), U901.7
unnamed: R19.2, U901.8, U901.9 (-)
unnamed: R20.2, U901.13 (-), U901.14

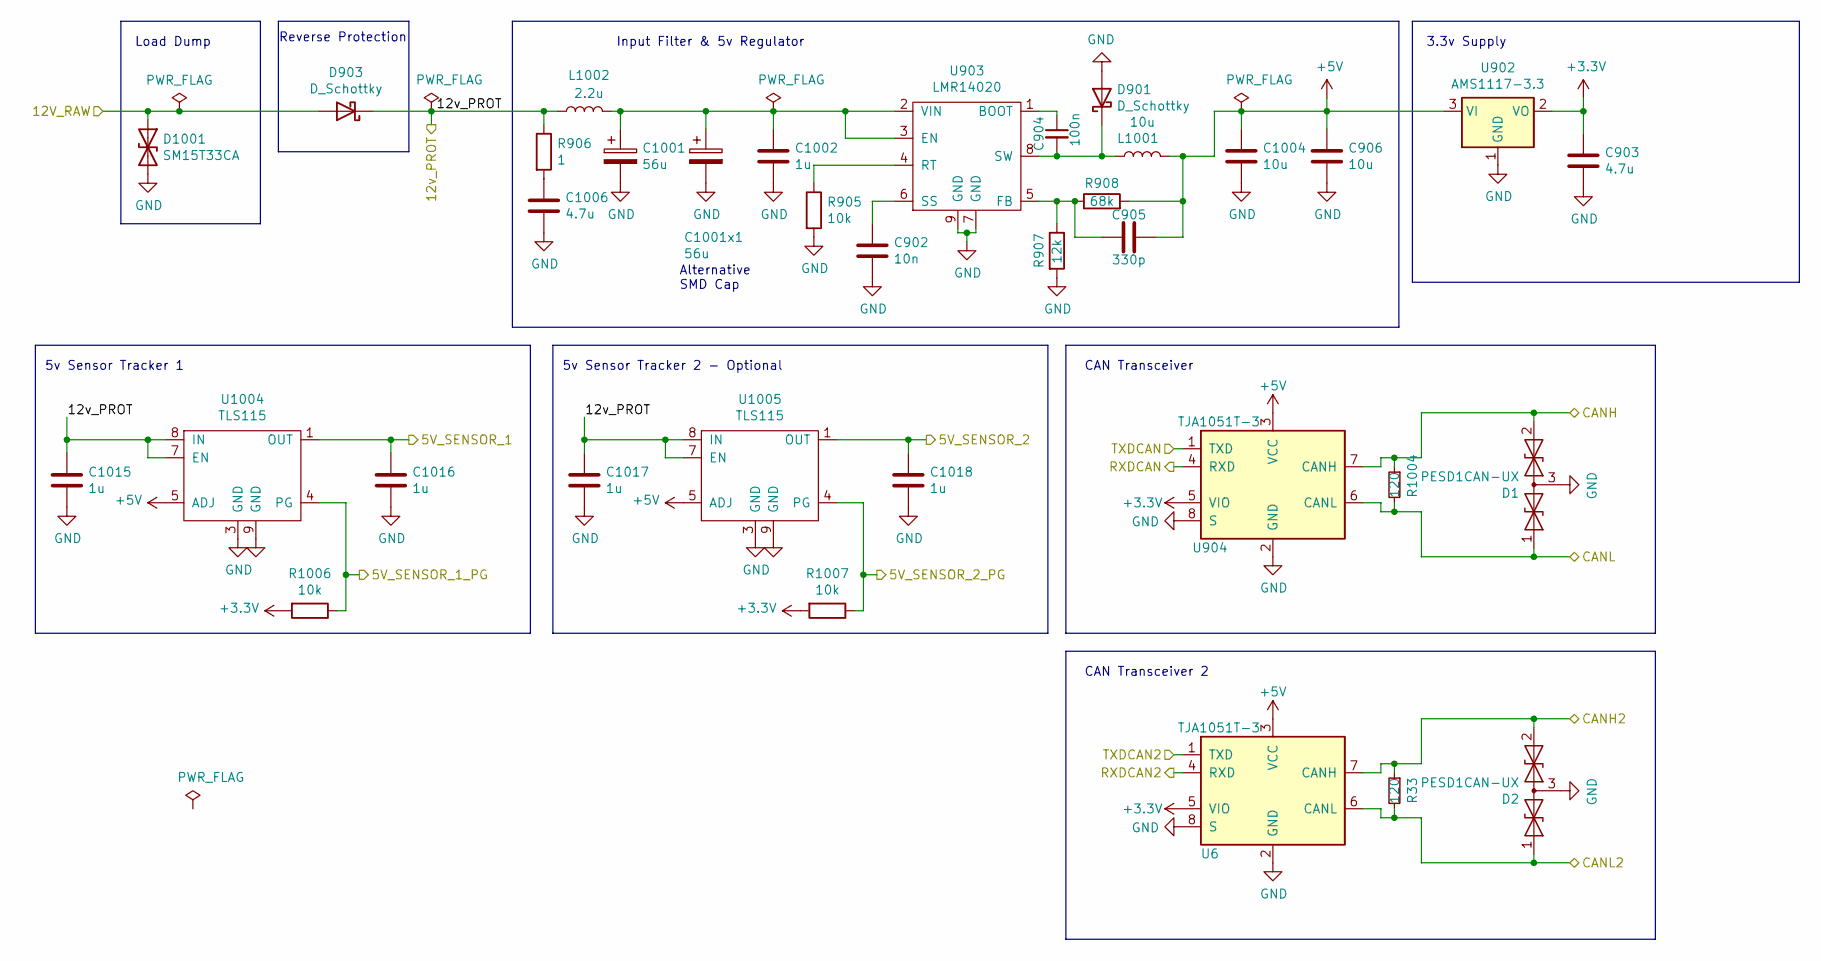
[picture p47: schematic psu.kicad_sch, rusEfi Proteus v2.0]

Parts:
C902: 10n; C_0603_1608Metric; LCSC C57112
C903, C1006: 4.7u; C_0603_1608Metric; LCSC C19666
C904: 100n; C_0603_1608Metric; LCSC C14663
C905: 330p; C_0603_1608Metric; LCSC C13533
C906, C1004: 10u; C_1206_3216Metric; LCSC C13585
C1001: 56u; CP_Radial_D8.0mm_P3.50mm; LCSC N/A
C1001x1: 56u; CP_Elec_6.3x9.9; LCSC N/A
C1002, C1015, C1016, C1017, C1018: 1u; C_0603_1608Metric; LCSC C15849
D1, D2: PESD1CAN-UX; SOT-323_SC-70; LCSC C152727
D901, D903: D_Schottky; D_SMA; LCSC C8678
D1001: SM15T33CA; D_SMC; LCSC C151281
L1001: 10u; MWSA0503; LCSC C408412
L1002: 2.2u; L_1210_3225Metric; LCSC C36828
R33, R1004: 120; R_0603_1608Metric; LCSC C22787
R905, R1006, R1007: 10k; R_0603_1608Metric; LCSC C25744
R906: 1; R_0603_1608Metric; LCSC C25086
R907: 12k; R_0603_1608Metric; LCSC C25752
R908: 68k; R_0603_1608Metric; LCSC C36871
U6, U904: TJA1051T-3; SOIC-8_3.9x4.9mm_P1.27mm; LCSC C38695
U902: AMS1117-3.3; SOT-223-3_TabPin2; LCSC C6186
U903: LMR14020; SOIC-8-1EP_3.9x4.9mm_P1.27mm_EP2.29x3mm; LCSC C187824
U1004, U1005: TLS115; Infineon_PG-DSO-8-43; LCSC N/A

Connections:
+3V3: C903.1, R1006.2, R1007.2, U6.5 (VIO), U902.2 (VO), U904.5 (VIO); also elsewhere on the board
+5V: C905.1, C906.1, C1004.1, L1001.2, R908.2, U6.3 (VCC), U902.3 (VI), U904.3 (VCC), U1004.5 (ADJ), U1005.5 (ADJ); also elsewhere on the board
/5V_SENSOR_1: C1016.1, U1004.1 (OUT); also elsewhere on the board
/5V_SENSOR_2: C1018.1, U1005.1 (OUT); also elsewhere on the board
/12V_PROT: C1015.1, C1017.1, D903.1 (K), L1002.1, R906.1, U1004.7 (EN), U1004.8 (IN), U1005.7 (EN), U1005.8 (IN); also elsewhere on the board
/12V_RAW: D903.2 (A), D1001.1 (A1); also elsewhere on the board
/CAN2+: D2.2 (A2), R33.1, U6.7 (CANH); also elsewhere on the board
/CAN2-: D2.1 (A1), R33.2, U6.6 (CANL); also elsewhere on the board
/CAN+: D1.2 (A2), R1004.1, U904.7 (CANH); also elsewhere on the board
/CAN-: D1.1 (A1), R1004.2, U904.6 (CANL); also elsewhere on the board
/mcu/5V_SENSOR_1_PG: R1006.1, U1004.4 (PG); also elsewhere on the board
/mcu/5V_SENSOR_2_PG: R1007.1, U1005.4 (PG); also elsewhere on the board
/mcu/CAN2_RX: U6.4 (RXD); also elsewhere on the board
/mcu/CAN2_TX: U6.1 (TXD); also elsewhere on the board
/mcu/CAN_RX: U904.4 (RXD); also elsewhere on the board
/mcu/CAN_TX: U904.1 (TXD); also elsewhere on the board
GND: C902.2, C903.2, C906.2, C1001.2, C1001x1.2, C1002.2, C1004.2, C1006.2, C1015.2, C1016.2, C1017.2, C1018.2, D1.3 (common), D2.3 (common), D901.2 (A), D1001.2 (A2), R905.2, R907.2, U6.2 (GND), U6.8 (S), U902.1 (GND), U903.7 (GND), U903.9 (GND), U904.2 (GND), U904.8 (S), U1004.3 (GND), U1004.9 (GND), U1005.3 (GND), U1005.9 (GND); also elsewhere on the board
unnamed: C1006.1, R906.2
unnamed: C904.2, D901.1 (K), L1001.1, U903.8 (SW)
unnamed: C904.1, U903.1 (BOOT)
unnamed: C1001.1, C1001x1.1, C1002.1, L1002.2, U903.2 (VIN), U903.3 (EN)
unnamed: C905.2, R907.1, R908.1, U903.5 (FB)
unnamed: R905.1, U903.4 (RT)
unnamed: C902.1, U903.6 (SS)

Notes on the sheet:
Alternative SMD Cap
3.3v Supply
CAN Transceiver 2
5v Sensor Tracker 2 - Optional
Input Filter & 5v Regulator
CAN Transceiver
Reverse Protection
Load Dump
5v Sensor Tracker 1

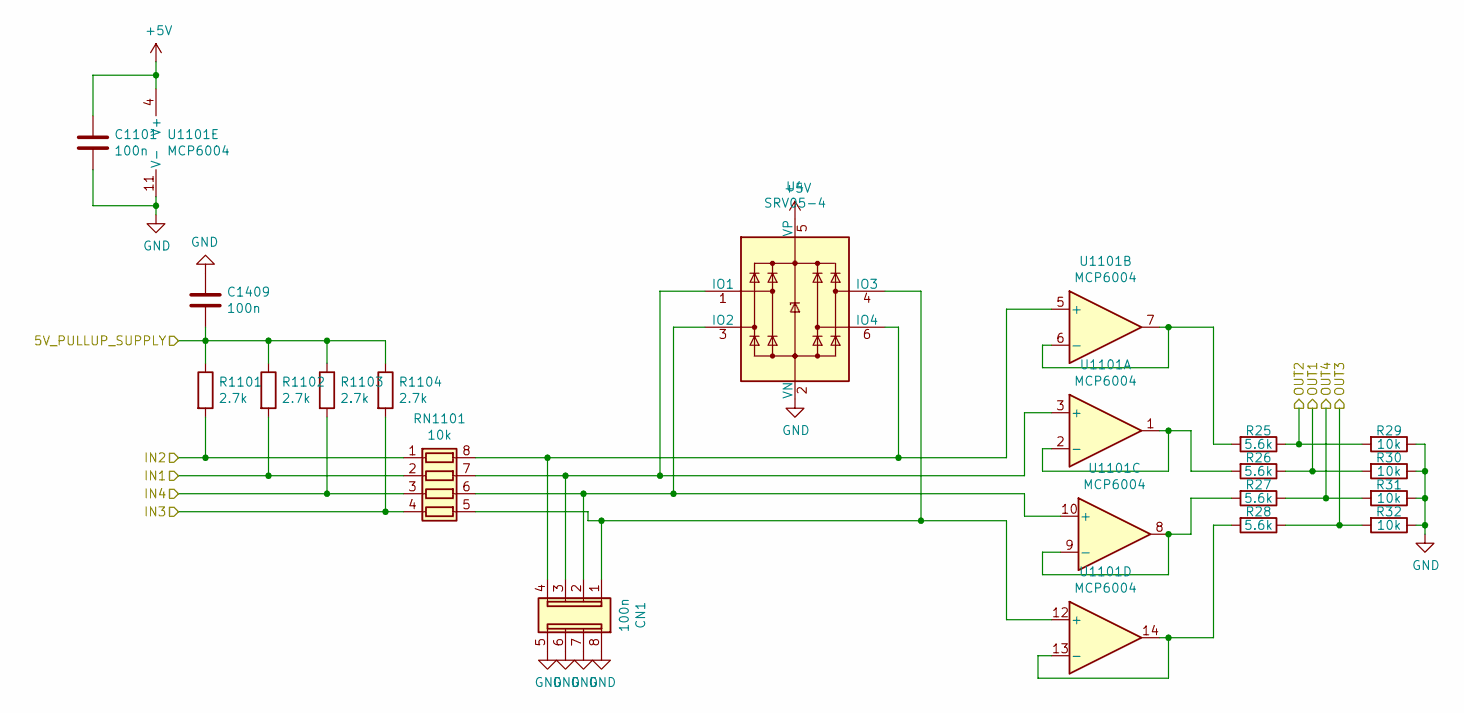
[picture p48: schematic quad_analog_pullup.kicad_sch, rusEfi Proteus v2.0]

Parts:
C1101, C1409: 100n; C_0603_1608Metric; LCSC C14663
CN1: 100n; R_Array_Convex_4x0603; LCSC C29718
R25, R26, R27, R28: 5.6k; R_0603_1608Metric; LCSC C25908
R29, R30, R31, R32: 10k; R_0603_1608Metric; LCSC C25744
R1101, R1102, R1103, R1104: 2.7k; R_0603_1608Metric; LCSC C13167
RN1101: 10k; R_Array_Convex_4x0603; LCSC C29718
U4: SRV05-4; SOT-23-6; LCSC C85364
U1101: MCP6004; TSSOP-14_4.4x5mm_P0.65mm; LCSC C50282

Connections:
+5V: C1101.1, U4.5 (VP), U1101.4 (V+); also elsewhere on the board
/5V_SENSOR_1: C1409.2, R1101.1, R1102.1, R1103.1, R1104.1; also elsewhere on the board
/AT1: R1102.2, RN1101.2 (R2.1); also elsewhere on the board
/AT2: R1101.2, RN1101.1 (R1.1); also elsewhere on the board
/AT3: R1104.2, RN1101.4 (R4.1); also elsewhere on the board
/AT4: R1103.2, RN1101.3 (R3.1); also elsewhere on the board
/mcu/AT1: R26.1, R30.2; also elsewhere on the board
/mcu/AT2: R25.1, R29.2; also elsewhere on the board
/mcu/AT3: R28.1, R32.2; also elsewhere on the board
/mcu/AT4: R27.1, R31.2; also elsewhere on the board
GND: C1101.2, C1409.1, CN1.5 (R4.2), CN1.6 (R3.2), CN1.7 (R2.2), CN1.8 (R1.2), R29.1, R30.1, R31.1, R32.1, U4.2 (VN), U1101.11 (V-); also elsewhere on the board
unnamed: CN1.1 (R1.1), RN1101.5 (R4.2), U4.4 (IO3), U1101.12 (+)
unnamed: CN1.2 (R2.1), RN1101.6 (R3.2), U4.3 (IO2), U1101.10 (+)
unnamed: CN1.3 (R3.1), RN1101.7 (R2.2), U4.1 (IO1), U1101.3 (+)
unnamed: CN1.4 (R4.1), RN1101.8 (R1.2), U4.6 (IO4), U1101.5 (+)
unnamed: R26.2, U1101.1, U1101.2 (-)
unnamed: R25.2, U1101.6 (-), U1101.7
unnamed: R27.2, U1101.8, U1101.9 (-)
unnamed: R28.2, U1101.13 (-), U1101.14

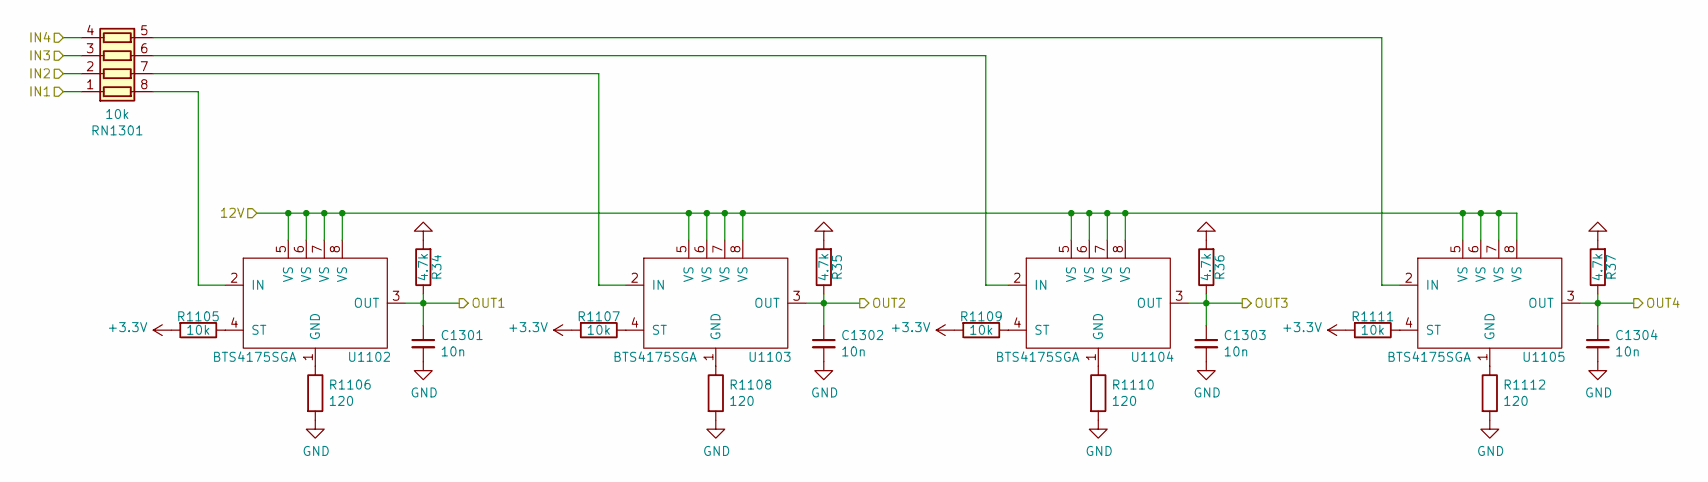
[picture p49: schematic highside_quad.kicad_sch, rusEfi Proteus v2.0]

Parts:
C1301, C1302, C1303, C1304: 10n; C_0603_1608Metric; LCSC C57112
R34, R35, R36, R37: 4.7k; R_0805_2012Metric; LCSC C17673
R1105, R1107, R1109, R1111: 10k; R_0603_1608Metric; LCSC C25744
R1106, R1108, R1110, R1112: 120; R_0603_1608Metric; LCSC C22787
RN1301: 10k; R_Array_Convex_4x0603; LCSC C29718
U1102, U1103, U1104, U1105: BTS4175SGA; SOIC-8_3.9x4.9mm_P1.27mm; LCSC C152451

Connections:
+3V3: R1105.2, R1107.2, R1109.2, R1111.2; also elsewhere on the board
/12V_MR: U1102.5 (VS), U1102.6 (VS), U1102.7 (VS), U1102.8 (VS), U1103.5 (VS), U1103.6 (VS), U1103.7 (VS), U1103.8 (VS), U1104.5 (VS), U1104.6 (VS), U1104.7 (VS), U1104.8 (VS), U1105.5 (VS), U1105.6 (VS), U1105.7 (VS), U1105.8 (VS); also elsewhere on the board
/HS1: C1301.1, R34.1, U1102.3 (OUT); also elsewhere on the board
/HS2: C1302.1, R35.1, U1103.3 (OUT); also elsewhere on the board
/HS3: C1303.1, R36.1, U1104.3 (OUT); also elsewhere on the board
/HS4: C1304.1, R37.1, U1105.3 (OUT); also elsewhere on the board
/highside_quad/IN1: RN1301.1 (R1.1); also elsewhere on the board
/highside_quad/IN2: RN1301.2 (R2.1); also elsewhere on the board
/highside_quad/IN3: RN1301.3 (R3.1); also elsewhere on the board
/highside_quad/IN4: RN1301.4 (R4.1); also elsewhere on the board
GND: C1301.2, C1302.2, C1303.2, C1304.2, R34.2, R35.2, R36.2, R37.2, R1106.2, R1108.2, R1110.2, R1112.2; also elsewhere on the board
unnamed: RN1301.8 (R1.2), U1102.2 (IN)
unnamed: RN1301.7 (R2.2), U1103.2 (IN)
unnamed: RN1301.6 (R3.2), U1104.2 (IN)
unnamed: RN1301.5 (R4.2), U1105.2 (IN)
unnamed: R1106.1, U1102.1 (GND)
unnamed: R1105.1, U1102.4 (ST)
unnamed: R1108.1, U1103.1 (GND)
unnamed: R1107.1, U1103.4 (ST)
unnamed: R1110.1, U1104.1 (GND)
unnamed: R1109.1, U1104.4 (ST)
unnamed: R1112.1, U1105.1 (GND)
unnamed: R1111.1, U1105.4 (ST)

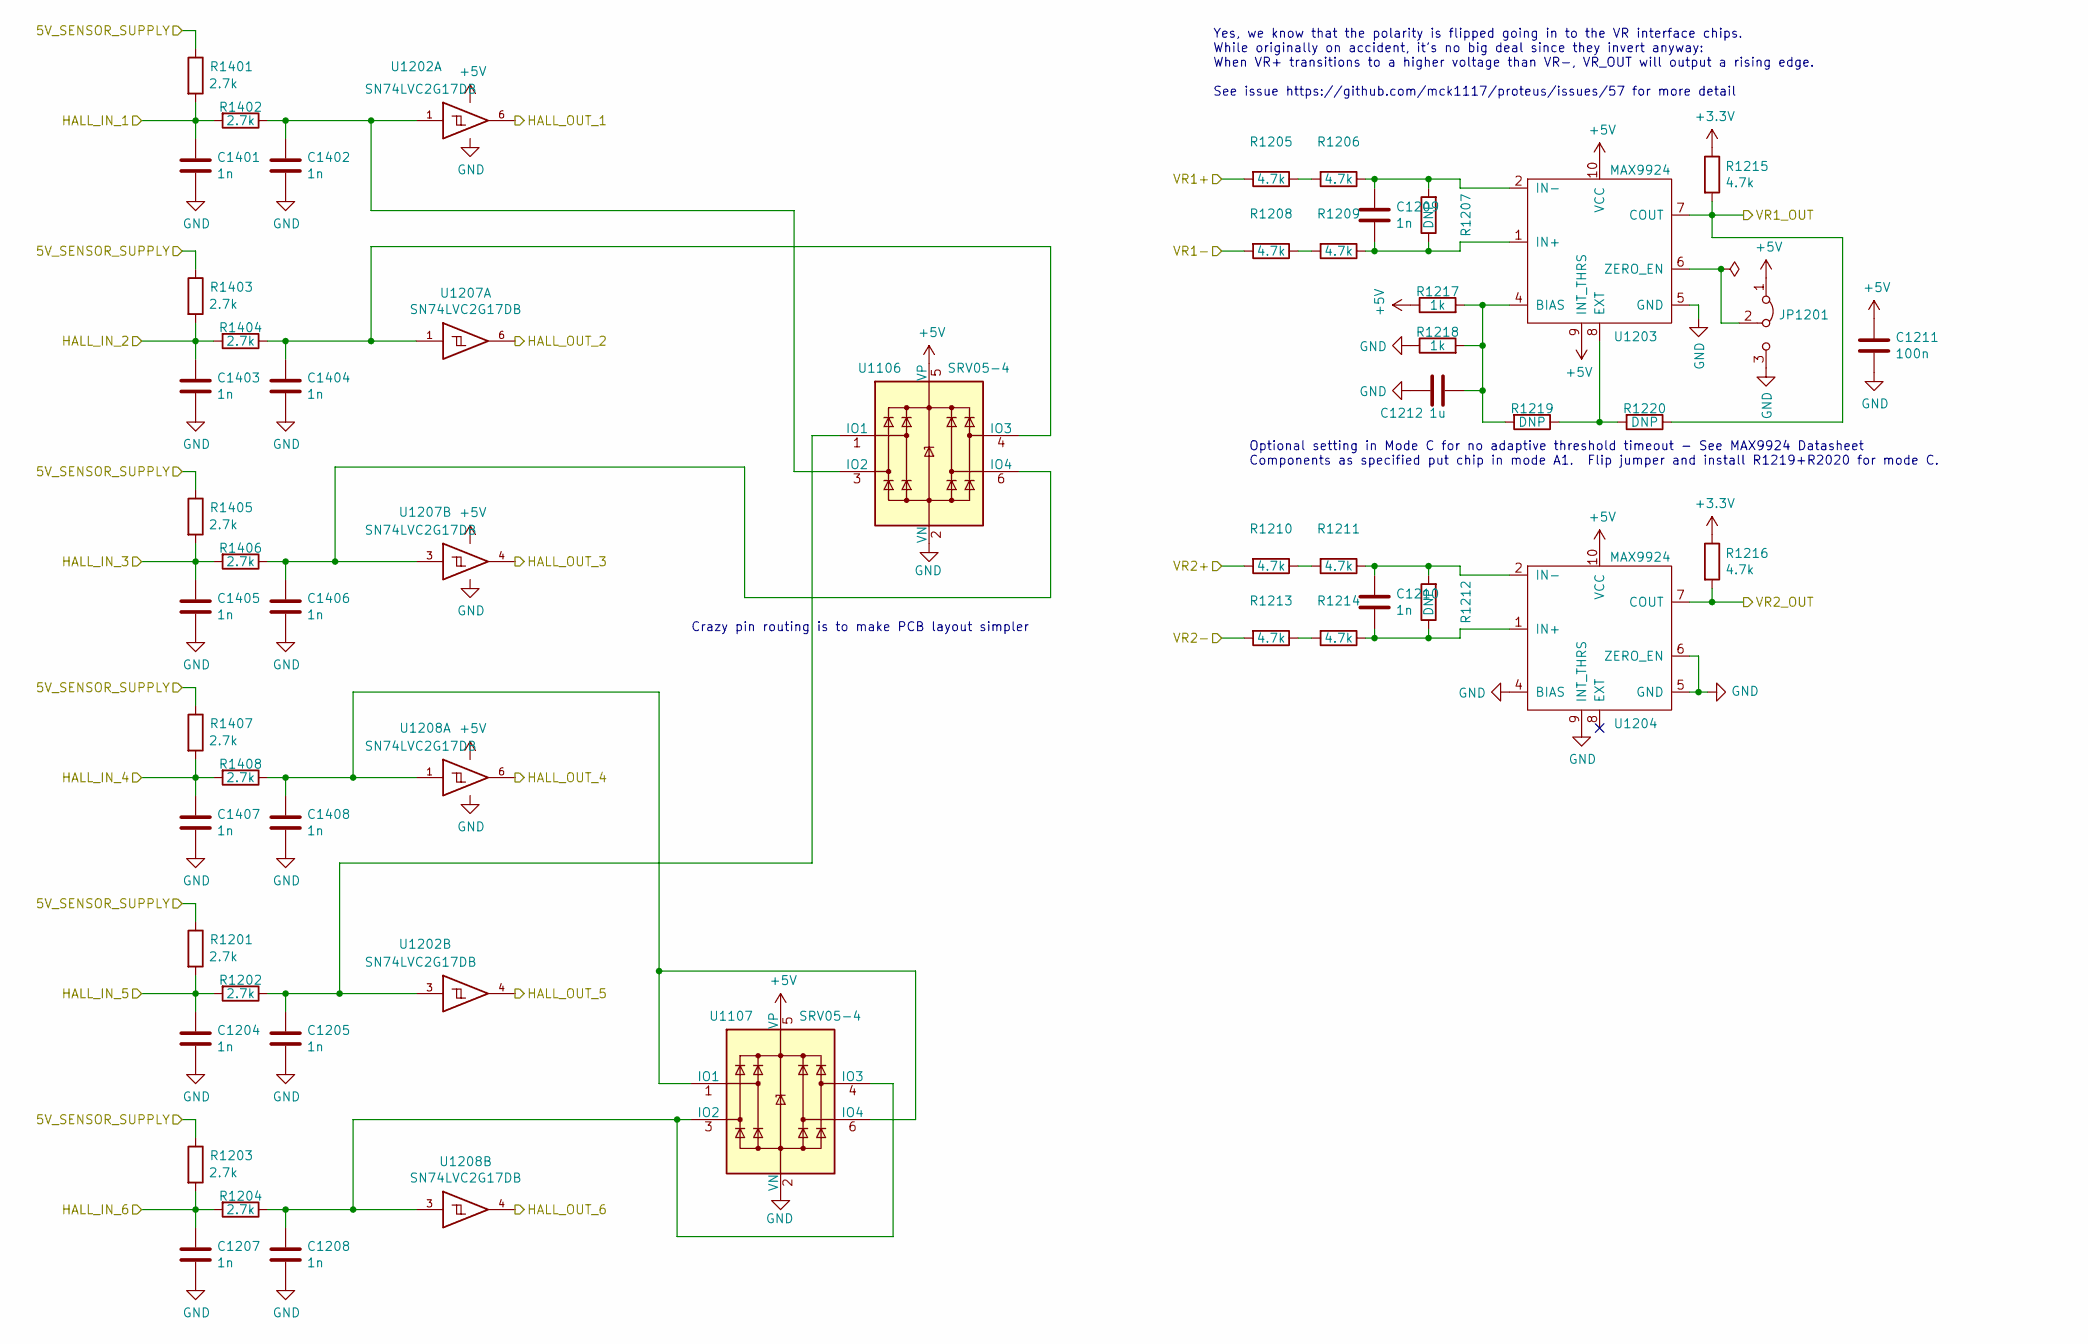
[picture p50: schematic triggers.kicad_sch, rusEfi Proteus v2.0]

Parts:
C1204, C1205, C1207, C1208, C1209, C1210, C1401, C1402, C1403, C1404, C1405, C1406, C1407, C1408: 1n; C_0603_1608Metric; LCSC C1588
C1211: 100n; C_0603_1608Metric; LCSC C14663
C1212: 1u; C_0603_1608Metric; LCSC C15849
JP1201: Jumper_3_Bridged12; SolderJumper-3_P1.3mm_Bridged12_RoundedPad1.0x1.5mm; LCSC N/A
R1201, R1202, R1203, R1204, R1401, R1402, R1403, R1404, R1405, R1406, R1407, R1408: 2.7k; R_0603_1608Metric; LCSC C13167
R1205, R1206, R1208, R1209, R1210, R1211, R1213, R1214, R1215, R1216: 4.7k; R_0805_2012Metric; LCSC C17673
R1207, R1212: DNP; R_0805_2012Metric; LCSC DNP
R1217, R1218: 1k; R_0603_1608Metric; LCSC C11702
R1219, R1220: DNP; R_0805_2012Metric_Pad1.15x1.40mm_HandSolder; LCSC DNP
U1106, U1107: SRV05-4; SOT-23-6
U1202, U1207, U1208: SN74LVC2G17DB; SOT-23-6; LCSC C10429
U1203, U1204: MAX9924; MSOP-10_3x3mm_P0.5mm; LCSC N/A

Connections:
+3V3: R1215.1, R1216.1; also elsewhere on the board
+5V: C1211.1, JP1201.1 (A), R1217.1, U1106.5 (VP), U1107.5 (VP), U1202.5 (VCC), U1203.9 (INT_THRS), U1203.10 (VCC), U1204.10 (VCC), U1207.5 (VCC), U1208.5 (VCC); also elsewhere on the board
/5V_SENSOR_1: R1201.1, R1203.1, R1401.1, R1403.1, R1405.1, R1407.1; also elsewhere on the board
/DIGITAL_1: C1401.1, R1401.2, R1402.2; also elsewhere on the board
/DIGITAL_2: C1403.1, R1403.2, R1404.2; also elsewhere on the board
/DIGITAL_3: C1405.1, R1405.2, R1406.2; also elsewhere on the board
/DIGITAL_4: C1407.1, R1407.2, R1408.2; also elsewhere on the board
/DIGITAL_5: C1204.1, R1201.2, R1202.2; also elsewhere on the board
/DIGITAL_6: C1207.1, R1203.2, R1204.2; also elsewhere on the board
/VR1+: R1205.2; also elsewhere on the board
/VR1-: R1208.2; also elsewhere on the board
/VR2+: R1210.2; also elsewhere on the board
/VR2-: R1213.2; also elsewhere on the board
/mcu/DIGITAL1: U1202.6; also elsewhere on the board
/mcu/DIGITAL2: U1207.6; also elsewhere on the board
/mcu/DIGITAL3: U1207.4; also elsewhere on the board
/mcu/DIGITAL4: U1208.6; also elsewhere on the board
/mcu/DIGITAL5: U1202.4; also elsewhere on the board
/mcu/DIGITAL6: U1208.4; also elsewhere on the board
/mcu/VR_1: R1215.2, R1220.1, U1203.7 (COUT); also elsewhere on the board
/mcu/VR_2: R1216.2, U1204.7 (COUT); also elsewhere on the board
GND: C1204.2, C1205.2, C1207.2, C1208.2, C1211.2, C1212.2, C1401.2, C1402.2, C1403.2, C1404.2, C1405.2, C1406.2, C1407.2, C1408.2, JP1201.3 (B), R1218.1, U1106.2 (VN), U1107.2 (VN), U1202.2 (GND), U1203.5 (GND), U1204.4 (BIAS), U1204.5 (GND), U1204.6 (ZERO_EN), U1204.9 (INT_THRS), U1207.2 (GND), U1208.2 (GND); also elsewhere on the board
unnamed: JP1201.2 (C), U1203.6 (ZERO_EN)
unnamed: R1205.1, R1206.2
unnamed: R1208.1, R1209.2
unnamed: R1210.1, R1211.2
unnamed: R1213.1, R1214.2
unnamed: C1205.1, R1202.1, U1106.1 (IO1), U1202.3
unnamed: C1402.1, R1402.1, U1106.3 (IO2), U1202.1
unnamed: C1404.1, R1404.1, U1106.4 (IO3), U1207.1
unnamed: C1406.1, R1406.1, U1106.6 (IO4), U1207.3
unnamed: C1408.1, R1408.1, U1107.1 (IO1), U1107.6 (IO4), U1208.1
unnamed: C1208.1, R1204.1, U1107.3 (IO2), U1107.4 (IO3), U1208.3
unnamed: C1212.1, R1217.2, R1218.2, R1219.2, U1203.4 (BIAS)
unnamed: R1219.1, R1220.2, U1203.8 (EXT)
unnamed: C1209.2, R1207.1, R1209.1, U1203.1 (IN+)
unnamed: C1209.1, R1206.1, R1207.2, U1203.2 (IN-)
unnamed: C1210.2, R1212.1, R1214.1, U1204.1 (IN+)
unnamed: C1210.1, R1211.1, R1212.2, U1204.2 (IN-)

Notes on the sheet:
Crazy pin routing is to make PCB layout simpler
Optional setting in Mode C for no adaptive threshold timeout - See MAX9924 Datasheet Components as specified put chip in mode A1. Flip jumper and install R1219+R2020 for mode C.
Yes, we know that the polarity is flipped going in to the VR interface chips. While originally on accident, it’s no big deal since they invert anyway: When VR+ transitions to a higher voltage than VR-, VR_OUT will output a rising edge. See issue https://github.com/mck1117/proteus/issues/57 for more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

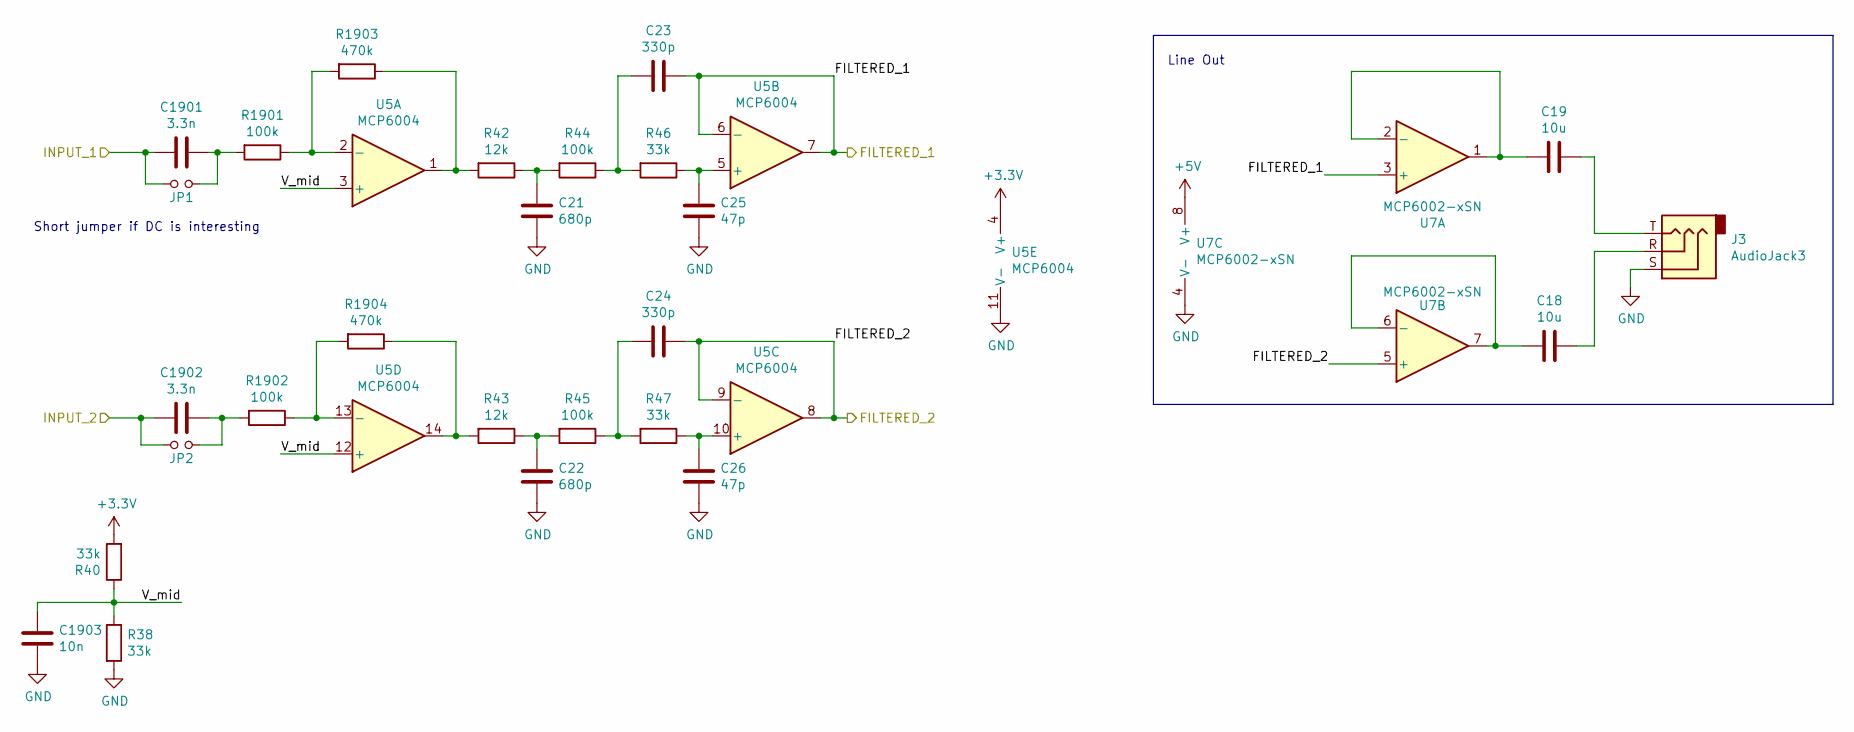
[picture p51: schematic knock.kicad_sch, rusEfi Proteus v2.0]

Parts:
C18, C19: 10u; C_1206_3216Metric; LCSC C13585
C21, C22: 680p; C_0603_1608Metric; LCSC C1630
C23, C24: 330p; C_0603_1608Metric; LCSC C13533
C25, C26: 47p; C_0603_1608Metric; LCSC C1567
C1901, C1902: 3.3n; C_0805_2012Metric; LCSC C53175
C1903: 10n; C_0603_1608Metric; LCSC C57112
J3: AudioJack3; Jack_3.5mm_CUI_SJ1-3533NG_Horizontal; LCSC N/A
JP1, JP2: Jumper_NO_Small; SolderJumper-2_P1.3mm_Open_TrianglePad1.0x1.5mm; LCSC N/A
R38, R40, R46, R47: 33k; R_0603_1608Metric; LCSC C25779
R42, R43: 12k; R_0603_1608Metric; LCSC C25752
R44, R45, R1901, R1902: 100k; R_0603_1608Metric; LCSC C25741
R1903, R1904: 470k; R_0603_1608Metric; LCSC C25790
U5: MCP6004; TSSOP-14_4.4x5mm_P0.65mm; LCSC C50282
U7: MCP6002-xSN; SOIC-8_3.9x4.9mm_P1.27mm; LCSC C7377

Connections:
+3V3: R40.2, U5.4 (V+); also elsewhere on the board
+5V: U7.8 (V+); also elsewhere on the board
/KNOCK_1: C1901.2, JP1.1; also elsewhere on the board
/KNOCK_2: C1902.2, JP2.1; also elsewhere on the board
/knock/FILTERED_1: C23.2, U5.6 (-), U5.7, U7.3 (+); also elsewhere on the board
/knock/FILTERED_2: C24.2, U5.8, U5.9 (-), U7.5 (+); also elsewhere on the board
/knock/V_mid: C1903.2, R38.1, R40.1, U5.3 (+), U5.12 (+)
GND: C21.1, C22.1, C25.1, C26.1, C1903.1, J3.S, R38.2, U5.11 (V-), U7.4 (V-); also elsewhere on the board
unnamed: C18.1, J3.R
unnamed: C19.1, J3.T
unnamed: C21.2, R42.1, R44.2
unnamed: C22.2, R43.1, R45.2
unnamed: C23.1, R44.1, R46.2
unnamed: C24.1, R45.1, R47.2
unnamed: C1901.1, JP1.2, R1901.2
unnamed: C1902.1, JP2.2, R1902.2
unnamed: R42.2, R1903.1, U5.1
unnamed: R43.2, R1904.1, U5.14
unnamed: R1901.1, R1903.2, U5.2 (-)
unnamed: C25.2, R46.1, U5.5 (+)
unnamed: C26.2, R47.1, U5.10 (+)
unnamed: R1902.1, R1904.2, U5.13 (-)
unnamed: C19.2, U7.1, U7.2 (-)
unnamed: C18.2, U7.6 (-), U7.7

Notes on the sheet:
Line Out
Short jumper if DC is interesting

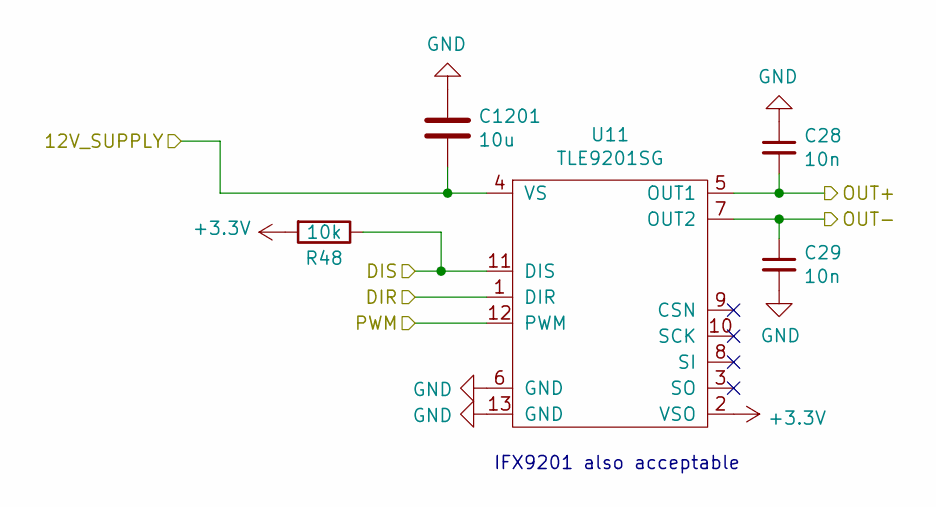
[picture p52: schematic etb-9201.kicad_sch, rusEfi Proteus v2.0]

Parts:
C28, C29: 10n; C_0603_1608Metric; LCSC C57112
C1201: 10u; C_1206_3216Metric; LCSC C13585
R48: 10k; R_0603_1608Metric; LCSC C25744
U11: TLE9201SG; Infineon_PG-DSO-12-9; LCSC C112633

Connections:
+3V3: R48.2, U11.2 (VSO); also elsewhere on the board
/12V_MR: C1201.2, U11.4 (VS); also elsewhere on the board
/ETB2+: C28.2, U11.5 (OUT1); also elsewhere on the board
/ETB2-: C29.1, U11.7 (OUT2); also elsewhere on the board
/etb-2/DIR: U11.1 (DIR); also elsewhere on the board
/etb-2/DIS: R48.1, U11.11 (DIS); also elsewhere on the board
/etb-2/PWM: U11.12 (PWM); also elsewhere on the board
GND: C28.1, C29.2, C1201.1, U11.6 (GND), U11.13 (GND); also elsewhere on the board

Parts of its further copies:
C27: 10u; C_1206_3216Metric; LCSC C13585
C1202, C1203: 10n; C_0603_1608Metric; LCSC C57112
R1001: 10k; R_0603_1608Metric; LCSC C25744
U10: TLE9201SG; Infineon_PG-DSO-12-9; LCSC C112633

Connections of its further copies:
+3V3: R1001.2, U10.2 (VSO); also elsewhere on the board
/12V_MR: C27.2, U10.4 (VS); also elsewhere on the board
/ETB1+: C1202.2, U10.5 (OUT1); also elsewhere on the board
/ETB1-: C1203.1, U10.7 (OUT2); also elsewhere on the board
/etb-1/DIR: U10.1 (DIR); also elsewhere on the board
/etb-1/DIS: R1001.1, U10.11 (DIS); also elsewhere on the board
/etb-1/PWM: U10.12 (PWM); also elsewhere on the board
GND: C27.1, C1202.1, C1203.2, U10.6 (GND), U10.13 (GND); also elsewhere on the board

Notes on the sheet:
IFX9201 also acceptable
