JRDMcLAREN/proteus-V2.0/proteus.kicad_pcb

## KiCad design proteus.kicad_pcb (continued)

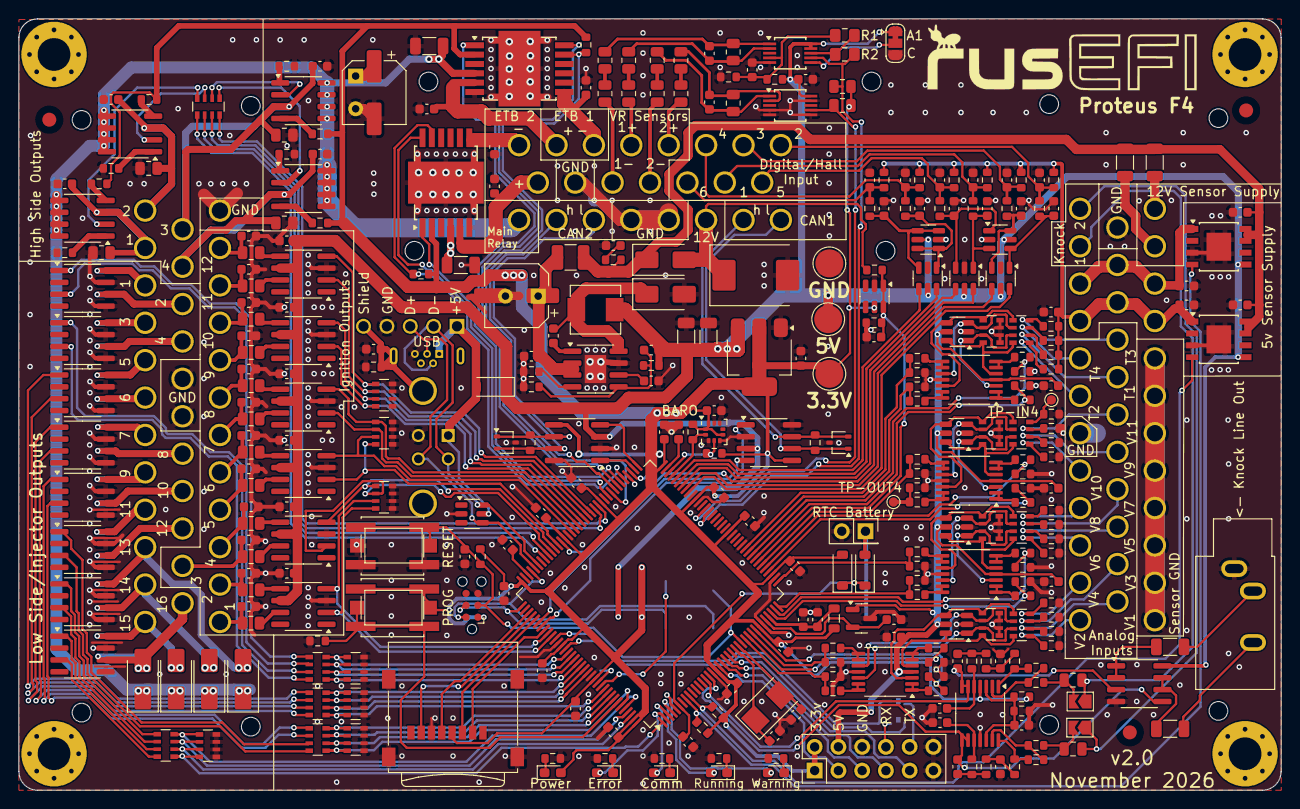
[picture p53: board proteus.kicad_pcb from above]

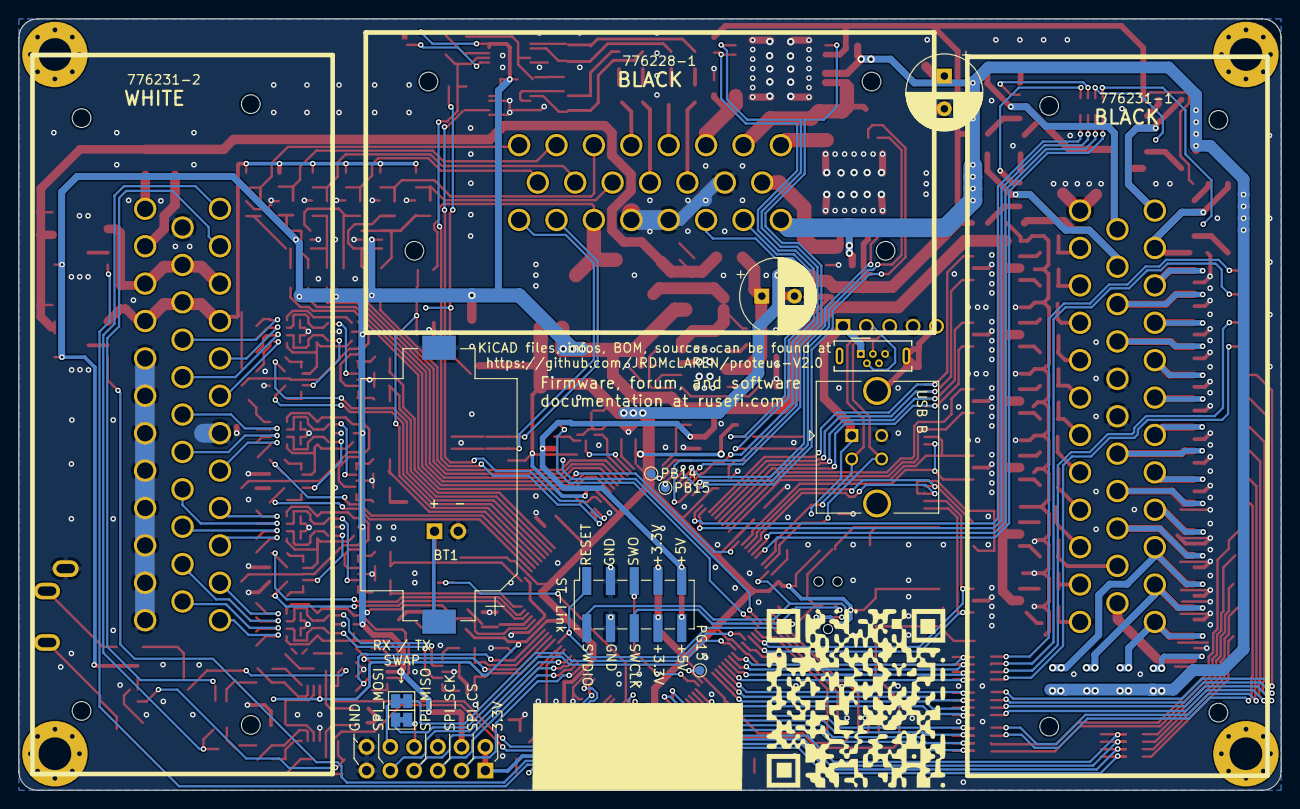
[picture p54: board proteus.kicad_pcb from below]

Board: 2 copper layers, 135.0 x 82.5 mm, 360 parts (14 on the bottom side), 305 nets.

Other parts of the board:
LOGO: LOGO; mre_logo
M3, M3#2, M3#3, M3#4: MountingHole_3.5mm_Pad_Via
